temurtas/Capstone_Duayenler/reports/Std_HW/Std_HW.tex

%%%%%%%%%%%%%%%%%%%%%%%%%%%%%%%%%%%%%%%%%
% Weekly Report 
% LaTeX Template
% Version 1.3 (26/10/2018)
% Modified by
% Enes TAŞTAN
% Erdem TUNA
% Halil TEMURTAŞ
%%%%%%%%%%%%%%%%%%%%%%%%%%%%%%%%%%%%%%%%%
%
%----------------------------------------------------------------------------------------
%	PACKAGES AND OTHER DOCUMENT CONFIGURATIONS
%----------------------------------------------------------------------------------------
\documentclass[a4paper,12pt]{article}
%-----packages------
\usepackage[a4paper, total={6.2in, 8.5in}, headheight=110pt]{geometry}
\usepackage[english]{babel}
\usepackage[utf8x]{inputenc}
\usepackage{amsmath}
\usepackage{graphicx}
\usepackage[colorinlistoftodos]{todonotes}
\usepackage{gensymb} % this could be problem
\usepackage{float}
\usepackage{fancyref}
\usepackage{subcaption}
\usepackage[toc,page]{appendix} %appendix package
\usepackage{xcolor}
\usepackage{listings}

\usepackage[export]{adjustbox}

\usepackage{xspace}
\usepackage{amssymb}
\usepackage{nicefrac}
\usepackage{gensymb}
\usepackage{fancyhdr}
\usepackage{lipsum}  % for lipsum
\usepackage[final]{pdfpages}  % pdf include
\usepackage{array} %allows more options in tables
\usepackage{pgfplots,pgf,tikz} %coding plots in latex
\usepackage{capt-of} % allows caption outside the figure environment
\usepackage[export]{adjustbox} %more options for adjusting the images
\usepackage{multicol,multirow,slashbox} % allows tables like table1
%\usepackage[hyperfootnotes=false]{hyperref} % clickable references
\usepackage{epstopdf} % useful when matlab is involved
%\usepackage{placeins} % prevents the text after figure to go above figure with \FloatBarrier 
%\usepackage{listingsutf8,mcode} %import .m or any other code file mcode is for matlab highlighting

%-----end of packages
\input{../../Documents/configuration.tex}

\pagestyle{fancy}
\setlength\headheight{130pt}
\setlength{\footskip}{2.5cm}
\fancyhead[LO,LE]{\textbf{Duayenler Ltd. Şti.} \\ \textbf{Members :\\ } 
			Enes Taştan, \ \ \  2068989, 0543 683 4336 \\ 
			Halil Temurtaş, 2094522, 0531 632 2194  		
}
\fancyhead[RO,RE]{
			\textbf{November 19, 2018} \\
			Sarper Sertel, 2094449, 0542 515 6039 \\
			Erdem Tuna, 2167419, 0535 256 3320 \\ 
			İlker Sağlık, 2094423, 0541 722 9573}
%\fancyhead[RO]{Sarper Sertel (05435156039),\\Enes Taştan (05436834336), Erdem Tuna (05352563320),\\Halil Temurtaş (05316322194), İlker Sağlık (05417229573)}
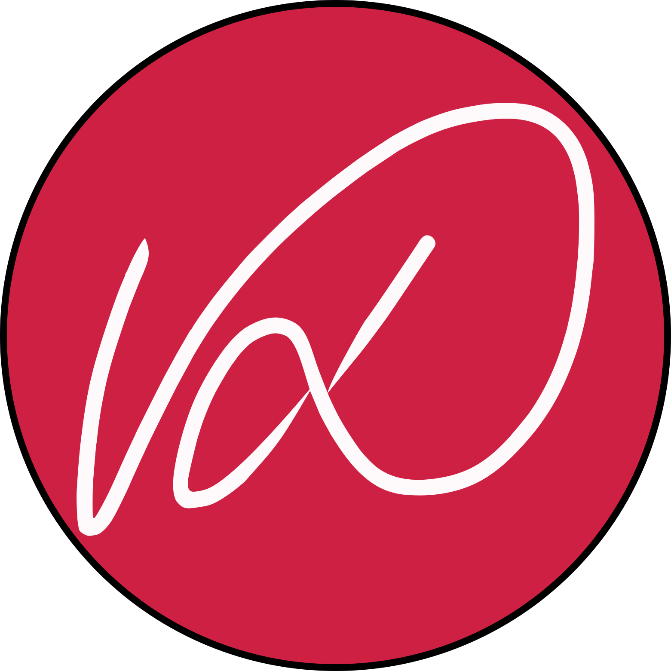
[picture p82: Documents/logos/logo2-page-with-stroke.png]
\rfoot{}

\begin{document}

	\begin{figure}[H]
		\centering
		\setlength{\unitlength}{\textwidth} 
		
	\end{figure}
	
\vspace*{0.5cm}
\begin{center}
	\Large\textbf{Standard Committee Homework}
	\end{center}

\section{Standard Committee Homework}
\subsection{Path Structure}

Our proposed material is styrofoam. Isolation type styrofoams are more durable and strong compared to ordinary ones. A sample can be seen in \textit{Figure \ref{strofor}}
\begin{figure}[h]
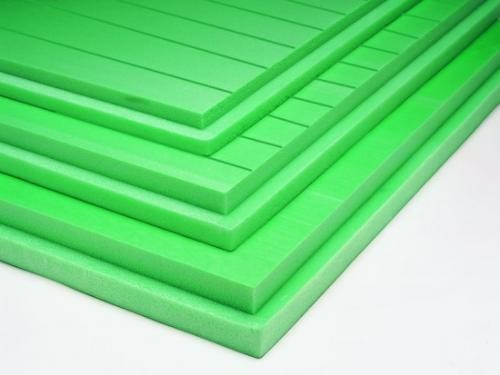
[picture p83: reports/Std_HW/strofor.jpg]
	
	\caption{A sample material}\label{strofor}
\end{figure}

The green color RGB(0,255,0) is proposed as the path color.

\subsection{Vehicle Appearance}

A plate with dimensions 8cm x 10 cm should be installed with 3cm levitation from ground level. The color of the plate should be blue RGB(0,0,255).

\end{document}

%----samples------
%\begin{itemize}
%\item Item
%\item Item
%\end{itemize}

%\begin{figure}[H]
%\center
%\setlength{\unitlength}{\textwidth} 
%\includegraphics[width=0.7\unitlength]{images/logo1}
%\caption{\label{fig:logo}Logo }
%\end{figure}

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
