temurtas/Capstone_Duayenler/reports/weekly_reports/2019_03_19_Weekly_Report/2019_03_05_Weekly_Report.tex

%%%%%%%%%%%%%%%%%%%%%%%%%%%%%%%%%%%%%%%%%
% Weekly Report 
% LaTeX Template
% Version 1.3 (26/10/2018)
% Modified by
% Enes TAŞTAN
% Erdem TUNA
% Halil TEMURTAŞ
%%%%%%%%%%%%%%%%%%%%%%%%%%%%%%%%%%%%%%%%%
%
%----------------------------------------------------------------------------------------
%	PACKAGES AND OTHER DOCUMENT CONFIGURATIONS
%----------------------------------------------------------------------------------------
\documentclass[a4paper,12pt]{article}
%-----packages------
\usepackage[a4paper, total={6.2in, 8.5in}, headheight=110pt]{geometry}
\usepackage[english]{babel}
\usepackage[utf8x]{inputenc}
\usepackage{amsmath}
\usepackage{graphicx}
\usepackage[colorinlistoftodos]{todonotes}
\usepackage{gensymb} % this could be problem
\usepackage{float}
\usepackage{fancyref}
\usepackage{subcaption}
\usepackage[toc,page]{appendix} %appendix package
\usepackage{xcolor}
\usepackage{listings}

\usepackage[export]{adjustbox}

\usepackage{xspace}
\usepackage{amssymb}
\usepackage{nicefrac}
\usepackage{gensymb}
\usepackage{fancyhdr}
\usepackage{lipsum}  % for lipsum
\usepackage[final]{pdfpages}  % pdf include
\usepackage{array} %allows more options in tables
\usepackage{pgfplots,pgf,tikz} %coding plots in latex
\usepackage{capt-of} % allows caption outside the figure environment
\usepackage[export]{adjustbox} %more options for adjusting the images
\usepackage{multicol,multirow,slashbox} % allows tables like table1
%\usepackage[hyperfootnotes=false]{hyperref} % clickable references
\usepackage{epstopdf} % useful when matlab is involved
%\usepackage{placeins} % prevents the text after figure to go above figure with \FloatBarrier 
%\usepackage{listingsutf8,mcode} %import .m or any other code file mcode is for matlab highlighting

%-----end of packages
\input{../../../documents/configuration.tex}

\pagestyle{fancy}
\setlength\headheight{130pt}
\setlength{\footskip}{2.5cm}
\fancyhead[LO,LE]{\textbf{Duayenler Ltd. Şti.} \\ \textbf{Members :\\ } 
			Enes Taştan, \ \ \  2068989, 0543 683 4336 \\ 
			Halil Temurtaş, 2094522, 0531 632 2194  		
}
\fancyhead[RO,RE]{
			\textbf{March 19, 2019} \\
			Sarper Sertel, 2094449, 0542 515 6039 \\
			Erdem Tuna, 2167419, 0535 256 3320 \\ 
			İlker Sağlık, 2094423, 0541 722 9573}
%\fancyhead[RO]{Sarper Sertel (05435156039),\\Enes Taştan (05436834336), Erdem Tuna (05352563320),\\Halil Temurtaş (05316322194), İlker Sağlık (05417229573)}
\rfoot{}

\begin{document}
	
\begin{figure}
	\vspace*{-.7cm}
	\centering
	\begin{figure}[H]
		\centering
		\setlength{\unitlength}{\textwidth} 
		
	\end{figure}
\end{figure}
\vspace*{-1.7cm}
\begin{center}
	\Large\textbf{March 12 - March 18 Weekly Report}
	\end{center}
\section{Progress}
\begin{itemize}
 
	 \item Chassis assembly is refined and finalized.
	 \item Step up and step down converters are imported to the system. However, they burnt out.
	 \item Vehicle drive with controller is tested. Some of problems were: PWM output of pins were not identical, small PWM difference yielded big voltage difference in motor drivers. This problem took a long time to fix.
	 \item Two distance sensors for handshake are implemented on the vehicle and tested with software.

	\end{itemize}
\section{Plans}
\begin{itemize}
\item PID controller design parameter tuning.

	\begin{figure}[H]
	\center
	\setlength{\unitlength}{\textwidth} 
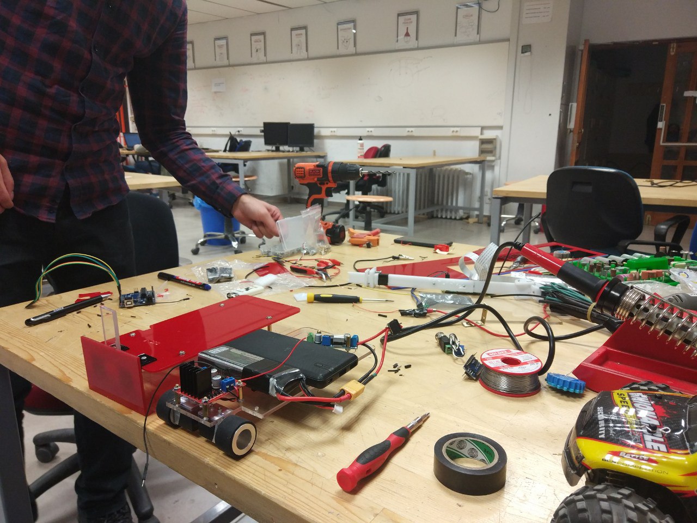
[picture p85: reports/weekly_reports/2019_03_19_Weekly_Report/photo5776198910077939979.jpg]
	
	\caption{\label{fig:photo5776198910077939979} As Chassis is being Assembled. }
\end{figure}

	\begin{figure}[H]
		\center
		\setlength{\unitlength}{\textwidth} 
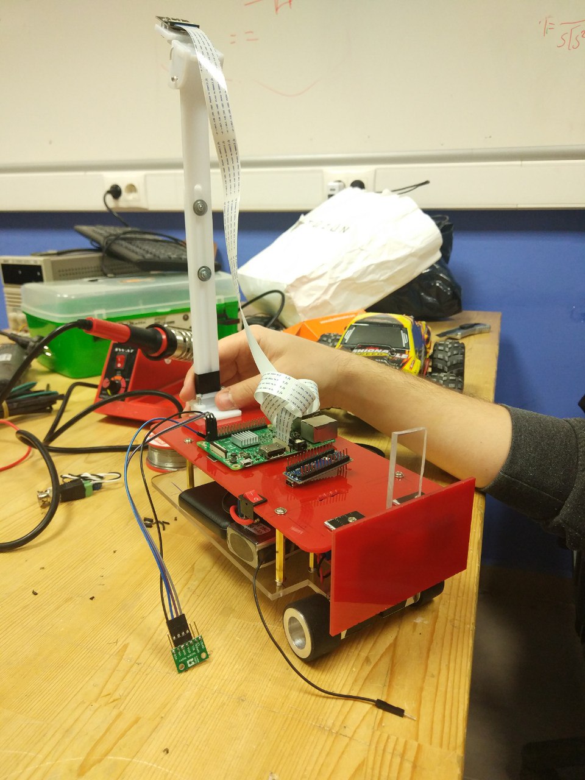
[picture p86: reports/weekly_reports/2019_03_19_Weekly_Report/photo5776198910077939977.jpg]
		
		\caption{\label{fig:photo5776198910077939977} Chassis Assembly }
	\end{figure}
		
\end{itemize}
%\begin{appendices}
%\section{Photos}
%
%	\begin{figure}[H]
%		\center
%		\setlength{\unitlength}{\textwidth} 
%		\includegraphics[width=0.75\unitlength]{efso}
%		\caption{\label{fig:efso} [Left]Output of Our Image Detection Algorithm Under Low Light Conditions, The Red Lines represents the Detected Line Edges  and the [Right] Original unprocessed Photo }
%	\end{figure}

%\end{appendices}

\end{document}

%----samples------
%\begin{itemize}
%\item Item
%\item Item
%\end{itemize}

%\begin{figure}[H]
%\center
%\setlength{\unitlength}{\textwidth} 
%\includegraphics[width=0.7\unitlength]{images/logo1}
%\caption{\label{fig:logo}Logo }
%\end{figure}

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
