temurtas/Capstone_Duayenler/reports/weekly_reports/2019_02_26_Weekly_Report/2019_02_26_Weekly_Report.tex

%%%%%%%%%%%%%%%%%%%%%%%%%%%%%%%%%%%%%%%%%
% Weekly Report 
% LaTeX Template
% Version 1.3 (26/10/2018)
% Modified by
% Enes TAŞTAN
% Erdem TUNA
% Halil TEMURTAŞ
%%%%%%%%%%%%%%%%%%%%%%%%%%%%%%%%%%%%%%%%%
%
%----------------------------------------------------------------------------------------
%	PACKAGES AND OTHER DOCUMENT CONFIGURATIONS
%----------------------------------------------------------------------------------------
\documentclass[a4paper,12pt]{article}
%-----packages------
\usepackage[a4paper, total={6.2in, 8.5in}, headheight=110pt]{geometry}
\usepackage[english]{babel}
\usepackage[utf8x]{inputenc}
\usepackage{amsmath}
\usepackage{graphicx}
\usepackage[colorinlistoftodos]{todonotes}
\usepackage{gensymb} % this could be problem
\usepackage{float}
\usepackage{fancyref}
\usepackage{subcaption}
\usepackage[toc,page]{appendix} %appendix package
\usepackage{xcolor}
\usepackage{listings}

\usepackage[export]{adjustbox}

\usepackage{xspace}
\usepackage{amssymb}
\usepackage{nicefrac}
\usepackage{gensymb}
\usepackage{fancyhdr}
\usepackage{lipsum}  % for lipsum
\usepackage[final]{pdfpages}  % pdf include
\usepackage{array} %allows more options in tables
\usepackage{pgfplots,pgf,tikz} %coding plots in latex
\usepackage{capt-of} % allows caption outside the figure environment
\usepackage[export]{adjustbox} %more options for adjusting the images
\usepackage{multicol,multirow,slashbox} % allows tables like table1
%\usepackage[hyperfootnotes=false]{hyperref} % clickable references
\usepackage{epstopdf} % useful when matlab is involved
%\usepackage{placeins} % prevents the text after figure to go above figure with \FloatBarrier 
%\usepackage{listingsutf8,mcode} %import .m or any other code file mcode is for matlab highlighting

%-----end of packages
\input{../../../documents/configuration.tex}

\pagestyle{fancy}
\setlength\headheight{130pt}
\setlength{\footskip}{2.5cm}
\fancyhead[LO,LE]{\textbf{Duayenler Ltd. Şti.} \\ \textbf{Members :\\ } 
			Enes Taştan, \ \ \  2068989, 0543 683 4336 \\ 
			Halil Temurtaş, 2094522, 0531 632 2194  		
}
\fancyhead[RO,RE]{
			\textbf{February 26, 2019} \\
			Sarper Sertel, 2094449, 0542 515 6039 \\
			Erdem Tuna, 2167419, 0535 256 3320 \\ 
			İlker Sağlık, 2094423, 0541 722 9573}
%\fancyhead[RO]{Sarper Sertel (05435156039),\\Enes Taştan (05436834336), Erdem Tuna (05352563320),\\Halil Temurtaş (05316322194), İlker Sağlık (05417229573)}
\rfoot{}

\begin{document}
	
\begin{figure}
	\vspace*{-.7cm}
	\centering
	\begin{figure}[H]
		\centering
		\setlength{\unitlength}{\textwidth} 
		
	\end{figure}
\end{figure}
\vspace*{-1.7cm}
\begin{center}
	\Large\textbf{February 19 - 25 Weekly Report}
	\end{center}
\section{Progress}
\begin{itemize}
	\item Lane detection tests were conducted with different disturbances on different locations of the path. Possible detection errors were again analysed. An example case can be seen at \textit{Figure~\ref{fig:lane-analysis-1}}.

		\begin{figure}[H]
			\center
			\setlength{\unitlength}{\textwidth} 
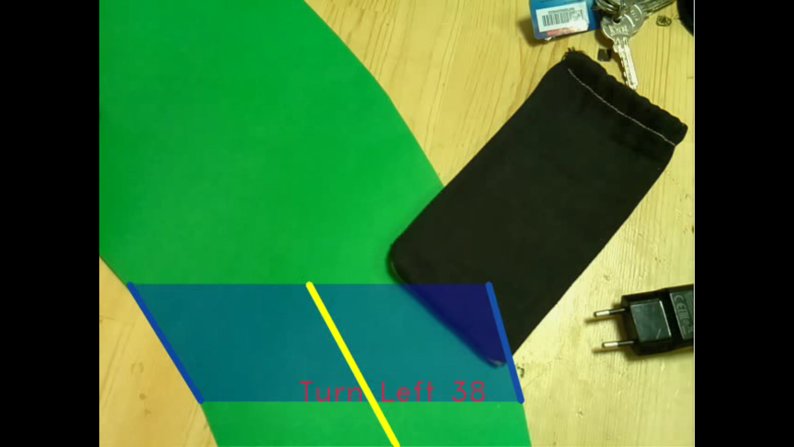
[picture p87: reports/weekly_reports/2019_02_26_Weekly_Report/lane_det.png]
			
			\caption{\label{fig:lane-analysis-1} Possible Problem on the Path and the Algorithm Output}
		\end{figure}
			
	 \item The chassis parts were drawn in Solidworks. And the placements of the components on top of the chassis were discussed. The main components can be seen from the \textit{Figure~\ref{fig:chass}}. The mounting bracket for the motor can be seen at \textit{Figure~\ref{fig:brac}}. 
	 
	 \item Initial consideration on system modelling via Bump Test were discussed. A simulink model was drawn for the expected overdamped system with pure delay. The model can be seen from the \textit{Figure~\ref{fig:cont}}.  
    
	    \begin{figure}[H]
			\center
			\setlength{\unitlength}{\textwidth} 
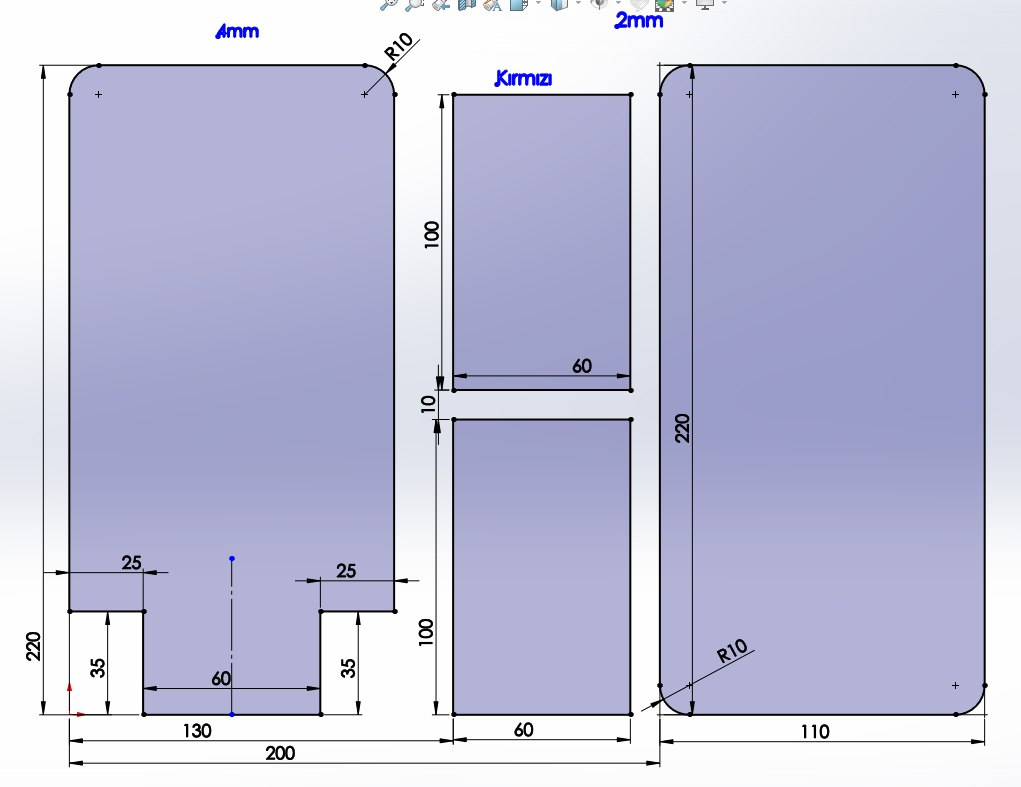
[picture p88: reports/weekly_reports/2019_02_26_Weekly_Report/sasi.jpg]
			
			\caption{\label{fig:chass} Main Components of the Chassis}
		\end{figure}
		
		\begin{figure}[H]
			\center
			\setlength{\unitlength}{\textwidth} 
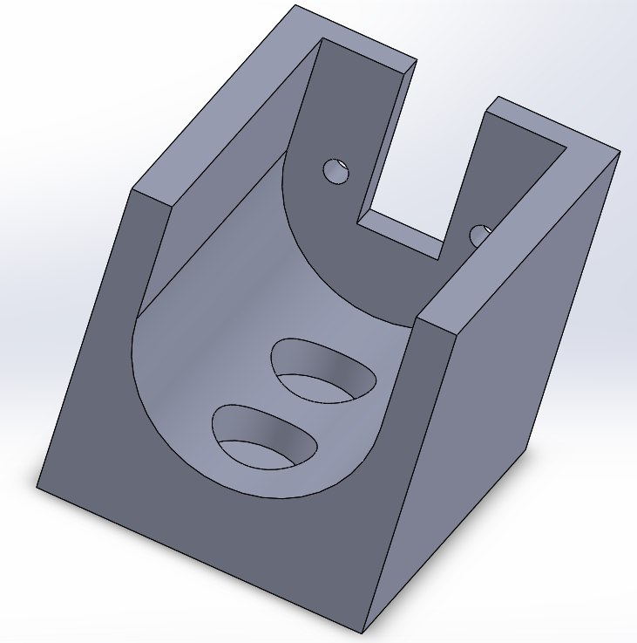
[picture p89: reports/weekly_reports/2019_02_26_Weekly_Report/motor_conn.jpg]
			
			\caption{\label{fig:brac} Mounting Bracket for the Motor}
		\end{figure}

		\begin{figure}[H]
			\center
			\setlength{\unitlength}{\textwidth} 
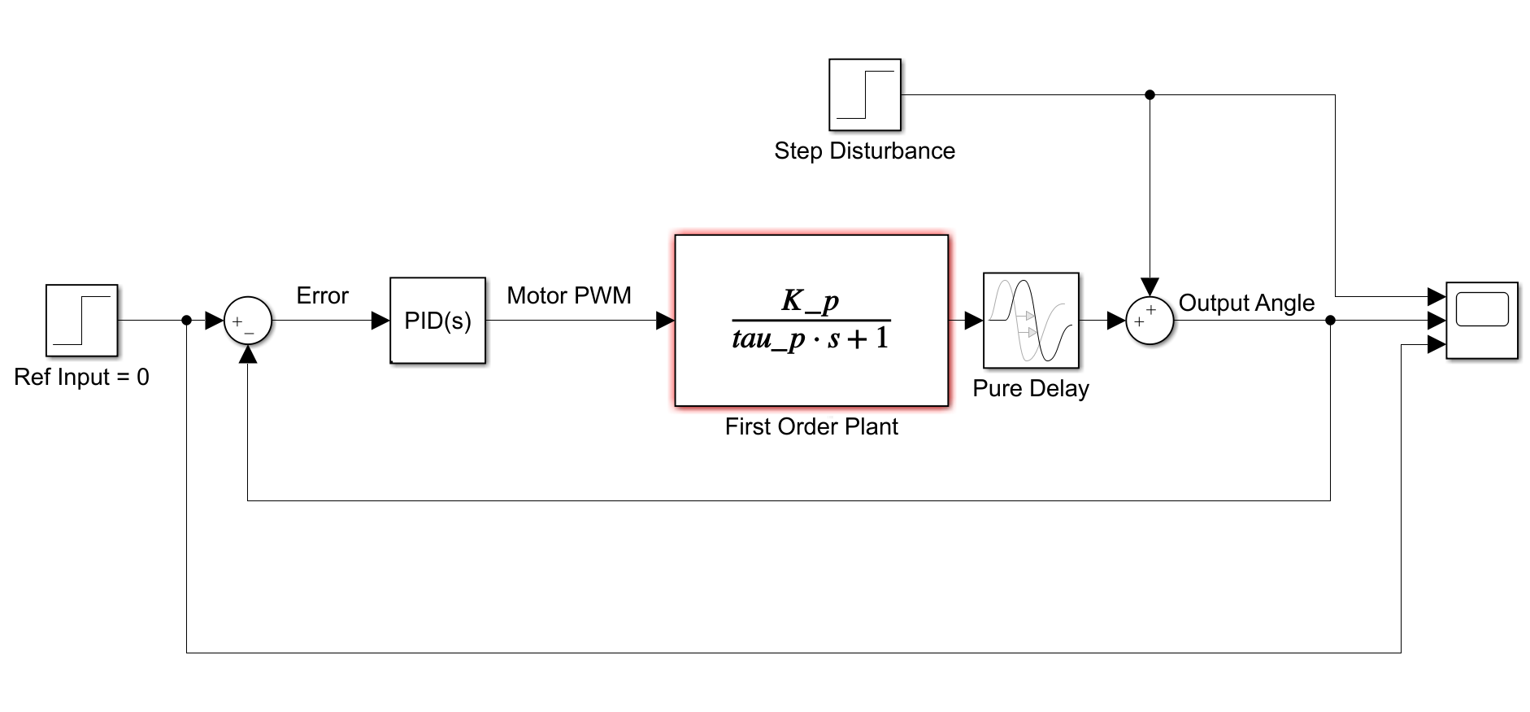
[picture p90: reports/weekly_reports/2019_02_26_Weekly_Report/cont.png]
			
			\caption{\label{fig:cont} A Simulink Model for the Expected Overdamped System}
		\end{figure}
	
	\end{itemize}
\section{Plans}
\begin{itemize}
\item New chassis will be built.
\item Initial attempts to tune PID controller for the lateral movement of the vehicle.  
\end{itemize}

\section{Problems}
\begin{itemize}
	\item The method for getting step response step response. Two alternatives can be seen from \textit{Figures~\ref{fig:bump1}~\&~\ref{fig:bump2}}.
\end{itemize}

		\begin{figure}[H]
			\center
			\setlength{\unitlength}{\textwidth} 
			
			\caption{\label{fig:bump1} A Bump Test Set-Up for Distance Control System }
		\end{figure}

		\begin{figure}[H]
			\center
			\setlength{\unitlength}{\textwidth} 
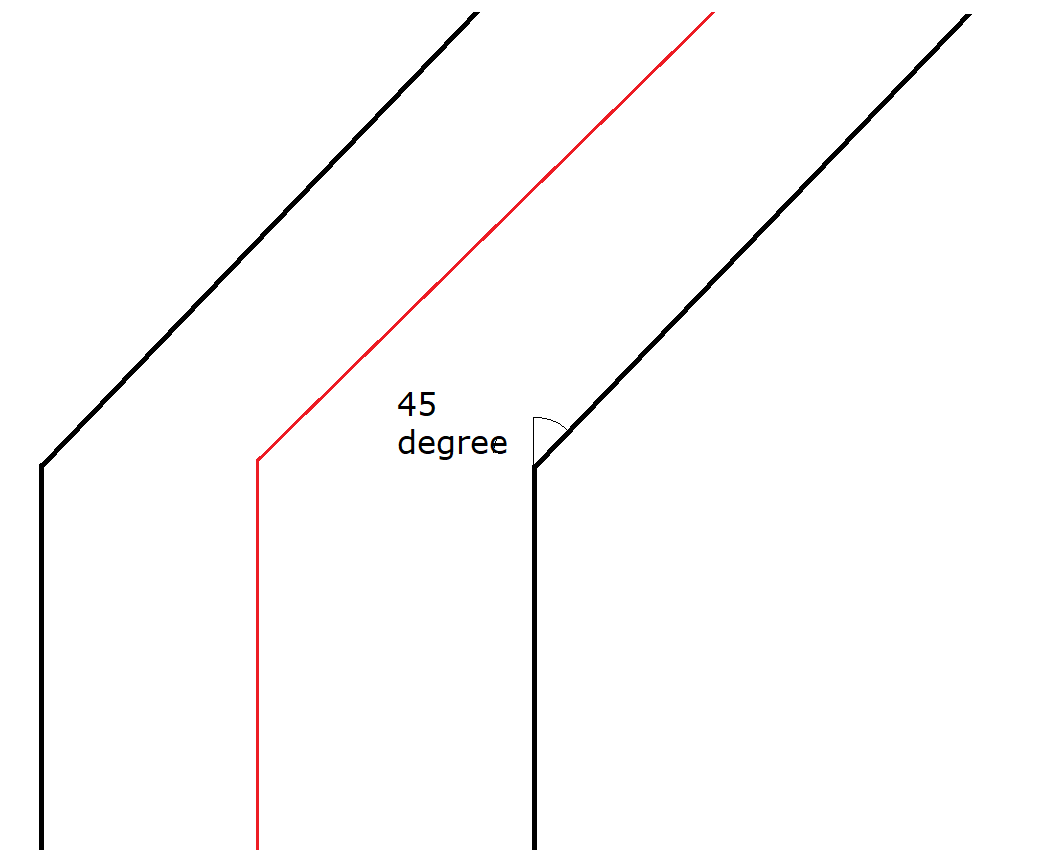
[picture p91: reports/weekly_reports/2019_02_26_Weekly_Report/bump_test_ang.png]
			
			\caption{\label{fig:bump2} A Bump Test Set-Up for Angle Control System}
		\end{figure}

%\begin{appendices}
%\section{Photos}
%
%	\begin{figure}[H]
%		\center
%		\setlength{\unitlength}{\textwidth} 
%		\includegraphics[width=0.75\unitlength]{efso}
%		\caption{\label{fig:efso} [Left]Output of Our Image Detection Algorithm Under Low Light Conditions, The Red Lines represents the Detected Line Edges  and the [Right] Original unprocessed Photo }
%	\end{figure}

%\end{appendices}

\end{document}

%----samples------
%\begin{itemize}
%\item Item
%\item Item
%\end{itemize}

%\begin{figure}[H]
%\center
%\setlength{\unitlength}{\textwidth} 
%\includegraphics[width=0.7\unitlength]{images/logo1}
%\caption{\label{fig:logo}Logo }
%\end{figure}

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
