temurtas/Capstone_Duayenler/resources/expenses.md

### Expenses

Expenses are listed below. 
Please write only the name (not surname) with same capitalization!

| Buyer  | Item  | Cost  | Paid Back?  |
|---|---|---|---|
| Enes | Asma Kilit  | 6 TL |  **YES**  |
| Sarper | Kalemx2 | 12 TL  | **YES**  |
| Halil  | Component | 151.55 TL  | **YES**  |
| Enes | Component | 189.55 TL  | **YES**  |
| Enes | Anahtar Çekimi | 10 TL  | **YES**  |
| İlker  | Colored A4  | 2.5 TL  | **YES** |
| Enes | RC Car | 150 TL  | **YES**  |
| Sarper | motor-teker | 150 TL  | **YES**  |
| Erdem  | Kamera_2 | 123.77 TL | **YES** |
| Enes | camera holder | 50 TL  | **YES**  |
| Enes | Strafor | 24 TL  | **YES**  |
| Erdem | Rapor | 13 TL  | **YES**  |
| Halil | Robotistan | 208.43 TL | **YES** | 
| Enes | Konnektör | 5 TL |**YES**| 
| Enes | ikinci sensör + nano | 155 TL | **NO**| 
| Sarper | İğrenÇ karton | 32 TL  | **NO**  |
| Enes | şase giderleri | 55 TL  | **NO**  |
| Sarper | ilk şase pleksi | 40 TL  | **NO**  |
| Halil | Yapıştırıcı/Karton vs. | 75 TL | |**NO**|
| Enes | Motor | 185.76 TL |**NO**|
| Enes | Robotistan (27 şubat)  | 114.71 TL  | **NO**  |
| İlker | Sensor | 66.58 TL | **NO** |
| Erdem | Köpük | 51.60 TL | **NO** |
----------------------------------------

Aşağısı Totaller

| Person | Total Spent  | Average Spent  | Debt  |
|---|---|---|---|
| Erdem  | 51.6 TL | 155.13 TL | -103.53 TL | 
| Enes | 510.47 TL | 155.13 TL | +355.34 TL  |
| Halil  | 75 TL | 155.13 TL | -80.13 TL |
| Sarper | 72 TL | 155.13 TL | -83.13 TL |
| İlker  | 66.58 TL | 155.13 TL | -88.55 TL |
