temurtas/Capstone_Duayenler/reports/final_report/deliverables.docx

LIST OF DELIVARABLES

Deliverables of the product is listed as follows;

- Kobra 6.5 robot
- Li-Po batteries
- Li-Ion batteries
- Lane
- Flash stick with sofware
- User Manual
- USB Cable
