temurtas/Capstone_Duayenler/reports/conceptual_presentation/Duayenler_Conceptual_Presentation_Ilker.pptx

Vehicle Detection & External Communication
Subsystems

## Vehicle Detection Subsystem

- Problem
  - Detecting the opponent to be caught within 5cm range
  - Detecting the opponent if it reaches from back within 5cm
  - Giving meaningful data to Pi to trigger handshake protocol

DUAYENLER

## Vehicle Detection Subsystem

- Main Solution
  - Two time-of-flight distance sensors at the front and back

DUAYENLER

## Vehicle Detection Subsystem (Tests)


DUAYENLER

## External Communication System

- Problem
  - Communicating with the opponent via Wi-Fi protocol
  - Executing handshake protocol

DUAYENLER

## External Communication System

- Main Solution
  - An algorithm utilizing network programming

DUAYENLER

## External Communication System

- Main Solution
  - An algorithm utilizing network programming


DUAYENLER

## External Communication System(Results)

Duayenler as server:


Opponent as client:


DUAYENLER

## External Communication System(Results)

Duayenler as client:


Opponent as server:


DUAYENLER

## External Communication System

- Improvements to be done:
  - Distance sensor data should be added to the system
  - Client should not be connected to the hotspot manually
  - Client mode function should be able to run before server

DUAYENLER
