temurtas/Capstone_Duayenler/docs/reports/Duayenler_Proposal.pdf

Middle East Technical University

Department of

Electrical and Electronics Engineering

EE493 ENGINEERING DESIGN I

# Car Chasing Robot

# Proposal Report

### Supervisor: Assoc. Prof. Emre Ozkan ¨

### METU EE / C-112

Project Start: 4/10/2018
Project End: 26/5/2019
Project Budget: $450

Company Name : Duayenler Ltd. S¸ti.

Members | Title | ID | Phone
Sarper Sertel | Electronics Engineer | 2094449 0542 515 6039
Enes Ta¸stan | Hardware Design Engineer | 2068989 0543 683 4336
Erdem Tuna | Embedded Systems Engineer 2617419 0535 256 3320
Halil Temurta¸s Control Engineer | 2094522 0531 632 2194
˙Ilker Sa˘glık | Software Engineer | 2094423 0541 722 9573

### November 9, 2018

This page intentionally left blank.

1

## Contents

1 Executive Summary | 4
2 Introduction | 5
3 The Team | 5
4 Requirement Analysis | 7
5 Standards Section | 14
6 Solution Procedure | 15

2

7 Expected Deliverables | 20
8 Conclusion | 21
Appendix A Gannt Chart | 22

3

## 1 Executive Summary

Increasing demand on automobiles, encourages industry to produce more. The increase of car count in the traffic, makes the traffic flow more complex. In this scope, autonomous cars bring an innovative solution for reducing the complexity. Potential benefits of automated cars include smart use of fuel, safer traffic and increased mobility. To realize and come up with such solutions, DUAYENLER Ltd. S¸ti. (DUAYENLER) is founded by

five innovative and enthusiast electronics engineering students to intelligently automate the future of traffic.

DUAYENLER is composed of talented and diligent people from different disciplines to complete the envisioned problem. DUAYENLER consists of two engineers from computer area, two from electronics area and one from control area. Since realization of the problem requires combinations of different disciplines, DUAYENLER is qualified to accomplish the encountered problems.

DUAYENLER will address the need of autonomous cars. Thus, the aim of the proposed project is to design and construct a vehicle that can follow a closed path without a driver on board. Furthermore, the vehicle will be able to sense other vehicles on the road as well as handling the obstacles.

The vehicle will use camera vision and sensors to detect and understand environment. With the obtained data, the vehicle will operate in a way that it adjusts its direction and speed correctly. Additionally, if the vehicle detects another vehicle within 5 cm either at the front or at the back, it will activate the handshake protocol to communicate with the opponent and stop with positive signal.

The duration of the project is intended to last 33 weeks, starting from October, 1 2019 and ending in May, 26 2019. The estimated cost for research and development phase is $ 450 whereas mass production cost per vehicle will be at most $ 200. Along with the vehicle itself, DUAYENLER will provide its customers with deliverables such as user and technical manuals, elliptical race path, chargeable battery and battery charger. Also, the vehicle will have two (2) years of warranty.

4

## 2 Introduction

Driving is a common event that many people experience in their daily life. As time passes, human reflexes started to become insufficient for driving compared to fast pace of daily life in modern world. Together with the developments in the technology, new solutions are proposed to assist the driver such as lane tracking and emergency breaking systems. The ultimate version of such solutions are considered to be fully autonomous self-driving cars.

Self-driving vehicles are presented to the society as a solution that can facilitate people’s life in many ways. Fast operation of the electronics system allows faster response than humans can. A fast and a reliable operation of self-driving action can prevent many accidents and increase the safety of the roads in heavy traffics since the system is immune to human defects such as distraction and panic. As a result, autonomous vehicles can open doors to a safer and more conventional future.

DUAYENLER Ltd. S¸ti.(DUAYENLER) is launched with the aim of innovating au-

tomation technologies. In that context, a device that can detect the road and other vehicles on them will be built. It autonomously track the lane and stay on the road while trying to be as fast as possible.

This report includes;

- Organization of the company by explaining of the qualifications of the members.
- Requirements for physically realizing the intended vehicle
- Possible solutions in system and subsystem levels by explaining their operations
- Timeline and estimated budget of the project
- Expected deliverables of the project

## 3 The Team

DUAYENLER was founded in September 2018 by five electrical and electronics engineering students from Middle East Technical University. The company structure is shown in Figure 1. The team is composed of variously skilled visionary members. The leader of the team is Halil Temurta¸s, a control engineer.

5

Being the team leader, Halil manages the organization of the members as well as drawing an outline for the future calendar. He is experienced in using microcontrollers, device testing and project scheduling. He has experience in TAI as an intern engineer in product testing and in product design in ”Very Light Aircraft” project that gives him the understanding of the project management. And his EE300 summer practice, he gained experience in using Raspberry Pi and Arduino while building a sun follower robot. He will be working on the development of the subsystems computation, motion and driving in parallel with his experiences.

Sarper Sertel, electronics engineer, has a wide understanding of microelectronics circuits and their design as well as analog lumped circuits. He has experience in electronic maintenance of jet fighters which includes sensors and electromechanical systems integration. He has also experience in analog circuit design, specifically power electronics, which can be useful in designing driving unit elements. He is also interested in mechanical systems such as structure organization.

Enes Ta¸stan, hardware design engineer, has experience in many types of mechanical works such as assembly and repair works from family business. In addition, he worked on PCB design of power electronics circuits in his internship. He is interested in control of electromechanical systems. Considering his specializations, driving, motion and structure unit can be listed as most relevant subsystem he can work on.

Erdem Tuna, embedded systems engineer, is experienced in use of microcontrollers with sensors and wireless communication between them. He also simulated 4G and 5G mobile networks using C++ based open source software. Thus, he is experienced in programming and will be contributing to subsystems requiring coding and developing algorithms. He will take part in computation and sensing subsystems.

˙Ilker Sa˘glık, software engineer, is also interested in programming and microcon-

trollers. He has some programming experiences with different languages such as C,C++,Verilog, Assembly etc. He also has experiences with coding with Arduino using sensors. In his internship, he worked for the communication protocols between radars. He will be working
on sensing and driving subsystems.

6

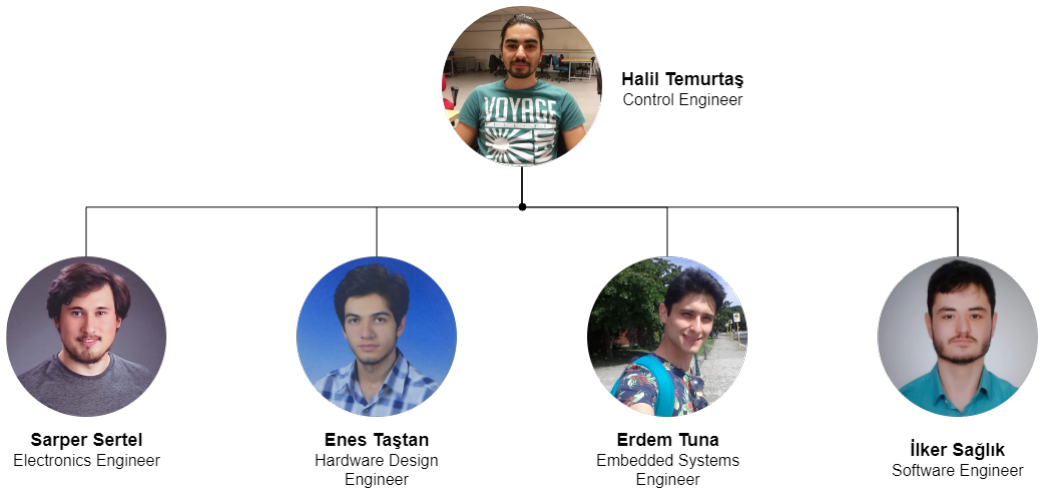
[picture p156: figure]

Figure 1: Company Tree of DUAYENLER.

## 4 Requirement Analysis

### 4.1 Pairwise Comparisons for Project Selection

First, objectives of the project should be determined to select the project in a reasonable way. Pairwise comparisons technique can be used to assess the objectives of the project. Then, these objectives would be very useful in the assessment of the projects. As a result of the assessments, the desired project can be selected out of the rest. For this purpose, Table 1 and Table 2 are created with the consensus of all company members. The weighted objectives are then used to construct the weighted objective tree in Figure 2.

Table 1: Pairwise Comparison Charts

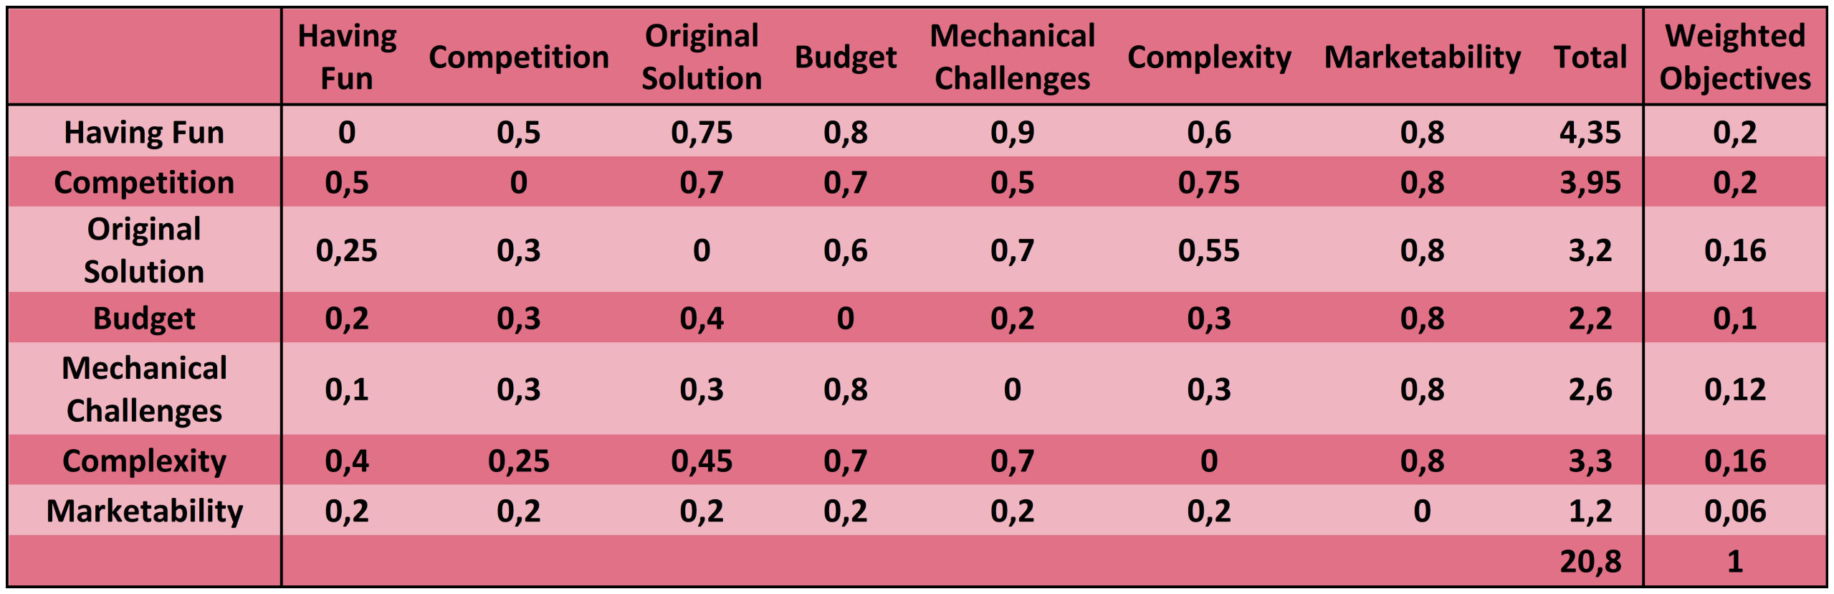
[picture p157: figure]

0-0.2: No Importance, 0.2-0.4: Less Importance, 0.4-0.6: Equal Importance, 0.6-0.8: More Importance, 0.8-1: Absolute Importance

7

To determine the relative importances of objectives, the used method is as follows: If everyone is agreed on the importance value, that value is assigned as the comparison result. If there is a conflict between the members, the average of the proposed values are assigned as the importance of corresponding objective.


Figure 2: Weighted Objective Tree

### 4.2 Project Selection

After selecting the objectives for the project, the possible projects were rated by the project members in a defined scale. The Table 2 is constructed by using the same methodology as in the objective tree. The result of this chart is then used to choose which project will be developed. According to the Table 2, Chasing Car project is suited best for the objectives of the DUAYENLER. Thus, the Chasing Car project is chosen.

Table 2: Project Evaluation Chart

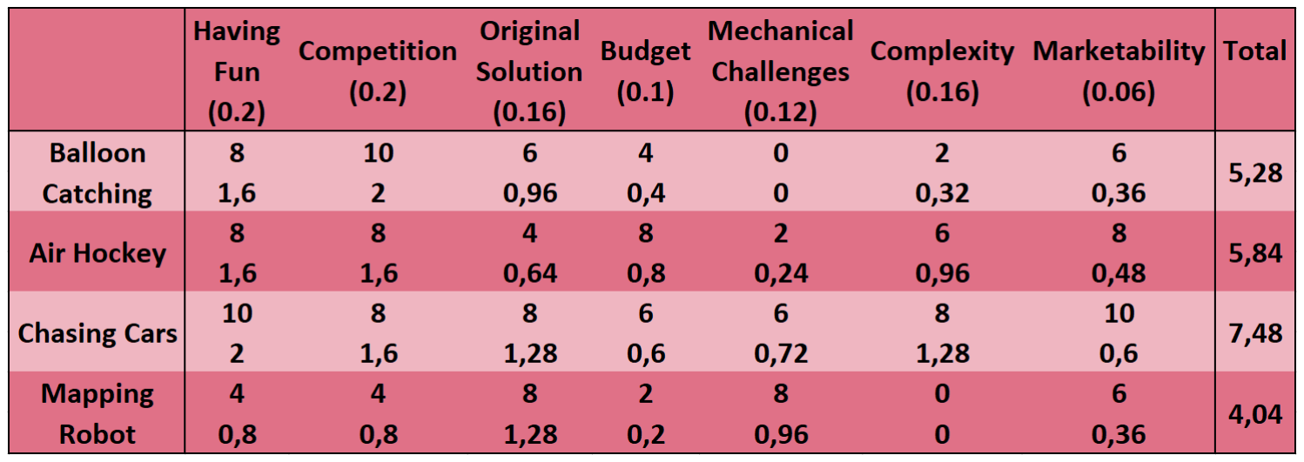
[picture p158: figure]

0: Failure, 2: Unacceptable, 4: Average, 6: Satisfactory, 8: Good, 10: Excellent

8

The aim of DUAYENLER is first to realize the project within the scope of the requirements. The foreseen mass manufactured cost of the project is limited to $200. However, the research and development phase will cost up to $450. The project is

expected to finish within 33 Weeks period, The proposed Gannt Chart for the project can be seen at Appendix A.

### 4.3 Statement of the Problem

The aim of the project is to design and construct a robot that can compete in a elliptic path with a similar robot in autonomous way.
From this definition, it can be deduced that the robot should,
- detect start signal
- detect path it is following
- compute the curvature of the road
- adjust wheels & speed
- catch the opponent
- activate handshake protocol
- stop

### 4.4 Pairwise Comparisons for Solution Selection

In order to be able to compare the proposed solutions for the project, weighted objectives for the solutions should be formed to complete this task in a logical manner. The pairwise comparison chart for the solution objectives in Table 3 is formed using same methodology that was used to construct the pairwise comparison chart for project objectives. Afterwards, the weighted objective tree at Figure 3 is formed using the objectives selected.

9

Table 3: Pairwise Comparison Charts for Sub-Objectives

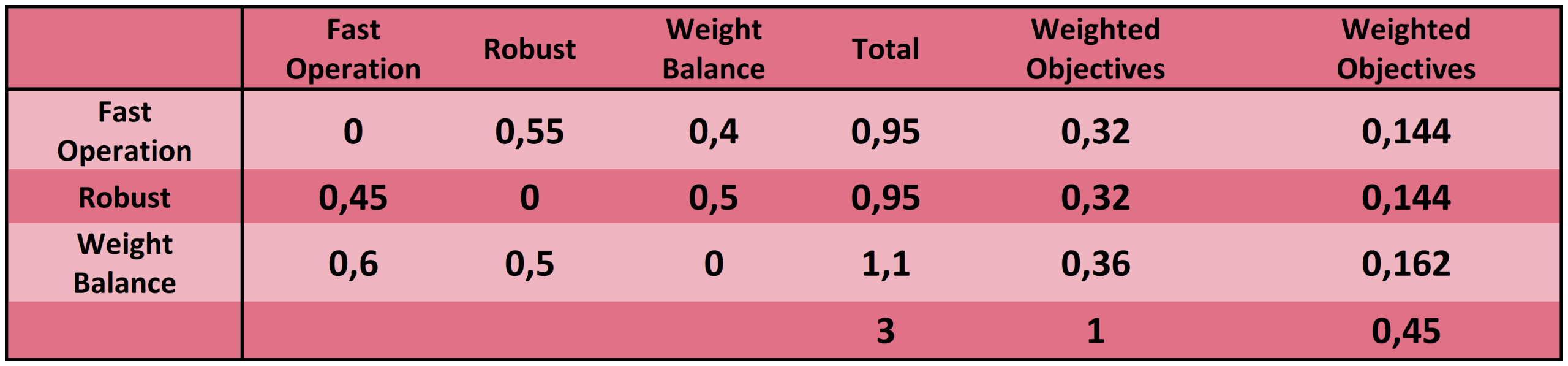
[picture p159: figure]

0-0.2: No Importance, 0.2-0.4: Less Importance, 0.4-0.6: Equal Importance, 0.6-0.8: More Importance, 0.8-1: Absolute Importance


Figure 3: Weighted Objective Tree

### 4.5 Systems & Subsystems of Chosen Project

After choosing the project, the systems and subsystems of the project is determined by the group members. While disassembling the project to its systems, it is decided that the project will be investigated under two main parts, electrical and mechanical systems. Then, the electrical unit is then divided into three parts, that is, sensing, computation

10 and driving subsystems. The mechanical system is also divided into two parts, that is, motion and structure subsystems. The system diagram of the chosen project can be seen at Figure 4. System tree of the project can be seen at Figure 5.

Figure 4: System Diagram for the Chosen Project


Figure 5: Systems & Subsystems of Chosen Project

### 4.6 Solution Alternatives for Systems & Subsystems

Following the division of the project into its sub-blocks, solution alternatives are created for these subsystems and units.

- It is decided that the line detection unit will use sensor array to detect the borders of the path. The array might be consist of color sensors of infrared sensors. A camera might also be used to back up the sensor array for more reliable operation.
- Vehicle detection unit might utilize ultrasonic, infrared distance sensors or camera

in order to identify the opponent.

- Arduino, Raspberry Pi or Asus Thinkerboard can be utilized as a microcontroller

by the data processing unit.

- The controller unit can adopt P,PI or PID controller.

11

- Motor unit might consist of brushed or brushless motors.
- The project might consists of three wheels (two of them are driven by DC motors and one of them is a ball caster), palette system(4+ Wheels) or four wheels (two of them driven by DC motors and two front wheels directed by servo motors)
- Speed unit might use only the output of the lane detection unit or the output data

can be combined with gyroscope that can detect disturbances for speed reduction.

- Direction unit might benefit from the advantages of differential drive or can com-

bine these benefits with the servo motors that can determine the position of the front wheels.

The solution alternatives for units in compact form can be seen at Table 4.

Table 4: Possible Solution Alternatives for the Units of the Project

Unit | Possible Solution 1 Possible Solution 2 Possible Solution 3
Lane Detection | Color Sensor Array Infrared Sensor Array Infrared Sensor Array with Camera Support
Vehicle Detection | Laser sensor Ultrasonic sensor Camera to back of the vehicle
Data Processing | Raspberry Pi Arduino Asus Thinkerboard
Controller | P PI PID
Motors | Brushed Motors Brushless Motors
Wheels | 3 Wheels 4 Wheels 4 Wheels with Palette with Servo Motors
Speed | Lane Detection Gyroscope Output (Balance Detection)
Direction | Differential Drive Servo Motors for front wheels

12

### 4.7 Design Options

After determining the possible solution alternatives, it is decided that these alternatives might be combined into design packages that can be compared with each other by using the selection objectives determined earlier. In order the combine the solution ideas, three different design options according to their complexities are considered to ease the decision process. Named as design 1, most basic design is formed considering the simpler alternatives, design 2 is formed considering the more reasonable alternatives that would satisfy the expectations and the design 3 is formed considering the best possible outcome. The design alternatives in a comparable form can be seen at Table 5.

Table 5: Design Options for the Chosen Project

Unit | Design Option 1 | Design Option 2 | Design Option 3
Lane Detection | Color Sensor Array | Infrared Sensor Array | Infrared Sensor Array
| | | with Camera Support
Vehicle Detection | Camera to back
| of the vehicle | Ultrasonic sensor | Laser sensor
Data Processing | Arduino | Arduino | Raspberry Pi+
| | | Arduino
Controller | P | PI | PID
Motors | Brushed Motors | Brushed Motors | Brushed Motors
Wheels | 3 Wheels | 4 Wheels
| | with Palette | 4 Wheels
| | | with Servo Motors
Speed | Lane Detection
| Output | Lane Detection
| | Output | Lane Detection
| | | Output + Gyroscope
Direction | Differential Drive | Differential Drive | Servo Motors
| | | for front wheels

### 4.8 Pairwise Comparisons for Design Selection

The possible solution alternative at Table 6 are rated by using the weighted objective at Table 3. The methods used for project objectives is again used for pairwise comparison for the design selection.

13

As expected, the total ratings for possible solutions is very similar since the aim of the DUAYENLER was not to select the exact solution procedure in this state but to choose where should be started. It is intended by the group to start from the Design 1 that is the most basic one and improving the design in performance wise to reach the Design 2 or 3 by conducting more tests on vehicle.

Table 6: Pairwise Comparison Charts for Solution Selection

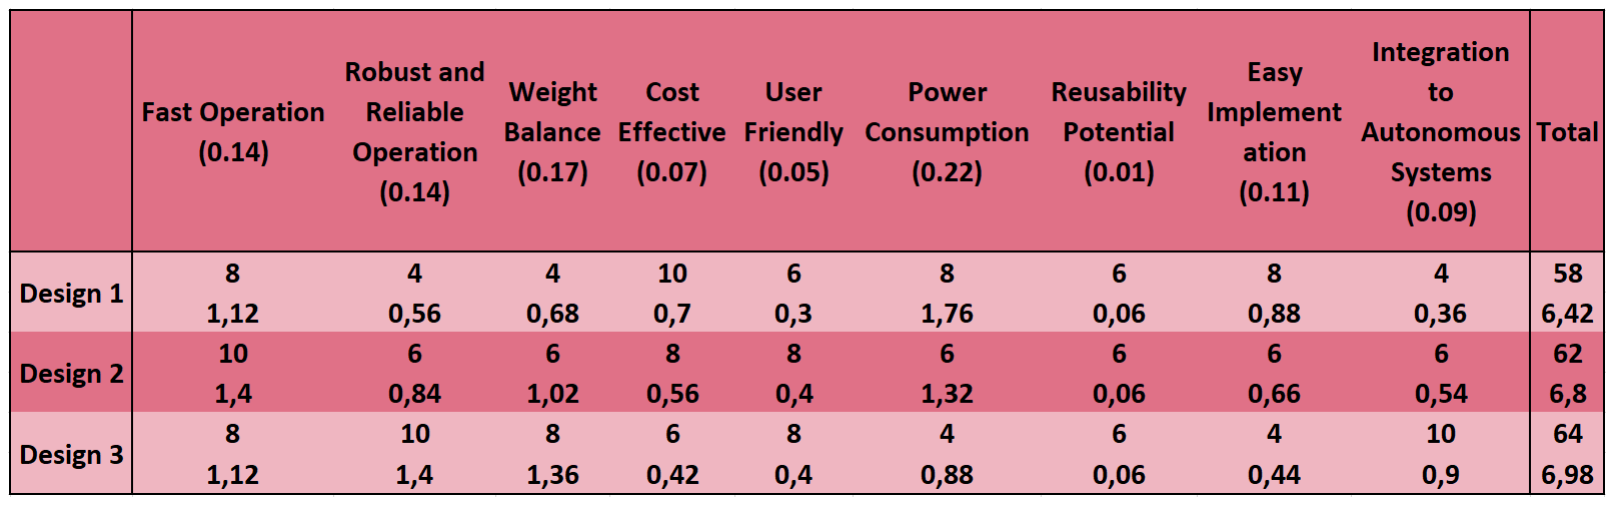
[picture p160: figure]

0: Failure, 2: Unacceptable, 4: Average, 6: Satisfactory, 8: Good, 10: Excellent

### 4.9 System Level Requirements

Under the light of the solutions, these system level requirements are constructed to achieve the customers needs.

- The robot should follow the path in any circumstances
- The robot should complete the elliptical path in less than 15 seconds
- The robot should not crash the opponent
- The robot should function in any direction
- The robot should follow the handshake protocol decided by the committee

## 5 Standards Section

Standards will be the base block that the project will be built on since standards draw a common base for the application. There are several issues should be standardized before development phase.
One of these issues is the handshake protocol. An option is using Bluetooth modules for the handshake. The vehicles can identify each other with a specific ID. Once the

14 distance between the two vehicles is less than 5 cm, both vehicles may send handshake signal to kill the motion. Benefit of this standard would be that each vehicle needs to have only one distance sensor on the back or on the front.

Elevation of the path is another problem that should be discussed. Infrared sensors can be utilized to sense the color of paths and surfaces. Some of the infrared sensors operate between 0 to 15 mm. To be able to use infrared sensors, path height should be in between the operation range of the sensors. After Standard Committee discussions, it can be decided to use infrared sensors or not.

Besides, start command of the vehicle should have a standard. One option is to use On/Off button to initiate operations on vehicle. Another option is to use of a global

command to be given from host device. Once the start command is received, vehicles can start to operate.

One last thing to consider is the braking duration of the vehicles. The braking duration of both vehicles should be within a pre-determined duration to avoid collision of the cars. Therefore, it should be standardized.

## 6 Solution Procedure

### 6.1 Milestones

Milestones are crucial steps to proceed in the development of the project. The steps of the project can be considered as successful, once the milestones are accomplished. The foreseen and planned milestones of the project are determined. The milestones are being able to,

- Move on a straight path
- Move on circular path
- Move without crashing any object
- Integrate camera vision to the vehicle
- Detect an elliptic path and moving on it

### 6.2 Sensing Subsystem

This unit has two main tasks which are observing lane and another vehicle on the path.

15

### 6.2.1 Lane Detection Unit

To solve this problem, path and environmental differences, such as color difference, contrast difference could be used. In addition to these, image processing could be an alternative to detection of lane and vehicle. Infrared sensors can be used to solve lane detection problem. Line follower vehicle logic can be implemented to this problem, by placing two sensor arrays to both sides of the path to align vehicle at the center. Sensors gives current proportional to reflection of the surfaces. By using such outputs, an algorithm is to be developed to track the path on the center.
Another approach to detect the lane is using camera and image processing. Camera can be placed at an angle to see the path, and by using the raspberry pi, the path can be followed. To clarify, captured frames can be analyzed by the raspberry pi, and utilizing open source image processing libraries. An example analysis can be summaries as follows: Firstly, distortions in the image can be beautified, and then color thresholding can be applied to sharply detect the elevated path. Optionally, to increase accuracy of the detection, Canny edge detection can be used. Lastly, center line can be calculated by using processed image.
Color sensor can be utilized as an alternative for image processing. Color sensors basically senses the color with the help of 8x8 array of photodiodes and generates a PWM signal whose duty cycle is proportional to the light intensity. For example, if the elliptic path is red, we can give the s2 and s3 pins of the sensor low voltage, we activate the red photodiodes and we can use the Arduino command to measure the on or off time of the generated PWM signal. When the robots are out of the path, the output duty cycle of the sensor will significantly decrease, so this information can be used to keep the robots in the path. However, using color sensors can be problematic, because of their size and slow operation.

### 6.2.2 Vehicle Detection Unit

The detection of the opponent can be implemented using distance sensors. In order to stop the robot when it catches the opponent, or it is caught, a sensor must be placed at the front and the back. The most common distance sensors are ultrasonic, infrared and laser sensors.
Ultrasonic sensors have acceptable range. They send a sound wave and take back the echo, then give a PWM voltage related to the distance. However, using ultrasonic sensors can cause problems if the opponent also uses ultrasonic sensors; because of the interference. Besides, when measurement is angled, measuring is failing.

16

Infrared sensors can be another approach to this problem, they may provide better accuracy. Moreover, Laser distance measurement can be applied to solve this problem. They have the best accuracy, but their price is the highest among the rest.

### 6.3 Computation Subsystem

Functionality of computation subsystem will be presented in this section.

### 6.3.1 Data Processing Unit

This unit is the main algorithm application level. Data from sensor will be aggregated in this unit and will be pre-processed. Then, processed data will be output to the controller unit. Processing will mainly be done using Arduino and Raspberry Pi (if used). Suitable

algorithms will be developed to realize desired operations with the controller unit

### 6.3.2 Controller Unit

Mathematical models will be implemented in this unit to realize controllers such as P, PI, PID. The output of the controller unit will be sent to driving subsystem. This output will be the ultimate decision to realize a desired operation according to the data sent from sensor.
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
