temurtas/Capstone_Duayenler/codes/homography/side.jpg

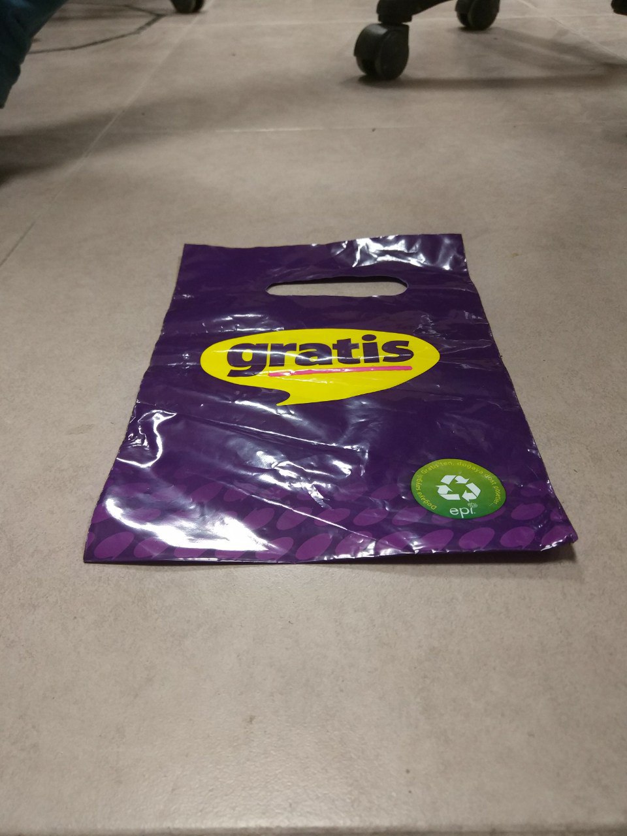
codes/homography/side.jpg
