temurtas/Capstone_Duayenler/codes/homography/top.jpg

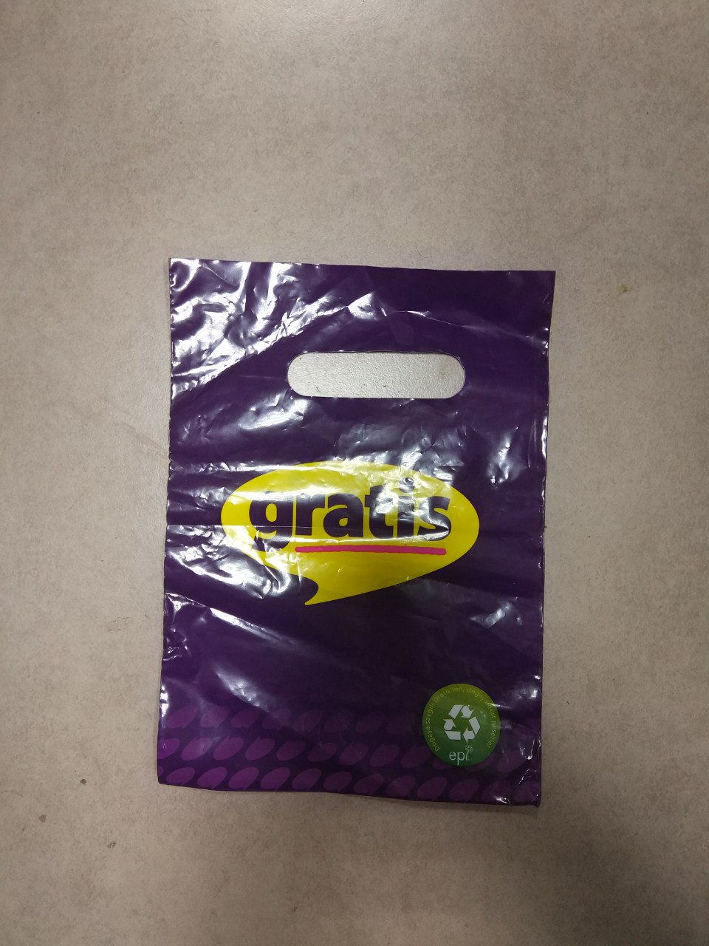
codes/homography/top.jpg
