temurtas/Capstone_Duayenler/docs/img/fair.jpg

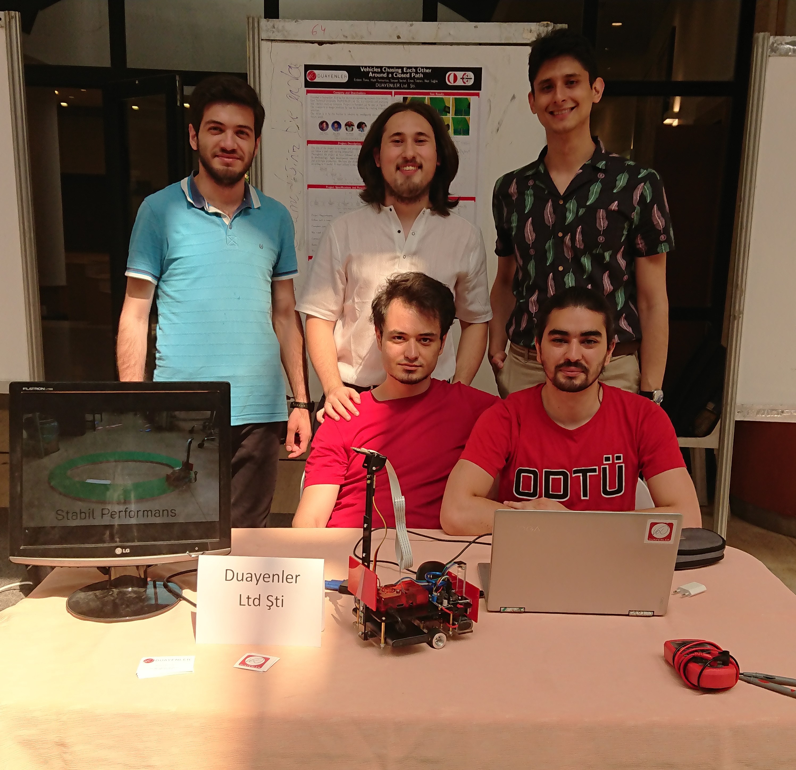
docs/img/fair.jpg
