temurtas/Capstone_Duayenler/docs/img/kobra.jpg

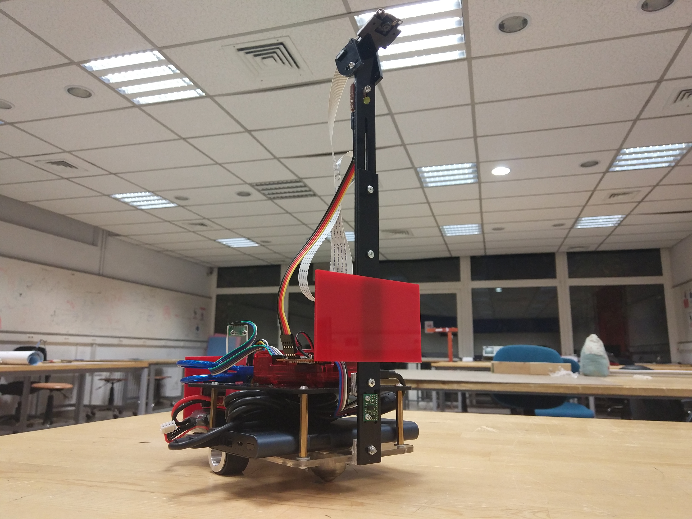
docs/img/kobra.jpg
