temurtas/Capstone_Duayenler/documents/company/bay_enes_round.png

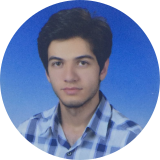
documents/company/bay_enes_round.png
