temurtas/Capstone_Duayenler/documents/company/bay_halil_round.png

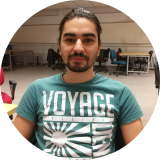
documents/company/bay_halil_round.png
