temurtas/Capstone_Duayenler/documents/company/bay_ilker_round.png

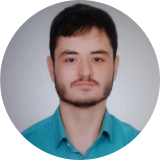
documents/company/bay_ilker_round.png
