temurtas/Capstone_Duayenler/documents/company/bay_sarper_round.png

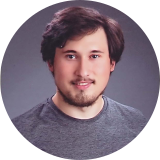
documents/company/bay_sarper_round.png
