temurtas/Capstone_Duayenler/documents/personal_data/profile_pictures/bay_halil.jpg

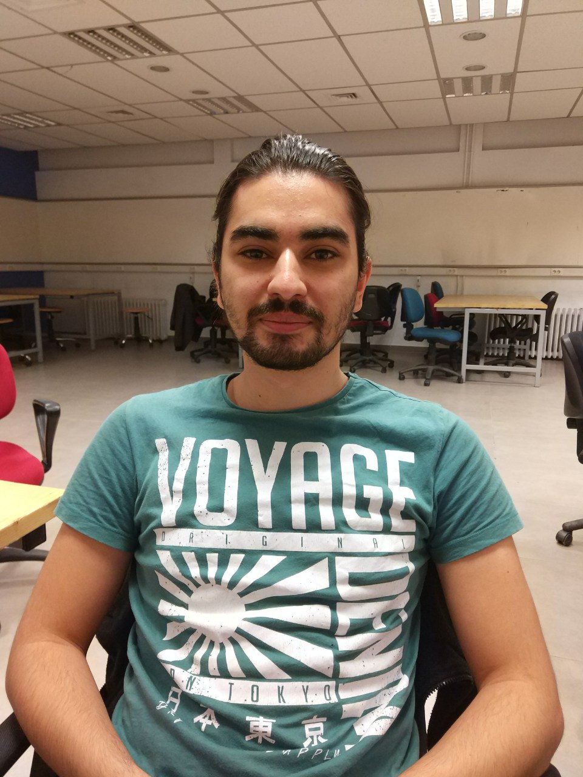
documents/personal_data/profile_pictures/bay_halil.jpg
