temurtas/Capstone_Duayenler/documents/personal_data/profile_pictures/bay_sarper.jpg

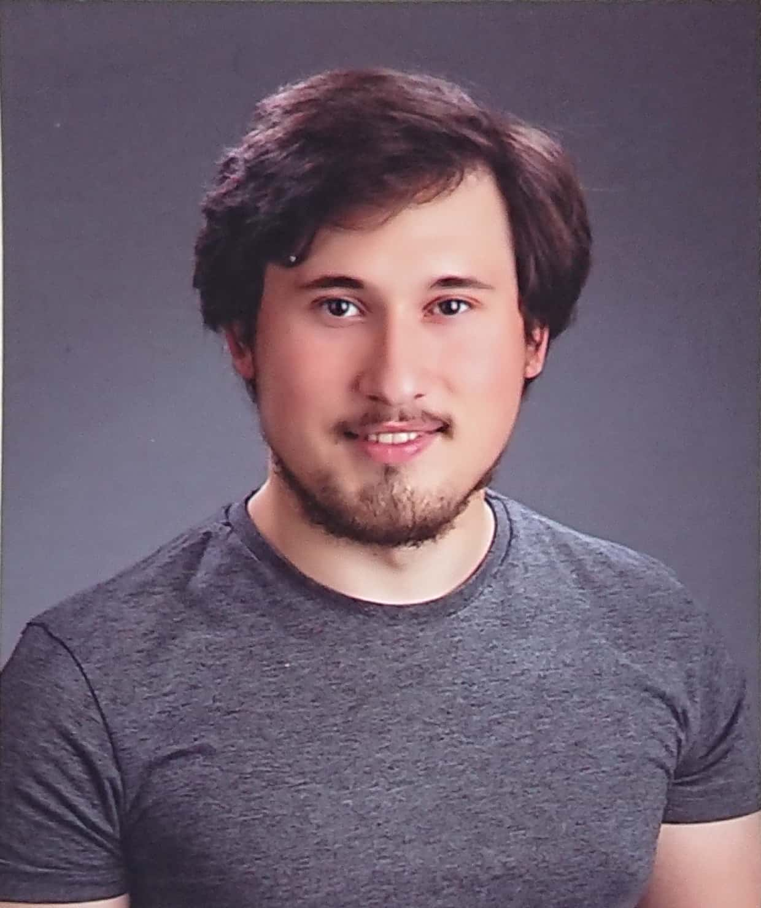
documents/personal_data/profile_pictures/bay_sarper.jpg
