temurtas/Capstone_Duayenler/documents/personal_data/profile_pictures/enes_foto.PNG

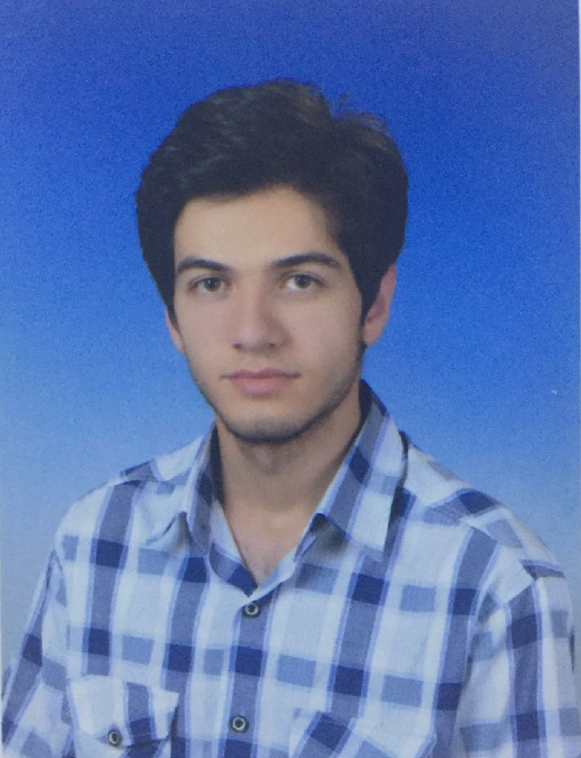
documents/personal_data/profile_pictures/enes_foto.PNG
