temurtas/Capstone_Duayenler/documents/personal_data/profile_pictures/erdem.jpg

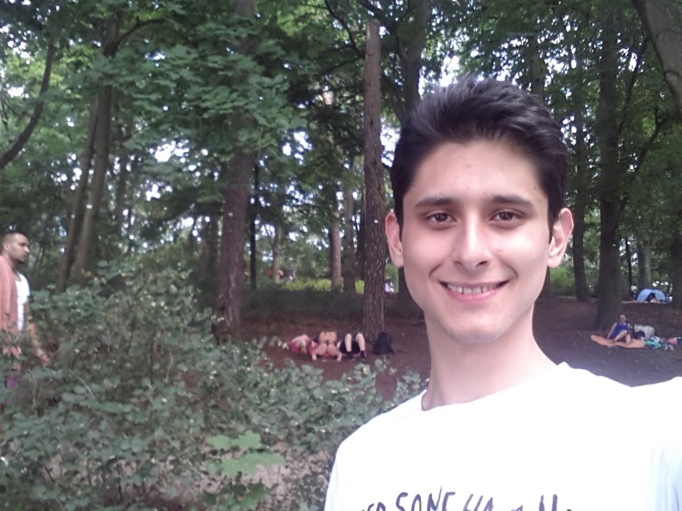
documents/personal_data/profile_pictures/erdem.jpg
