temurtas/Capstone_Duayenler/documents/personal_data/profile_pictures/erdem_foto.jpg

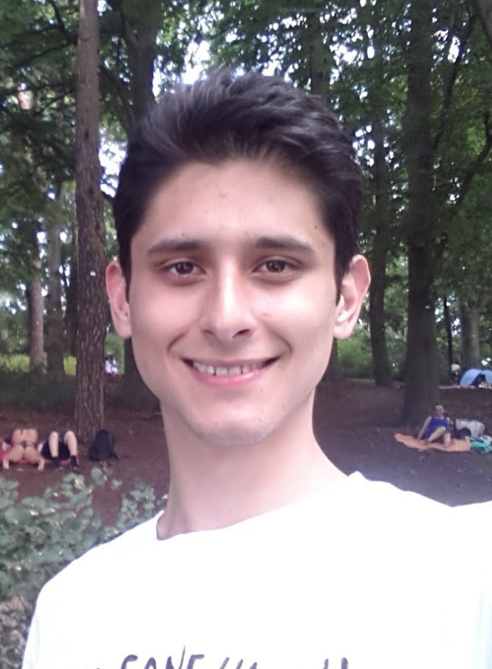
documents/personal_data/profile_pictures/erdem_foto.jpg
