temurtas/Capstone_Duayenler/documents/personal_data/profile_pictures/halil_foto.jpg

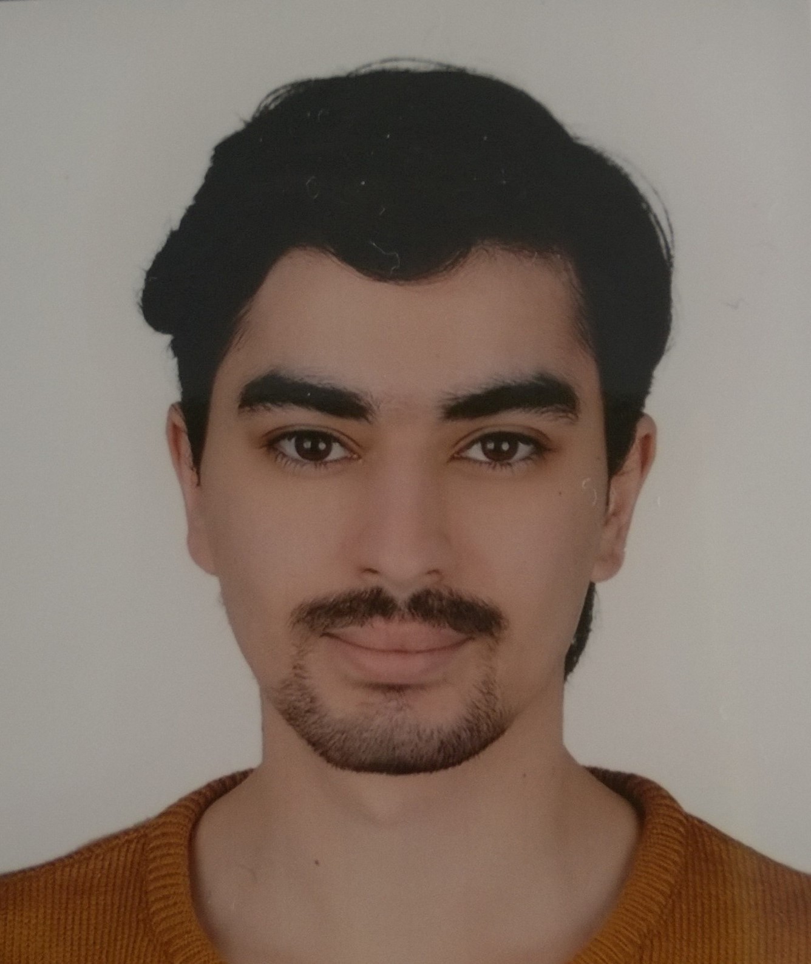
documents/personal_data/profile_pictures/halil_foto.jpg
