temurtas/Capstone_Duayenler/documents/personal_data/profile_pictures/ilker_foto.PNG

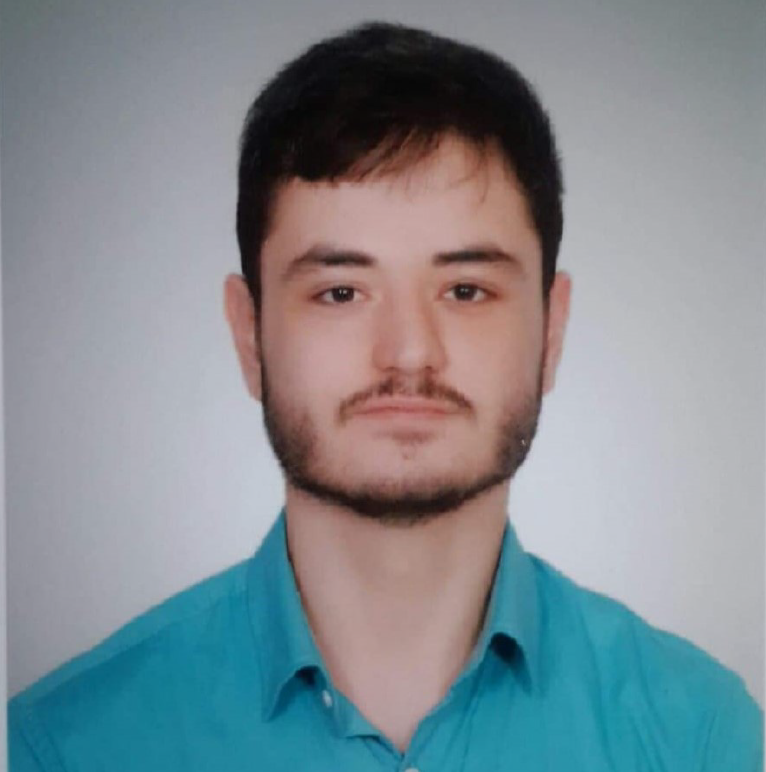
documents/personal_data/profile_pictures/ilker_foto.PNG
