temurtas/Capstone_Duayenler/documents/personal_data/profile_pictures/meeting1.jpg

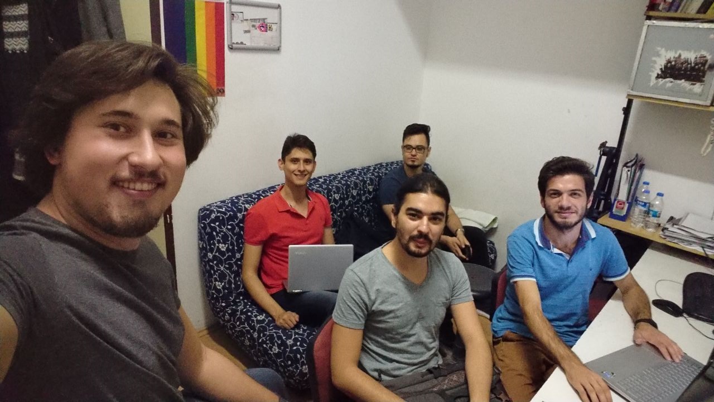
documents/personal_data/profile_pictures/meeting1.jpg
