temurtas/Capstone_Duayenler/documents/personal_data/profile_pictures/meeting3.jpg

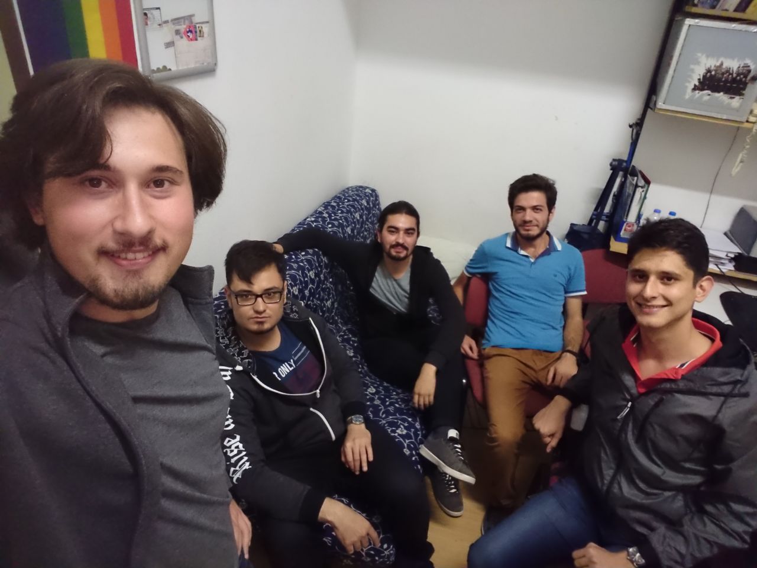
documents/personal_data/profile_pictures/meeting3.jpg
