temurtas/Capstone_Duayenler/documents/personal_data/profile_pictures/united-photo.png

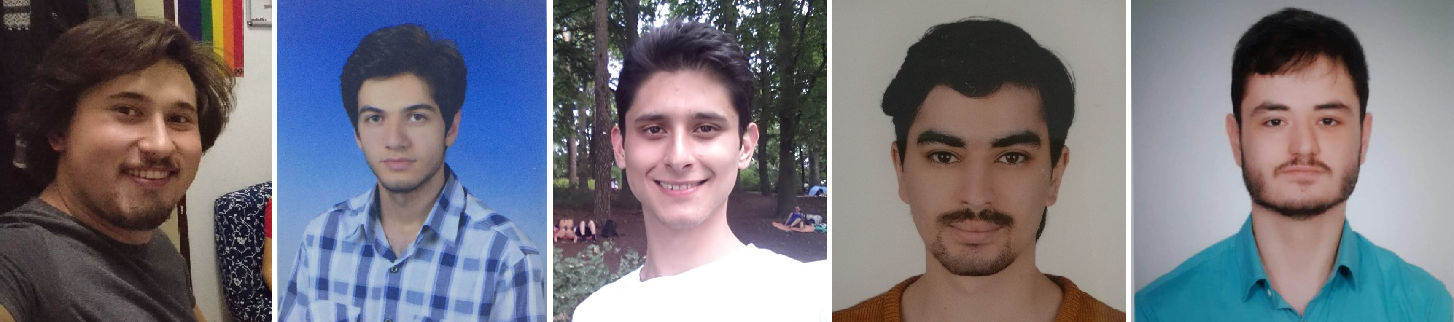
documents/personal_data/profile_pictures/united-photo.png
