temurtas/Capstone_Duayenler/documents/Standart_committee/2018_11_15_2.jpg

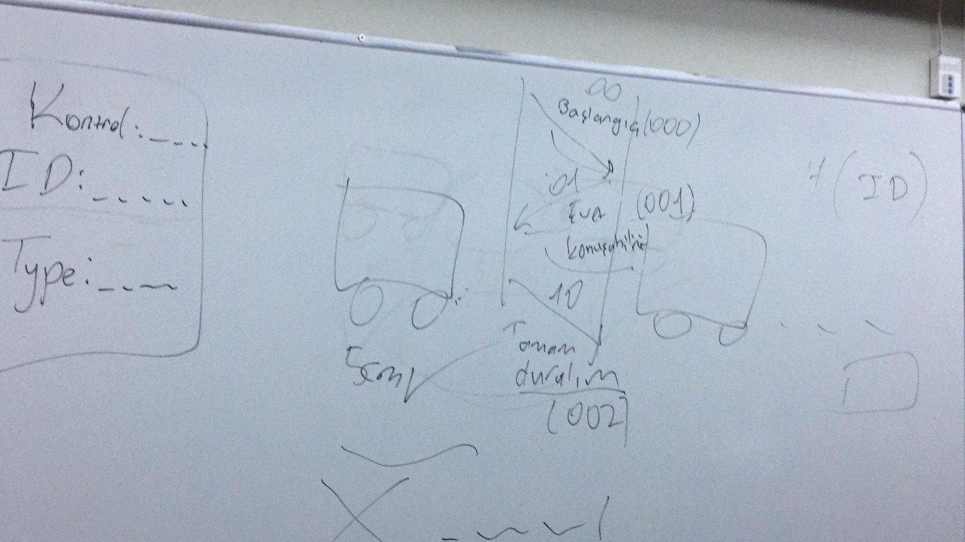
documents/Standart_committee/2018_11_15_2.jpg
