temurtas/Capstone_Duayenler/reports/conceptual_design_report/images/chassis1.jpg

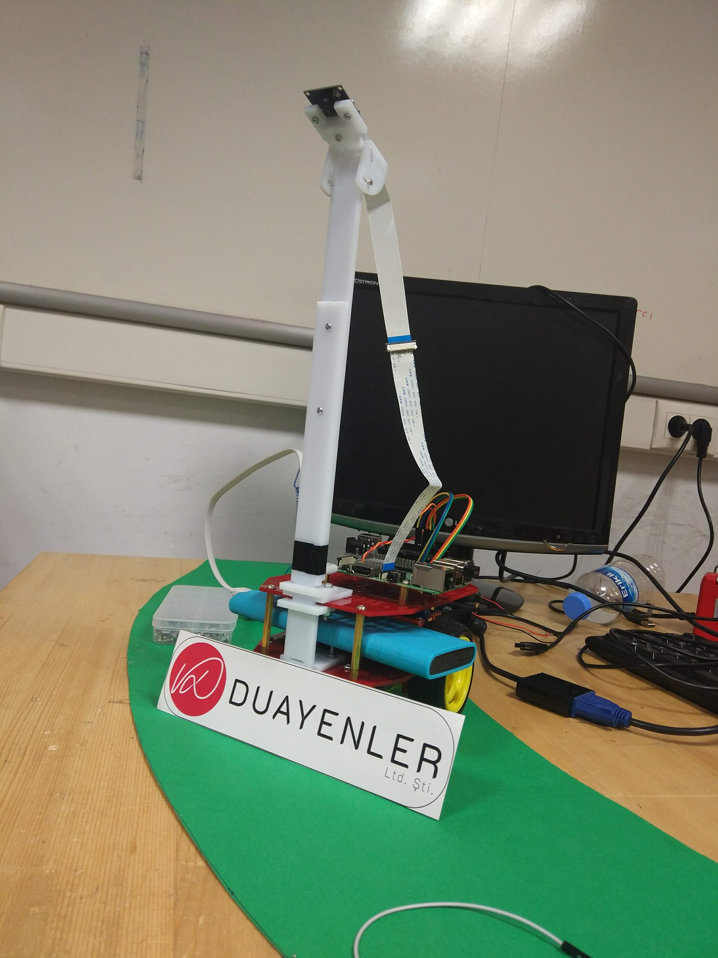
reports/conceptual_design_report/images/chassis1.jpg
