temurtas/Capstone_Duayenler/reports/conceptual_design_report/images/chassis2.jpg

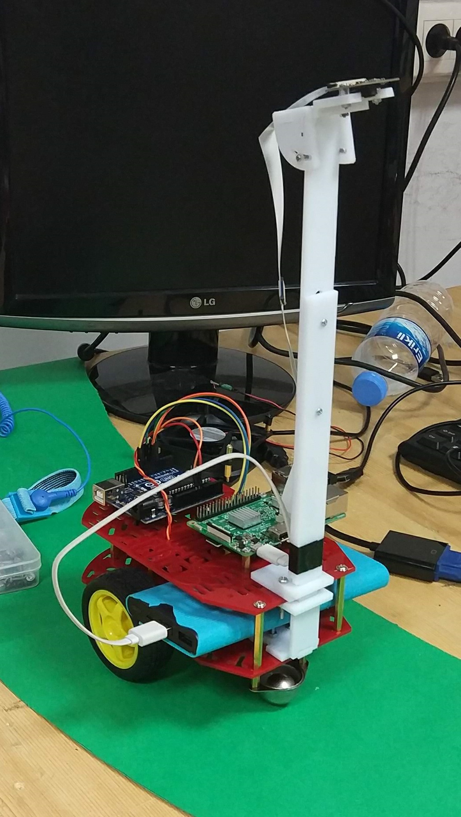
reports/conceptual_design_report/images/chassis2.jpg
