temurtas/Capstone_Duayenler/reports/conceptual_design_report/images/sensing_comp.png

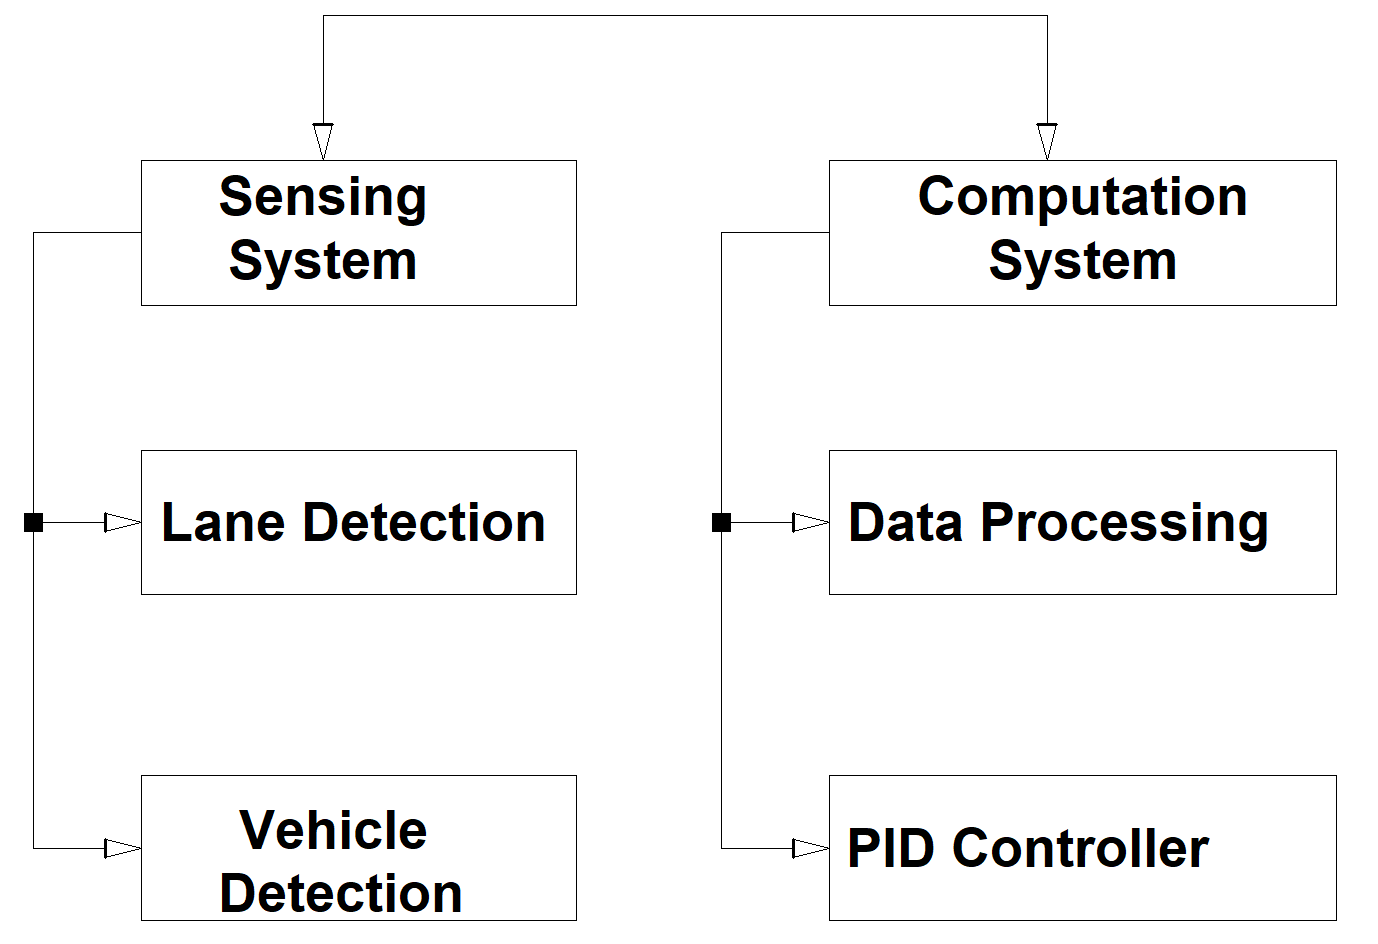
reports/conceptual_design_report/images/sensing_comp.png
