temurtas/Capstone_Duayenler/reports/conceptual_design_report/part_halil/cameraio.jpg

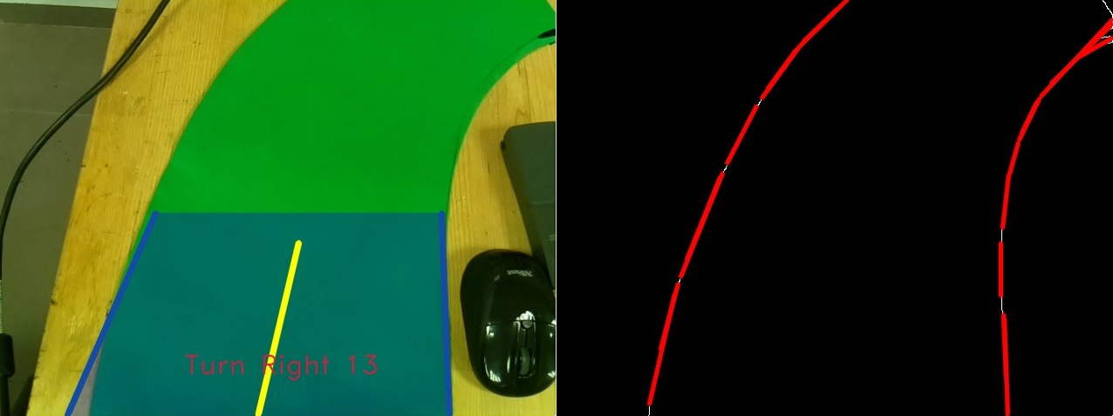
reports/conceptual_design_report/part_halil/cameraio.jpg
