temurtas/Capstone_Duayenler/reports/conceptual_design_report/system-diagram/system-diagram.png

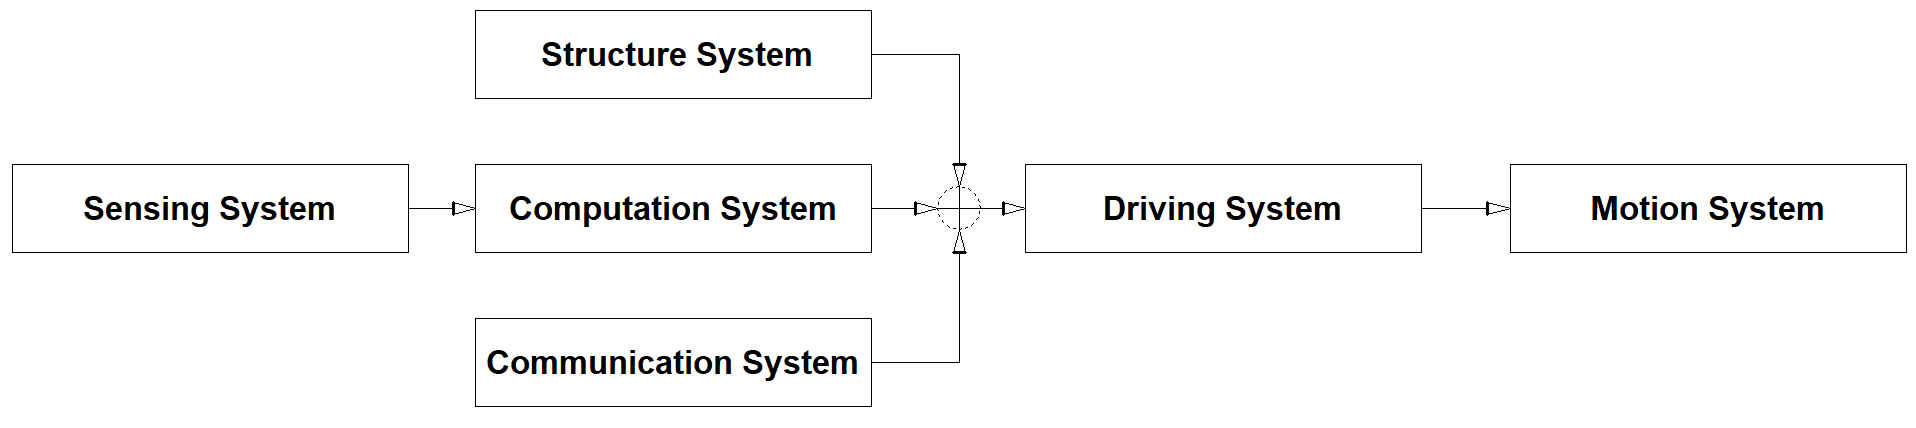
reports/conceptual_design_report/system-diagram/system-diagram.png
