temurtas/Capstone_Duayenler/reports/conceptual_presentation/differential-drive.jpg

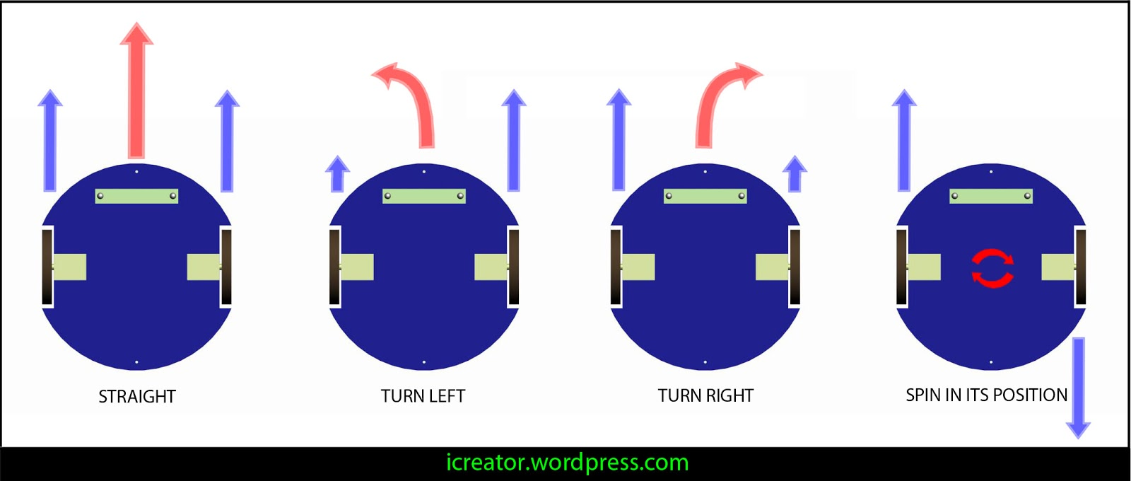
reports/conceptual_presentation/differential-drive.jpg
