temurtas/Capstone_Duayenler/reports/conceptual_presentation/gantt_miles.png

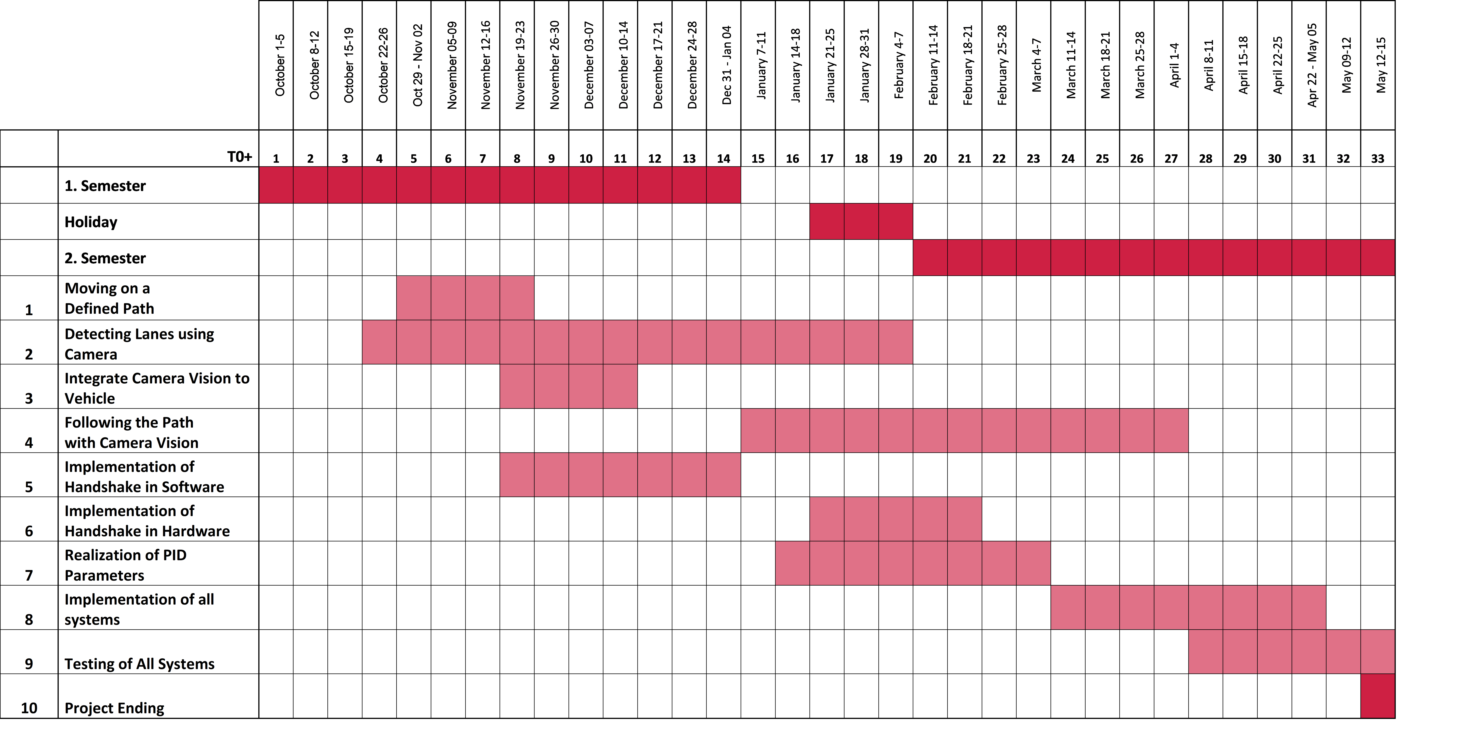
reports/conceptual_presentation/gantt_miles.png
