temurtas/Capstone_Duayenler/reports/conceptual_presentation/photo5850648702115491654.jpg

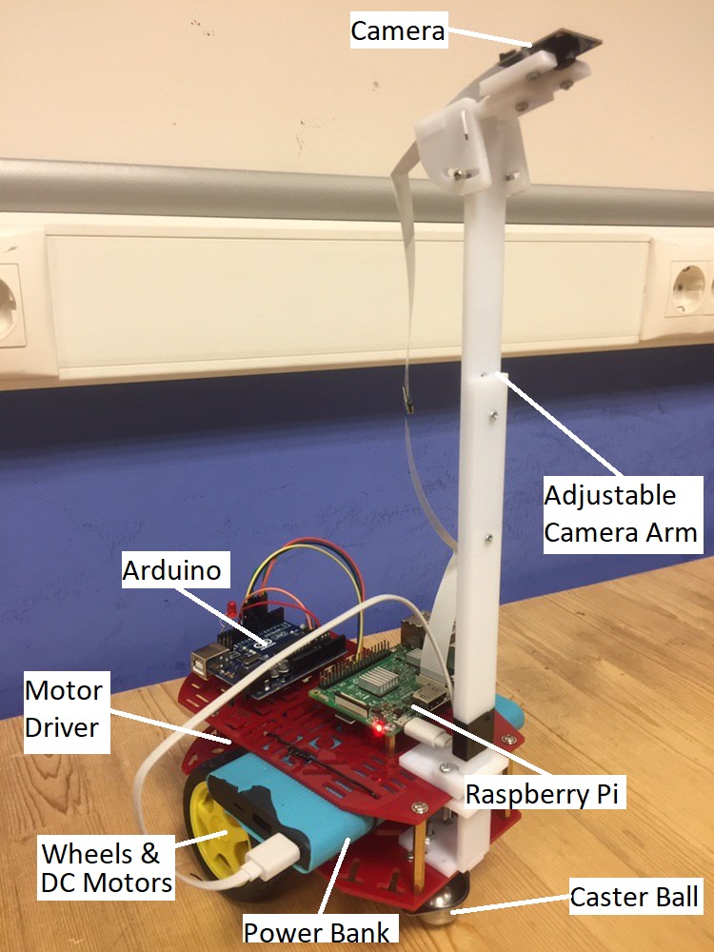
reports/conceptual_presentation/photo5850648702115491654.jpg
