temurtas/Capstone_Duayenler/reports/final_poster/latex-beamerposter-master/examples/03/img/circuit.png

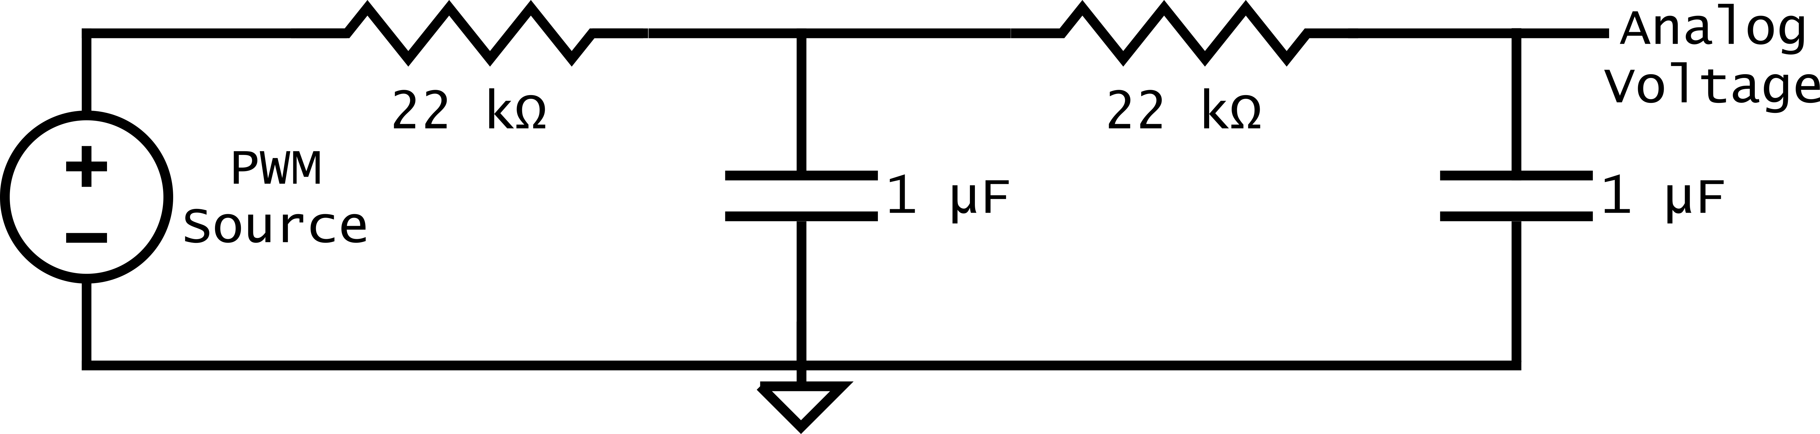
reports/final_poster/latex-beamerposter-master/examples/03/img/circuit.png
