temurtas/Capstone_Duayenler/reports/final_poster/latex-beamerposter-master/examples/03/img/controller-system.png

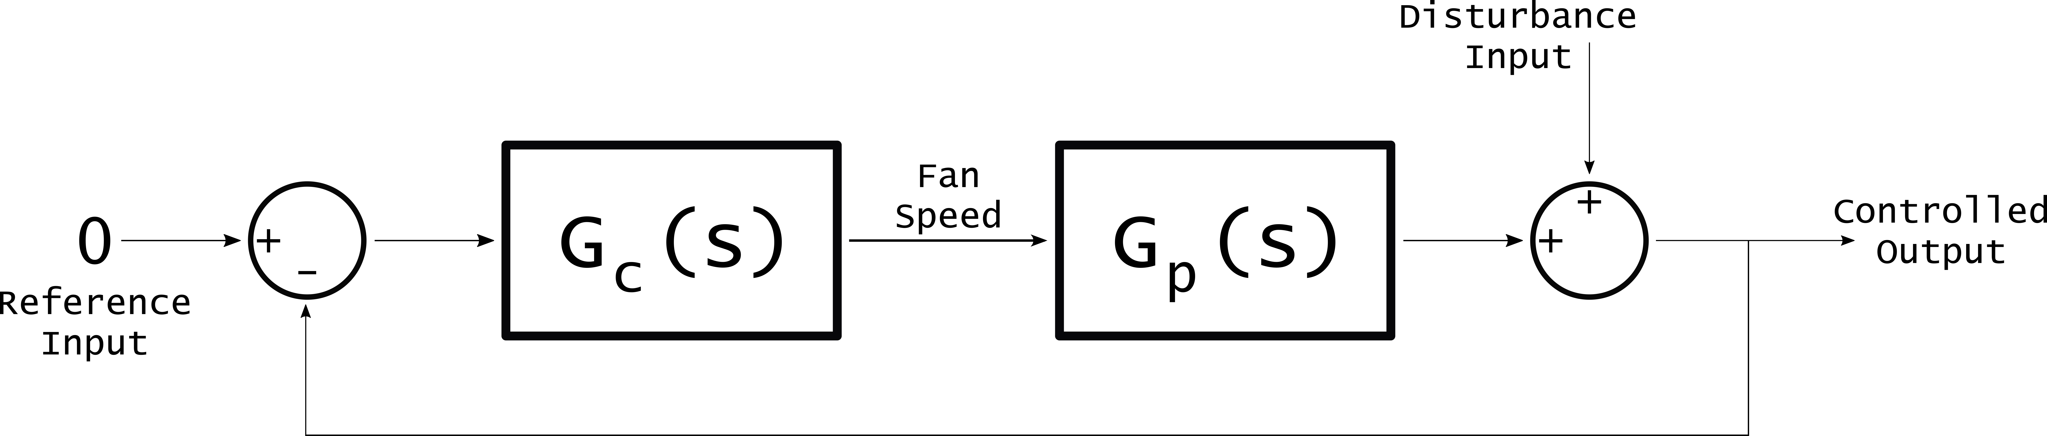
reports/final_poster/latex-beamerposter-master/examples/03/img/controller-system.png
