temurtas/Capstone_Duayenler/reports/final_poster/latex-beamerposter-master/examples/03/img/overall-system.png

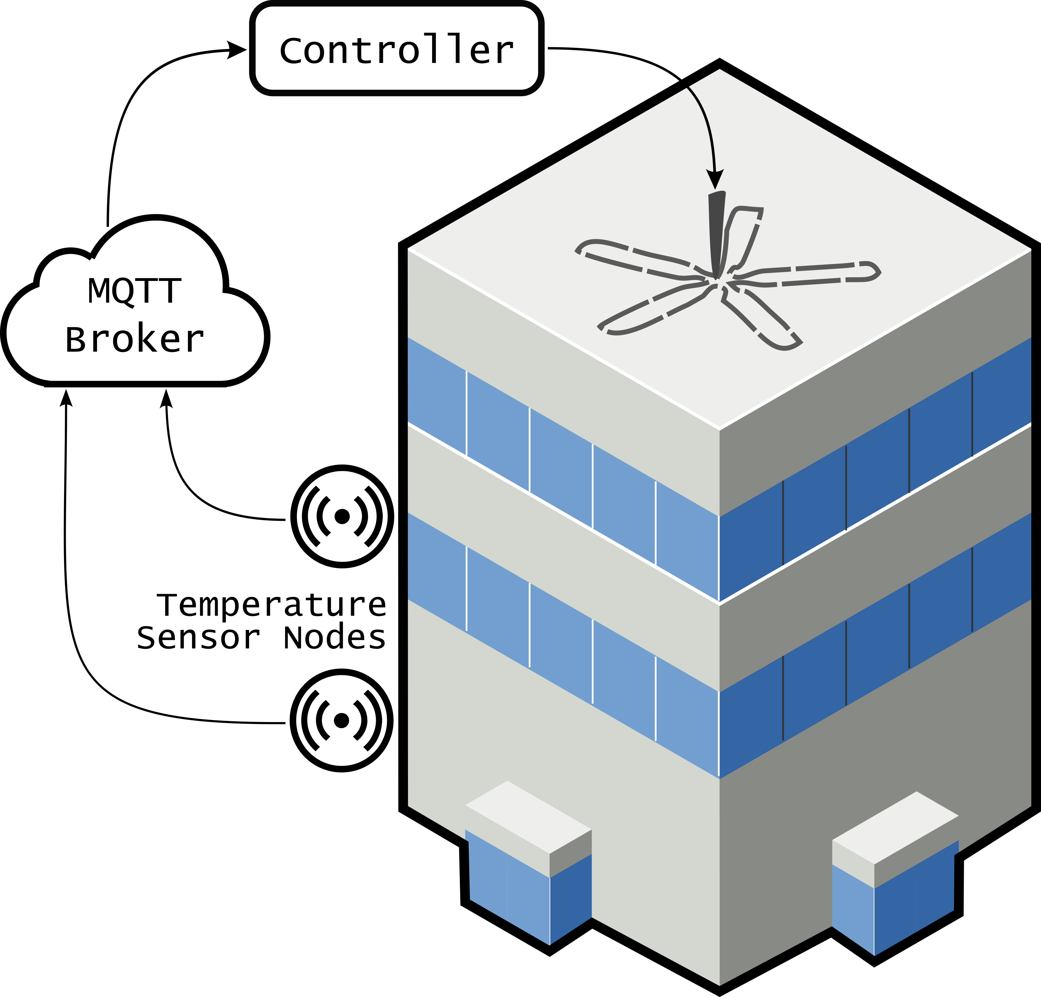
reports/final_poster/latex-beamerposter-master/examples/03/img/overall-system.png
