temurtas/Capstone_Duayenler/reports/final_poster/latex-beamerposter-master/examples/03/img/path_images/2019-02-15-194743_1280x1024_scrot.png

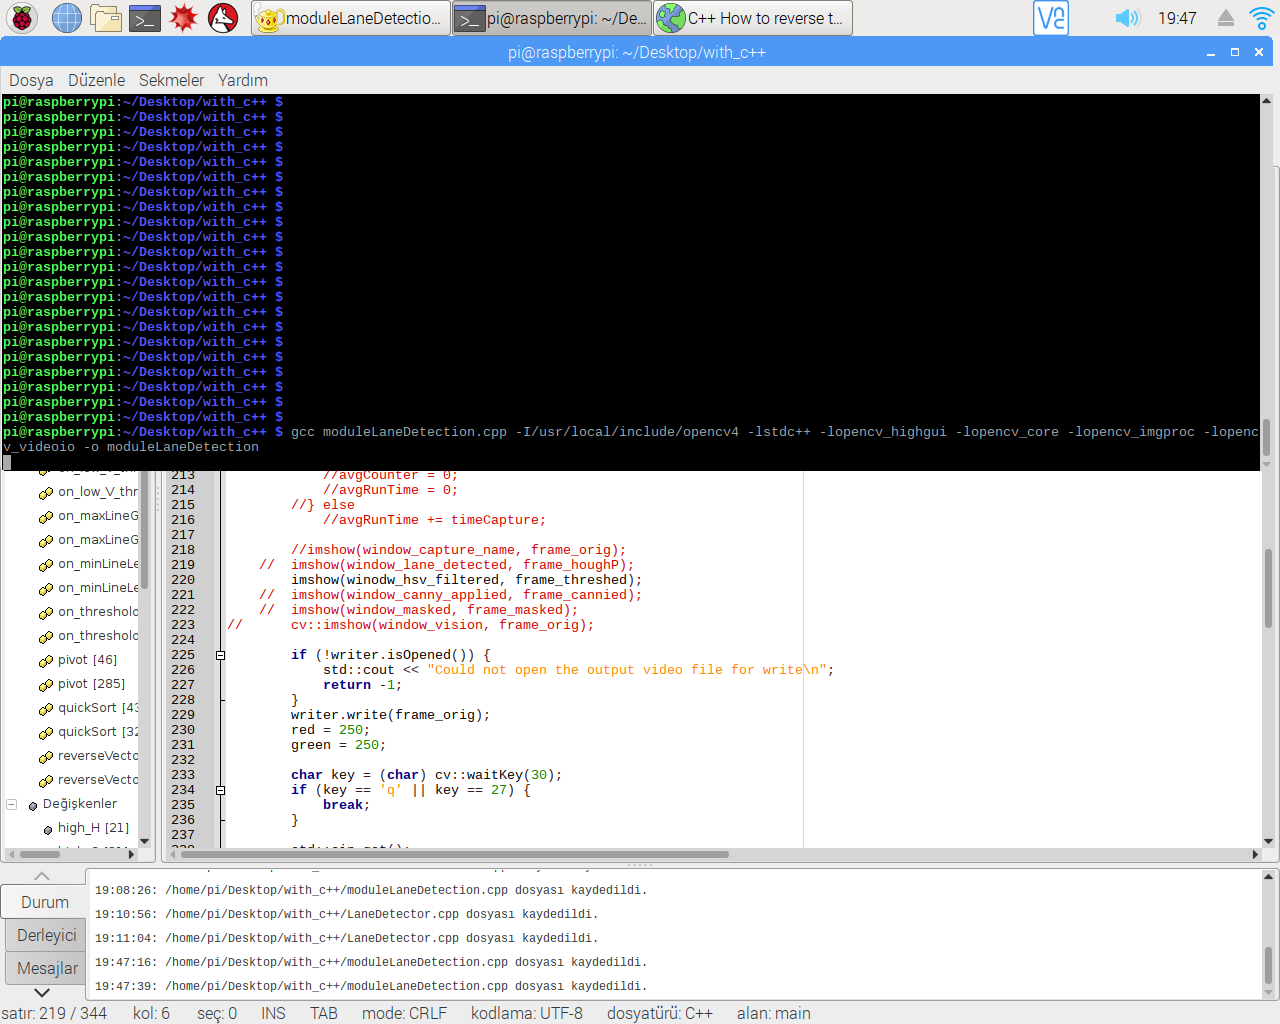
reports/final_poster/latex-beamerposter-master/examples/03/img/path_images/2019-02-15-194743_1280x1024_scrot.png
