temurtas/Capstone_Duayenler/reports/final_poster/latex-beamerposter-master/examples/03/img/path_images/2019-03-03-195228_1024x768_scrot.png

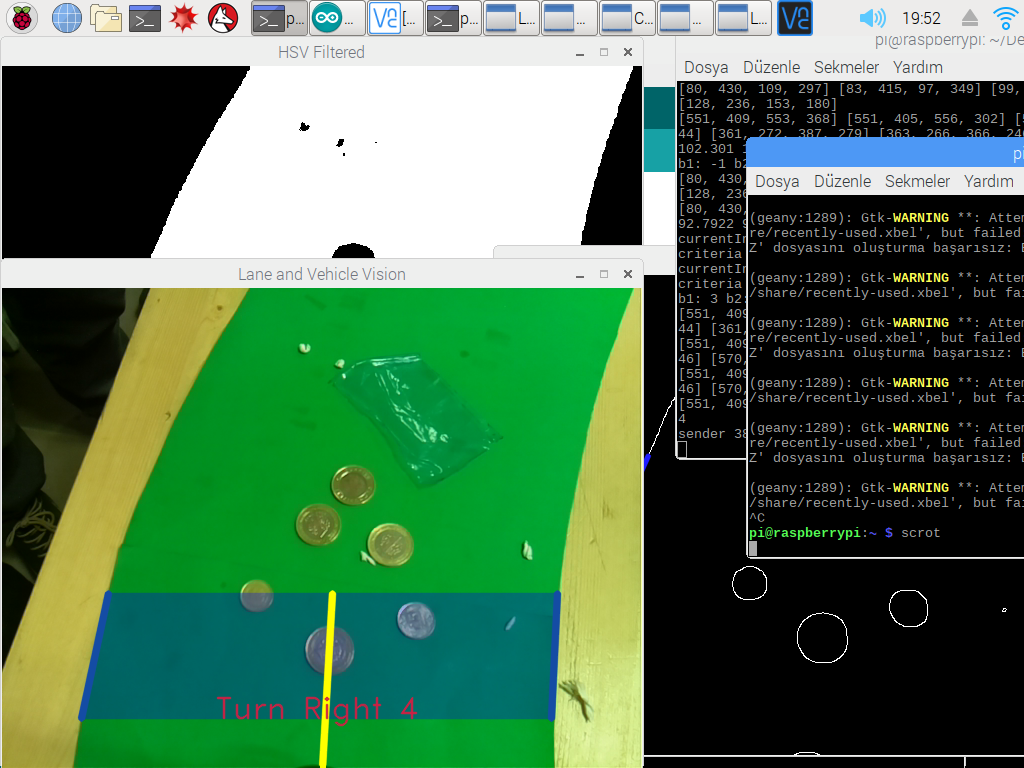
reports/final_poster/latex-beamerposter-master/examples/03/img/path_images/2019-03-03-195228_1024x768_scrot.png
