temurtas/Capstone_Duayenler/reports/final_poster/latex-beamerposter-master/examples/03/img/path_images/insideSun.png

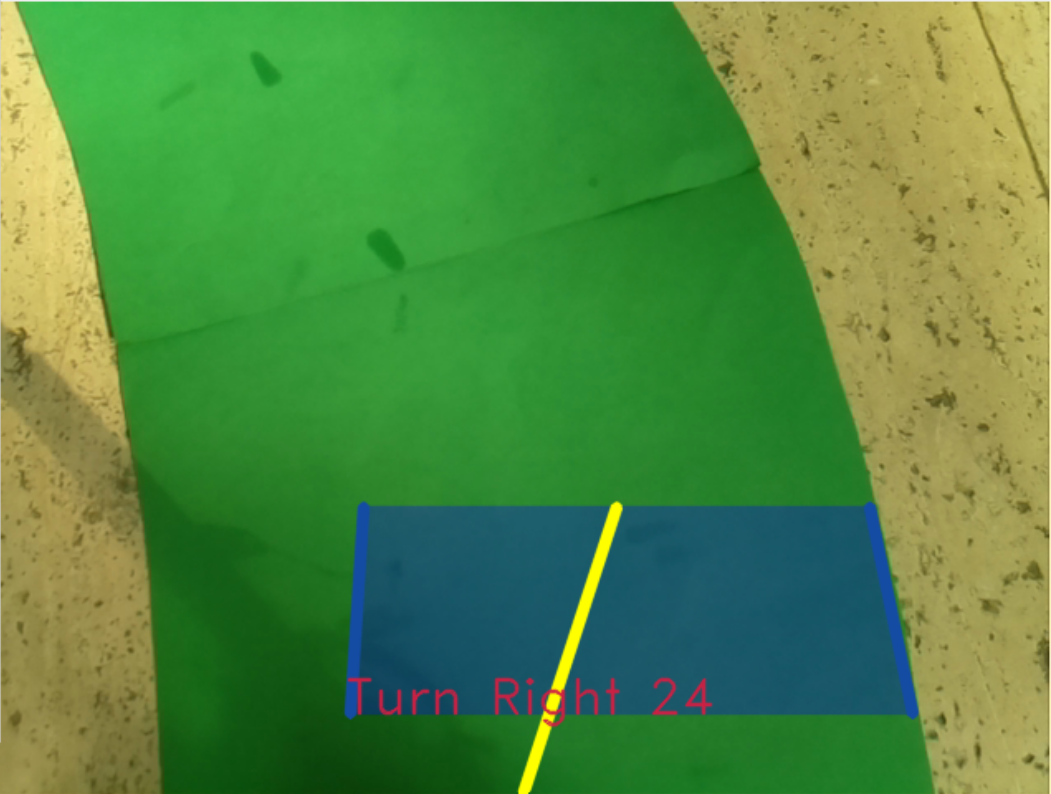
reports/final_poster/latex-beamerposter-master/examples/03/img/path_images/insideSun.png
