temurtas/Capstone_Duayenler/reports/final_poster/latex-beamerposter-master/examples/03/img/path_images/micir.png

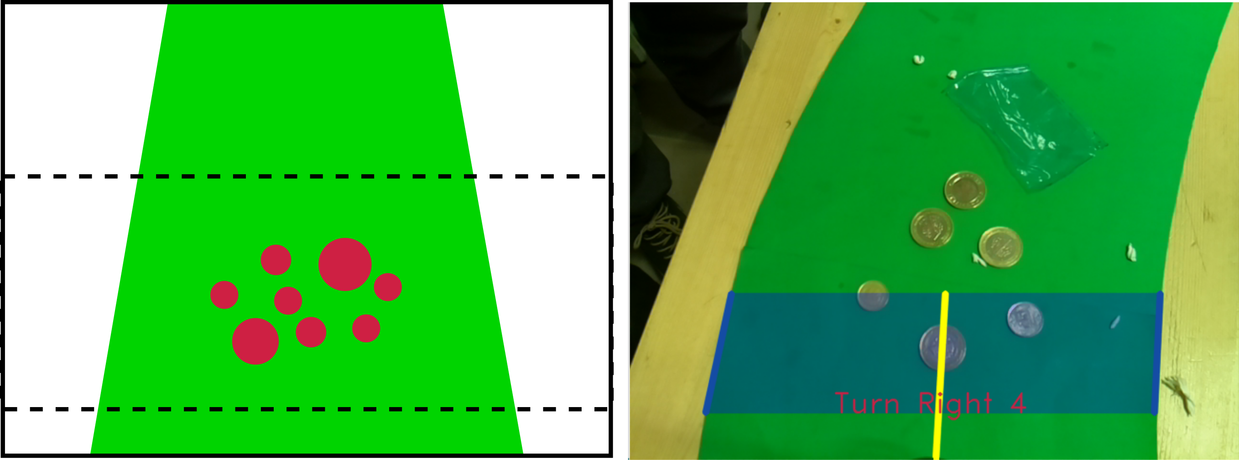
reports/final_poster/latex-beamerposter-master/examples/03/img/path_images/micir.png
