temurtas/Capstone_Duayenler/reports/final_poster/latex-beamerposter-master/examples/03/img/sensor-data2.png

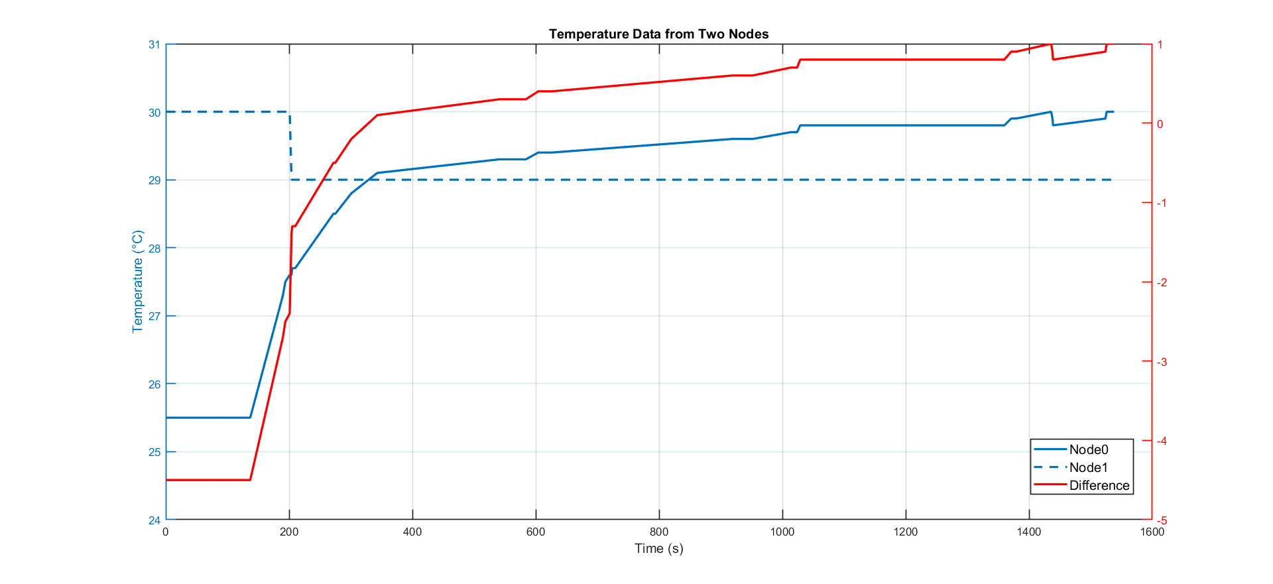
reports/final_poster/latex-beamerposter-master/examples/03/img/sensor-data2.png
