temurtas/Capstone_Duayenler/reports/final_report/images/2019-03-07-203916_1280x1024_scrot.png

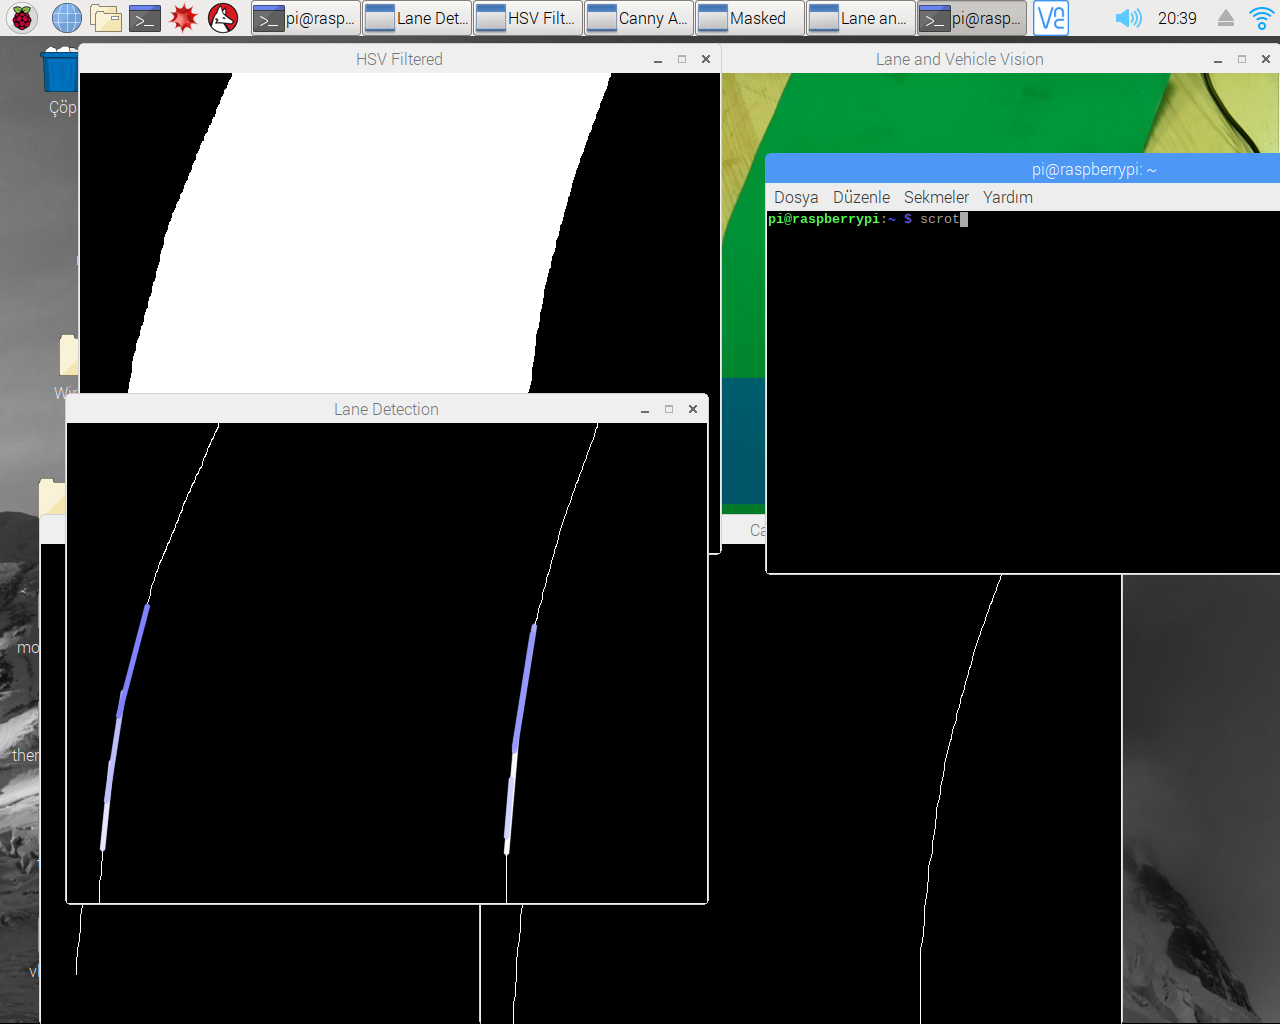
reports/final_report/images/2019-03-07-203916_1280x1024_scrot.png
