temurtas/Capstone_Duayenler/reports/final_report/images/gantt/gantt1.png

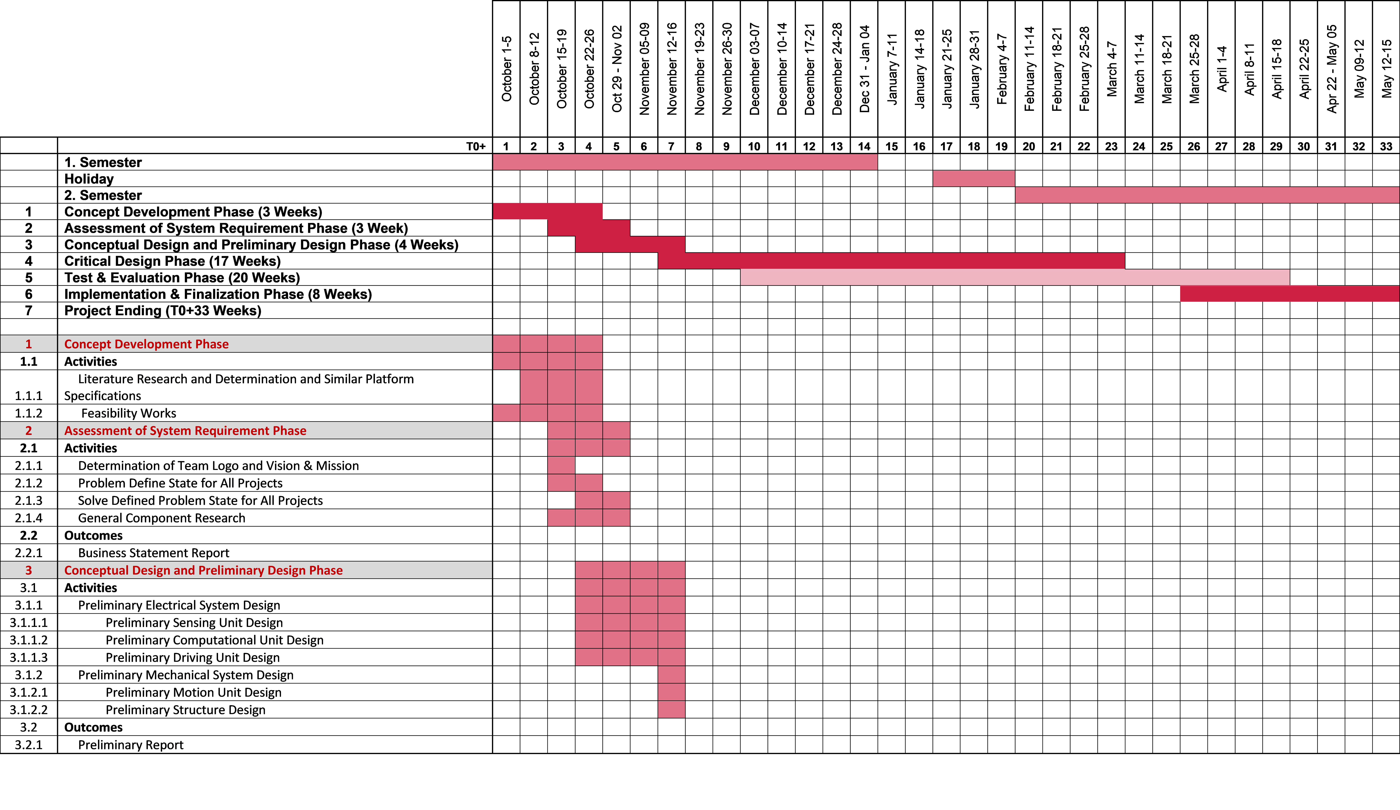
reports/final_report/images/gantt/gantt1.png
