temurtas/Capstone_Duayenler/reports/final_report/images/gantt/gantt3.png

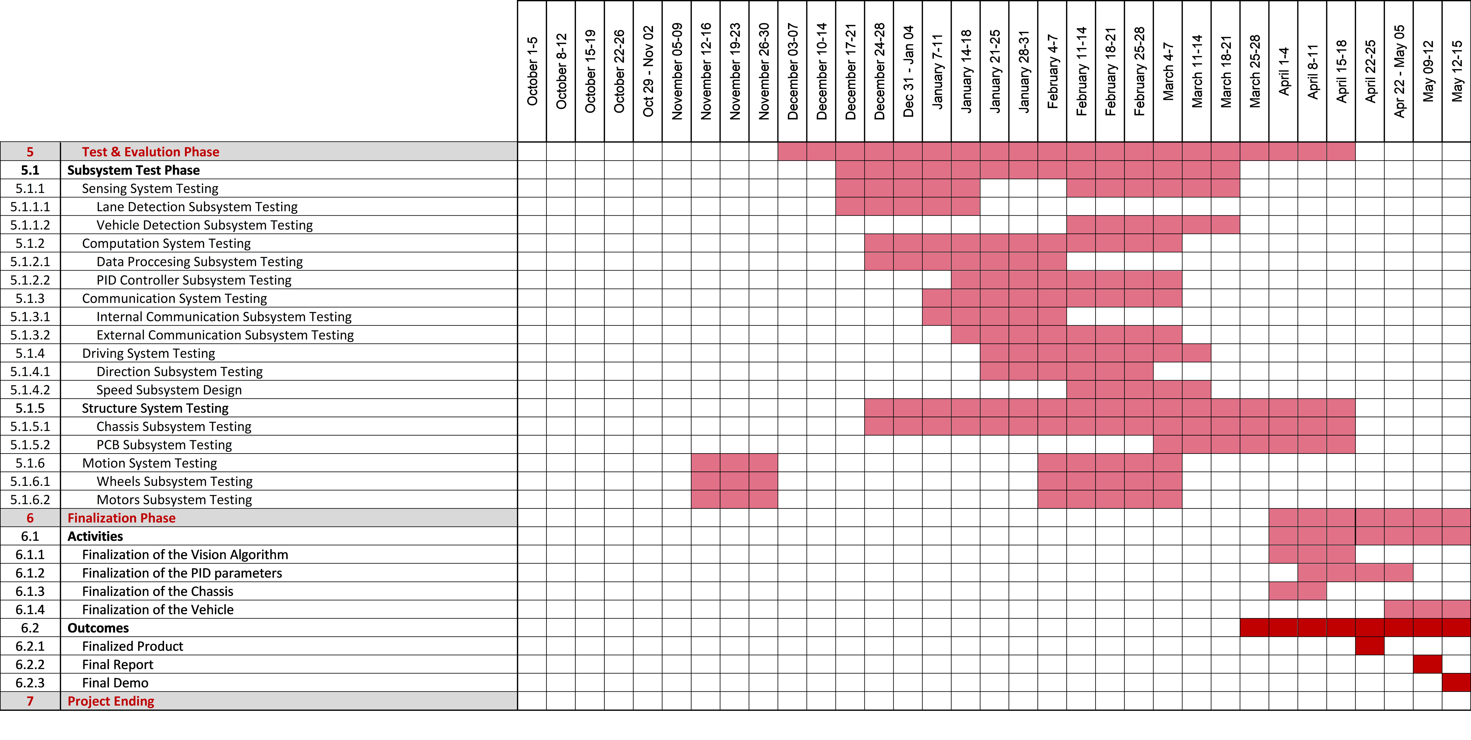
reports/final_report/images/gantt/gantt3.png
