temurtas/Capstone_Duayenler/reports/final_report/images/ROT_ROI/baseSpeed.png

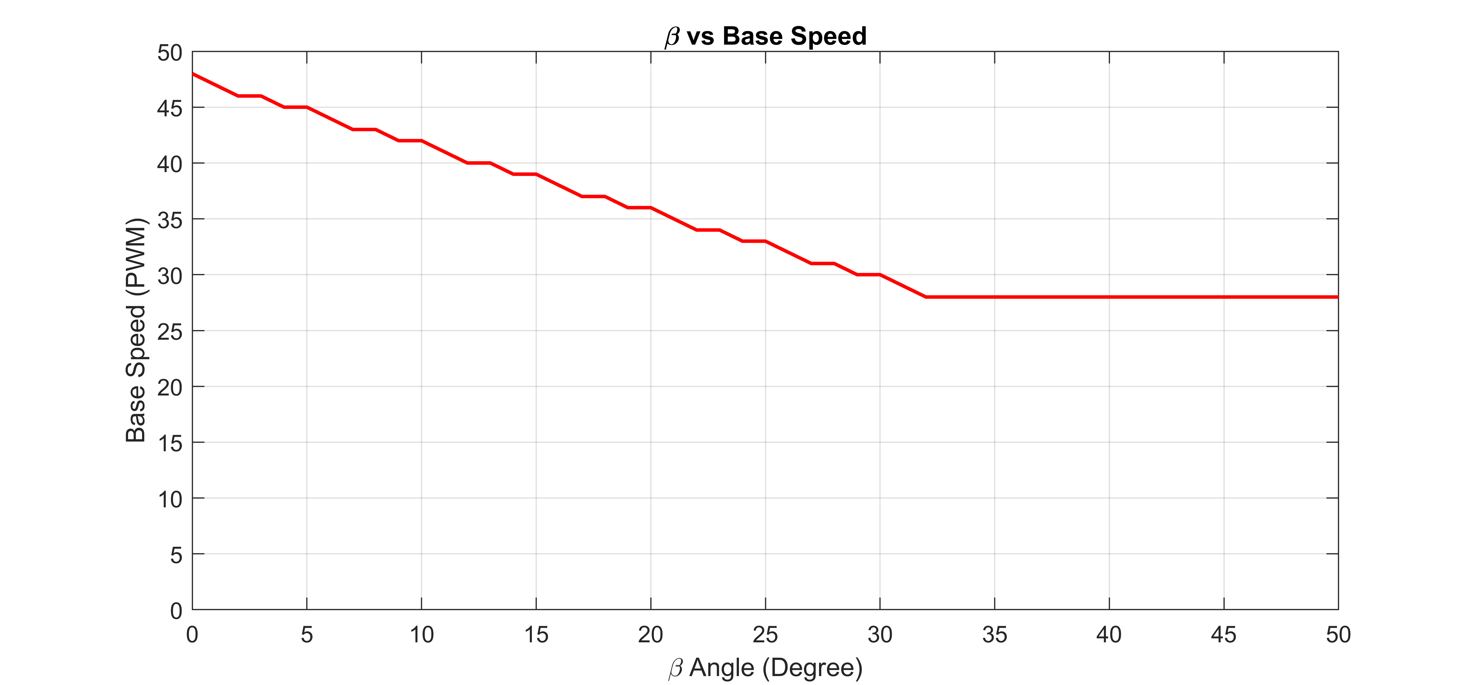
reports/final_report/images/ROT_ROI/baseSpeed.png
