temurtas/Capstone_Duayenler/reports/final_report/images/ROT_ROI/baseSpeedExp.png

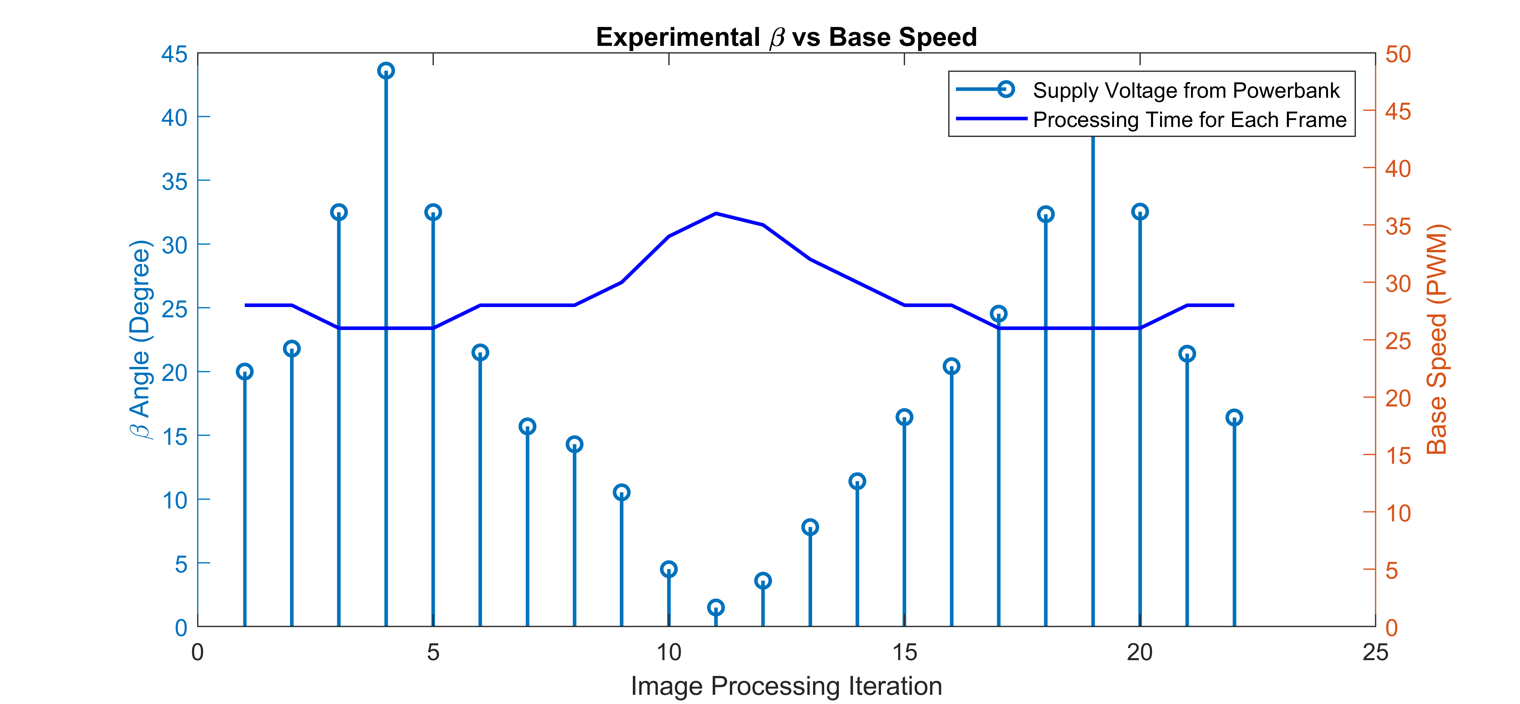
reports/final_report/images/ROT_ROI/baseSpeedExp.png
