temurtas/Capstone_Duayenler/reports/final_report/images/ROT_ROI/cwLapTime_crop.png

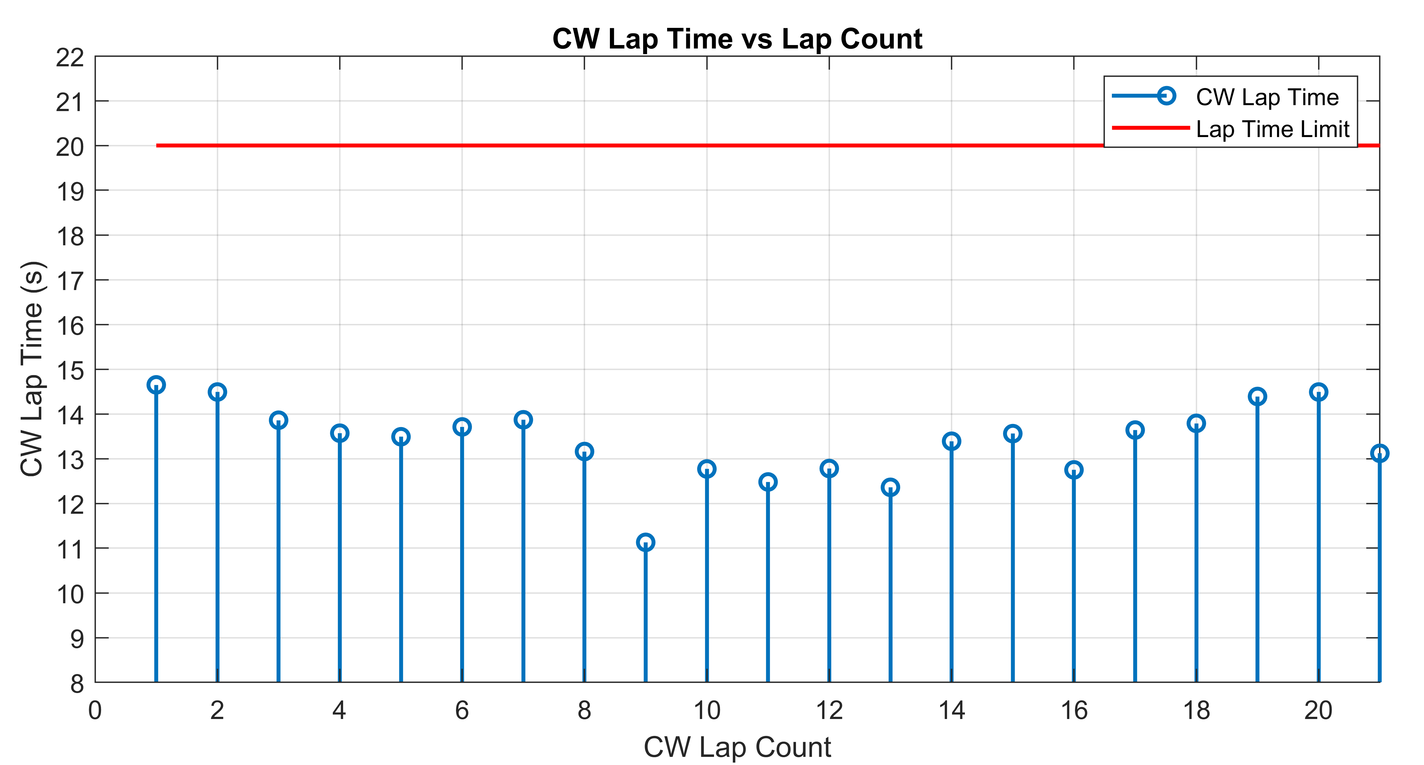
reports/final_report/images/ROT_ROI/cwLapTime_crop.png
