temurtas/Capstone_Duayenler/reports/final_report/images/ROT_ROI/ProcessTime.png

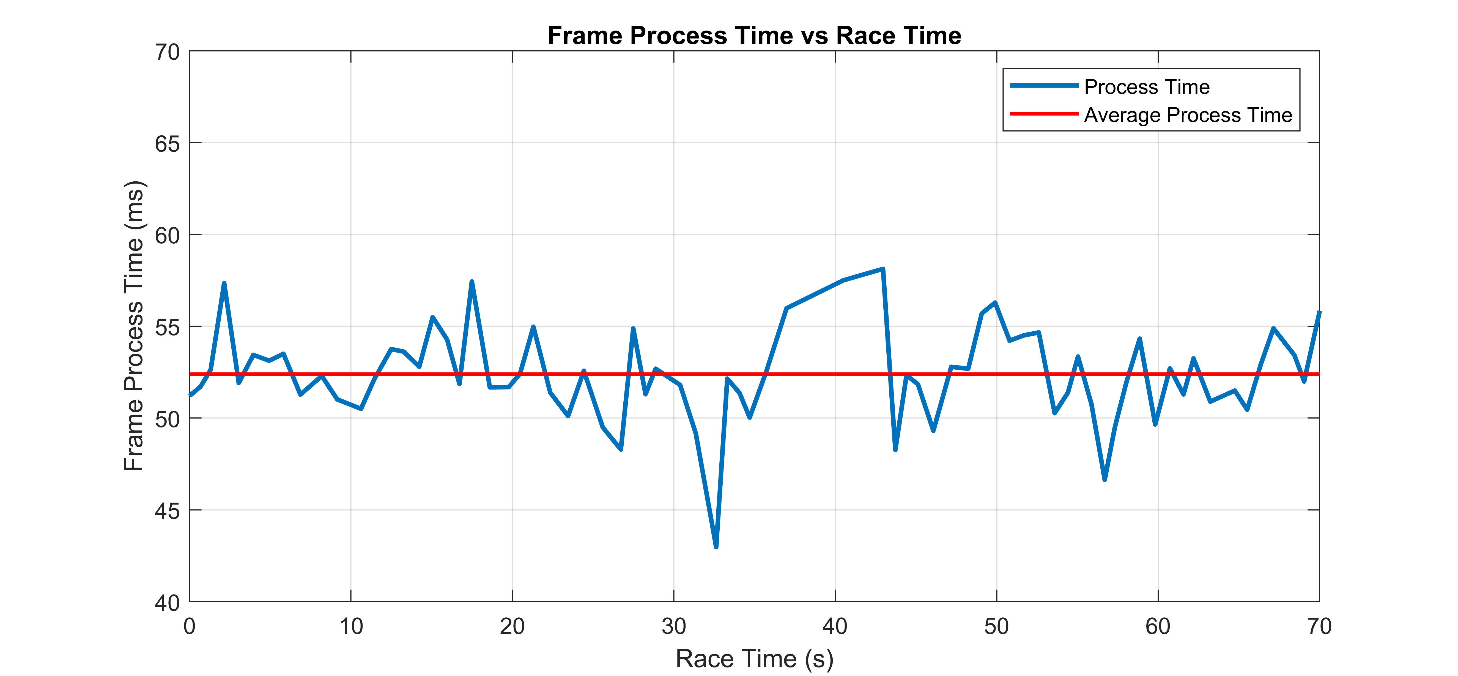
reports/final_report/images/ROT_ROI/ProcessTime.png
