temurtas/Capstone_Duayenler/reports/final_report/images/ROT_ROI/ROI_ROT.png

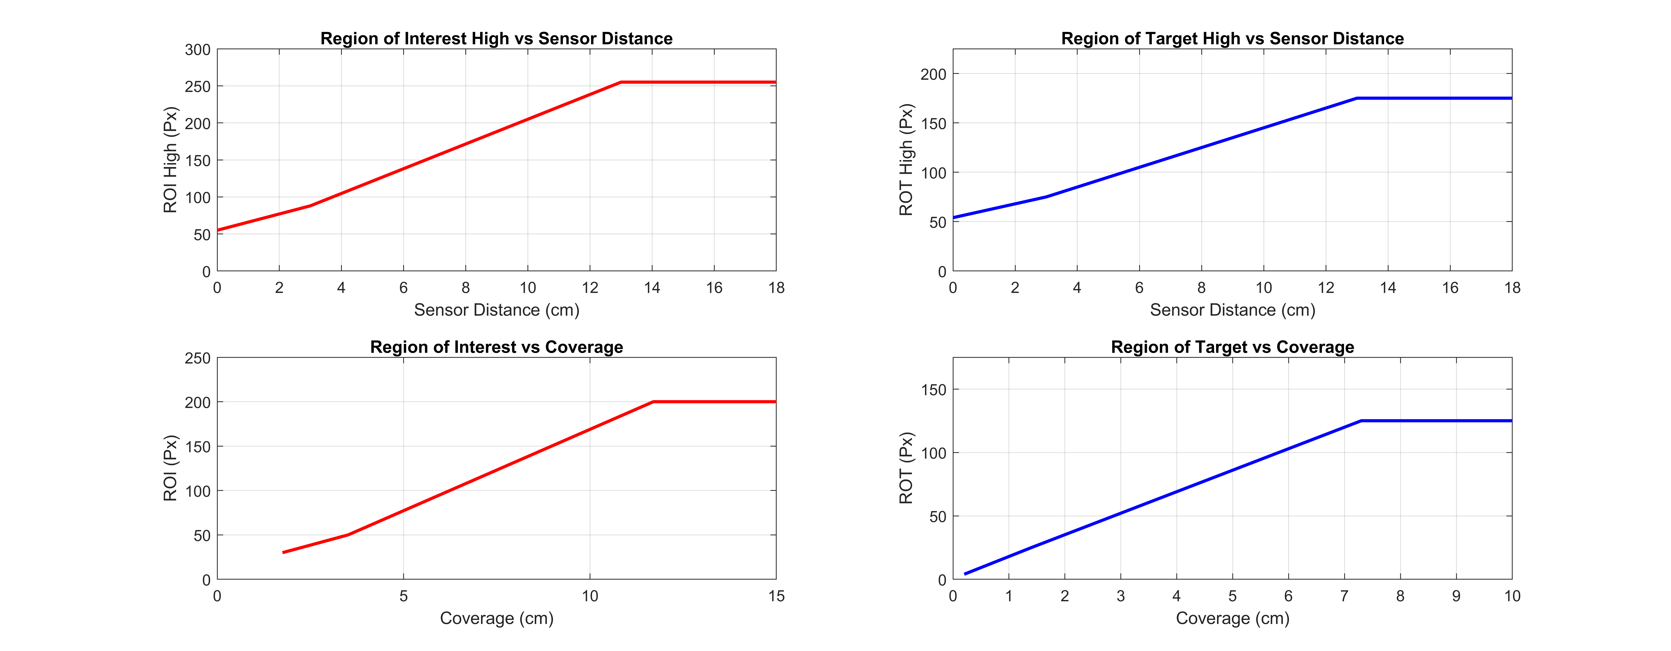
reports/final_report/images/ROT_ROI/ROI_ROT.png
