temurtas/Capstone_Duayenler/reports/final_report/images/ROT_ROI/stabilityI.png

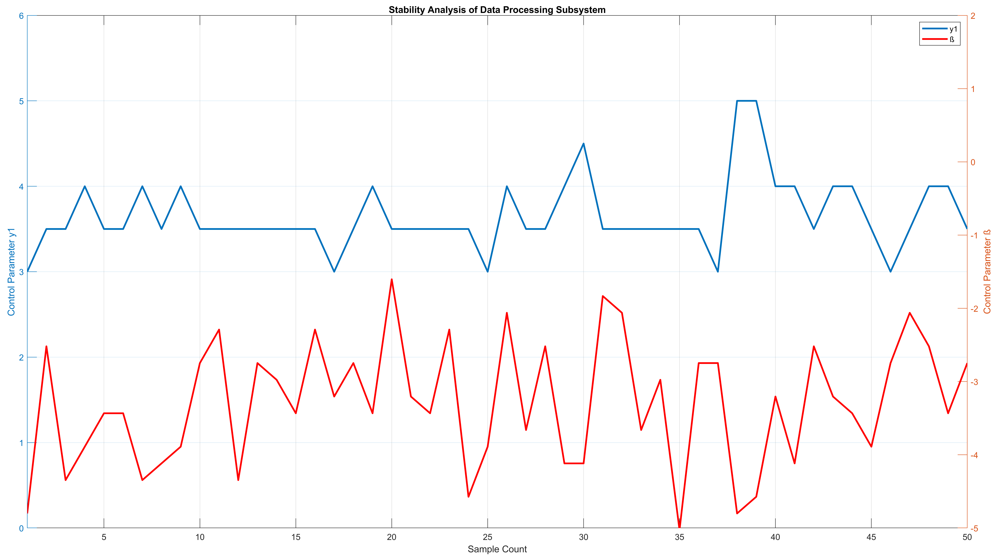
reports/final_report/images/ROT_ROI/stabilityI.png
