temurtas/Capstone_Duayenler/reports/final_report/images/ROT_ROI/stabilityS.png

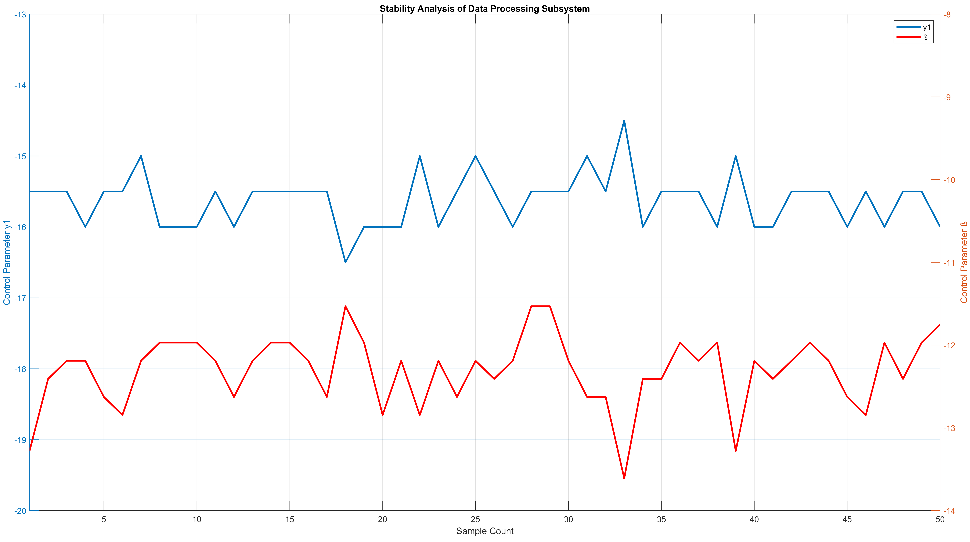
reports/final_report/images/ROT_ROI/stabilityS.png
