temurtas/Capstone_Duayenler/reports/final_report/images/ROT_ROI/stabilityU.png

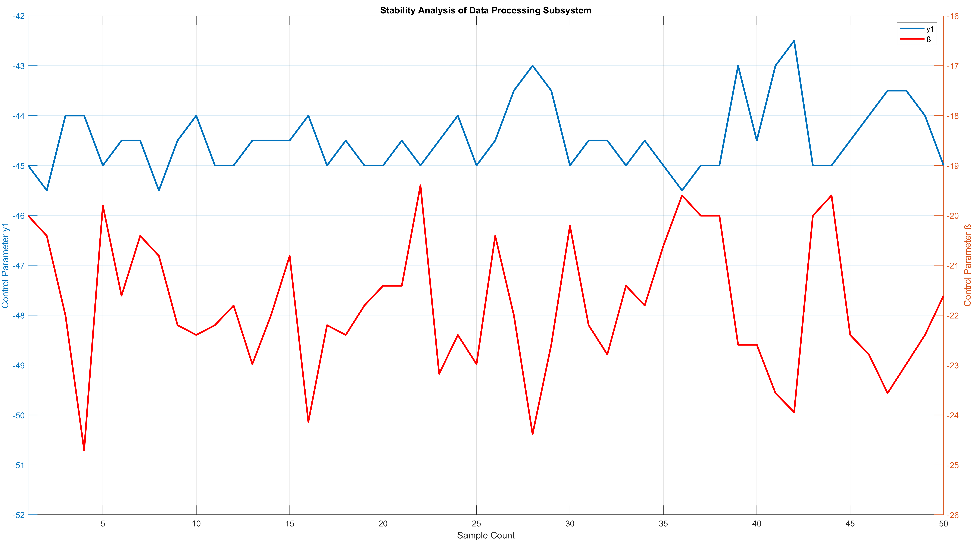
reports/final_report/images/ROT_ROI/stabilityU.png
