temurtas/Capstone_Duayenler/reports/final_report/images/ROT_ROI/voltageSupply.png

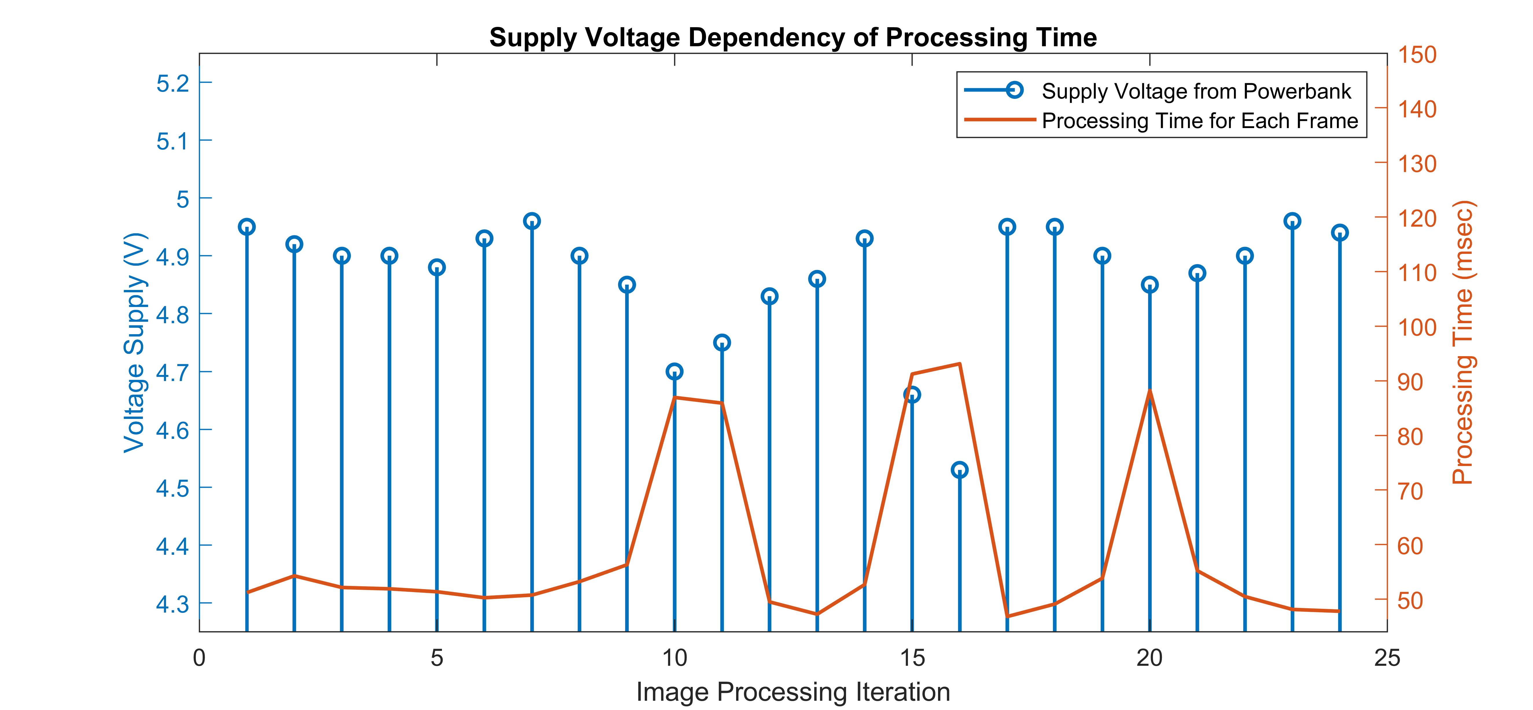
reports/final_report/images/ROT_ROI/voltageSupply.png
