temurtas/Capstone_Duayenler/reports/final_report/images/side-view.png

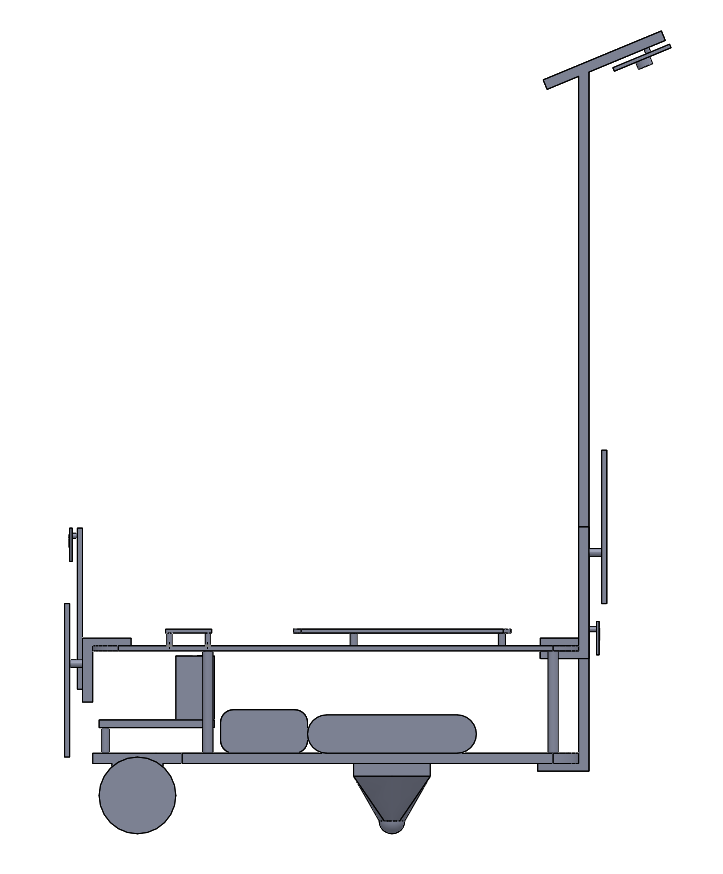
reports/final_report/images/side-view.png
