temurtas/Capstone_Duayenler/reports/final_report/images/top-view.png

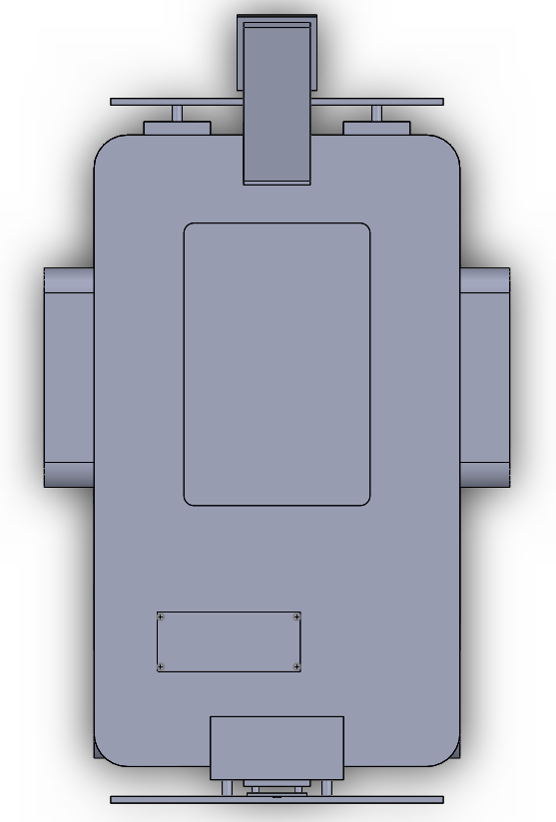
reports/final_report/images/top-view.png
