temurtas/Capstone_Duayenler/reports/proposal_report/images/objective_tree2.png

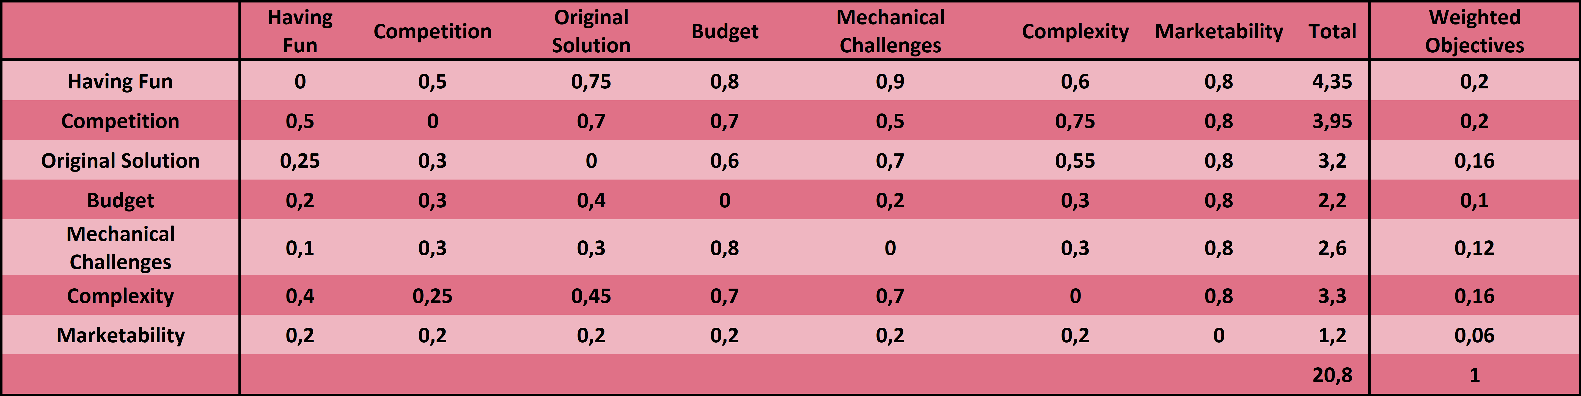
reports/proposal_report/images/objective_tree2.png
