temurtas/Capstone_Duayenler/reports/proposal_report/images/objective_tree.png

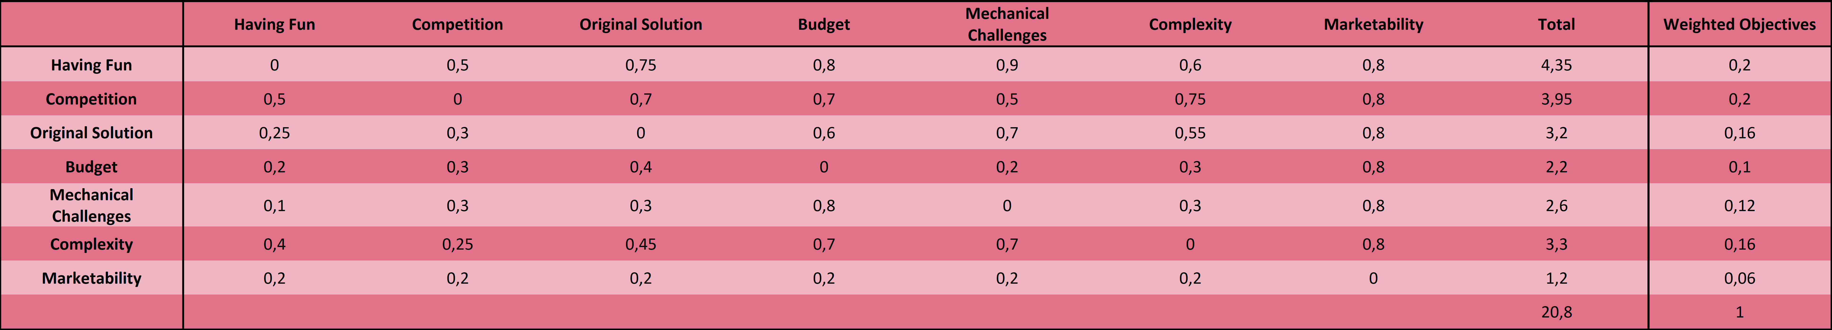
reports/proposal_report/images/objective_tree.png
