temurtas/Capstone_Duayenler/reports/proposal_report/images/proje_objective_tree.png

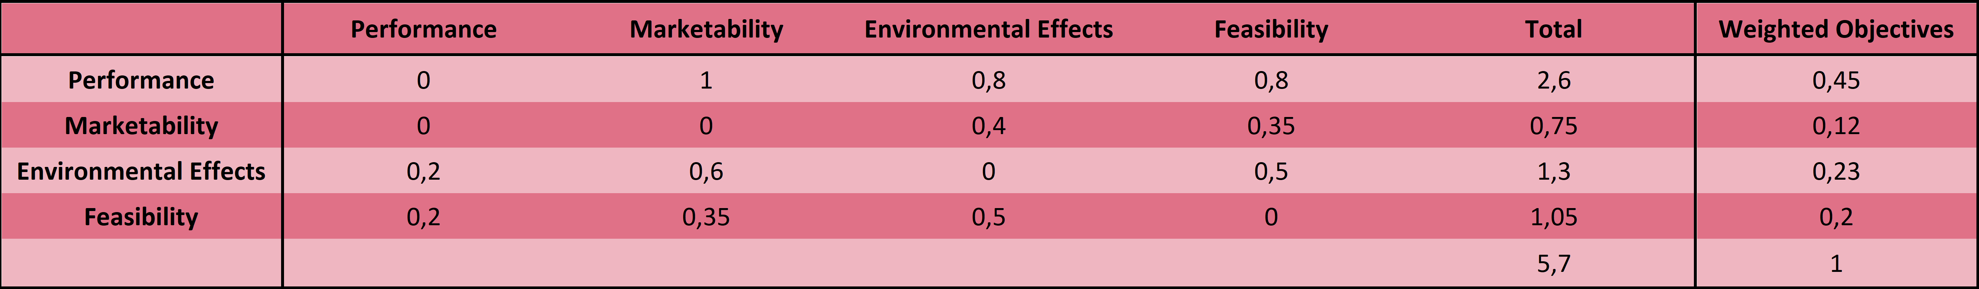
reports/proposal_report/images/proje_objective_tree.png
