temurtas/Capstone_Duayenler/reports/proposal_report/images/proje_objective_tree_2.png

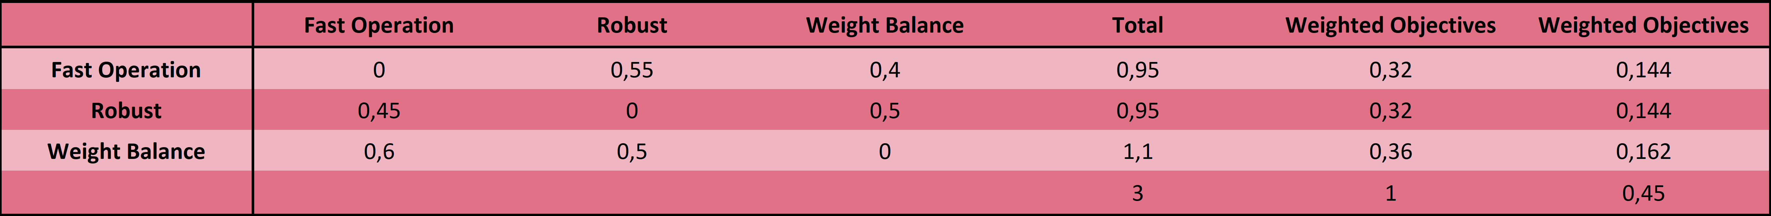
reports/proposal_report/images/proje_objective_tree_2.png
