temurtas/Capstone_Duayenler/reports/proposal_report/images/proje_objective_tree_3a.png

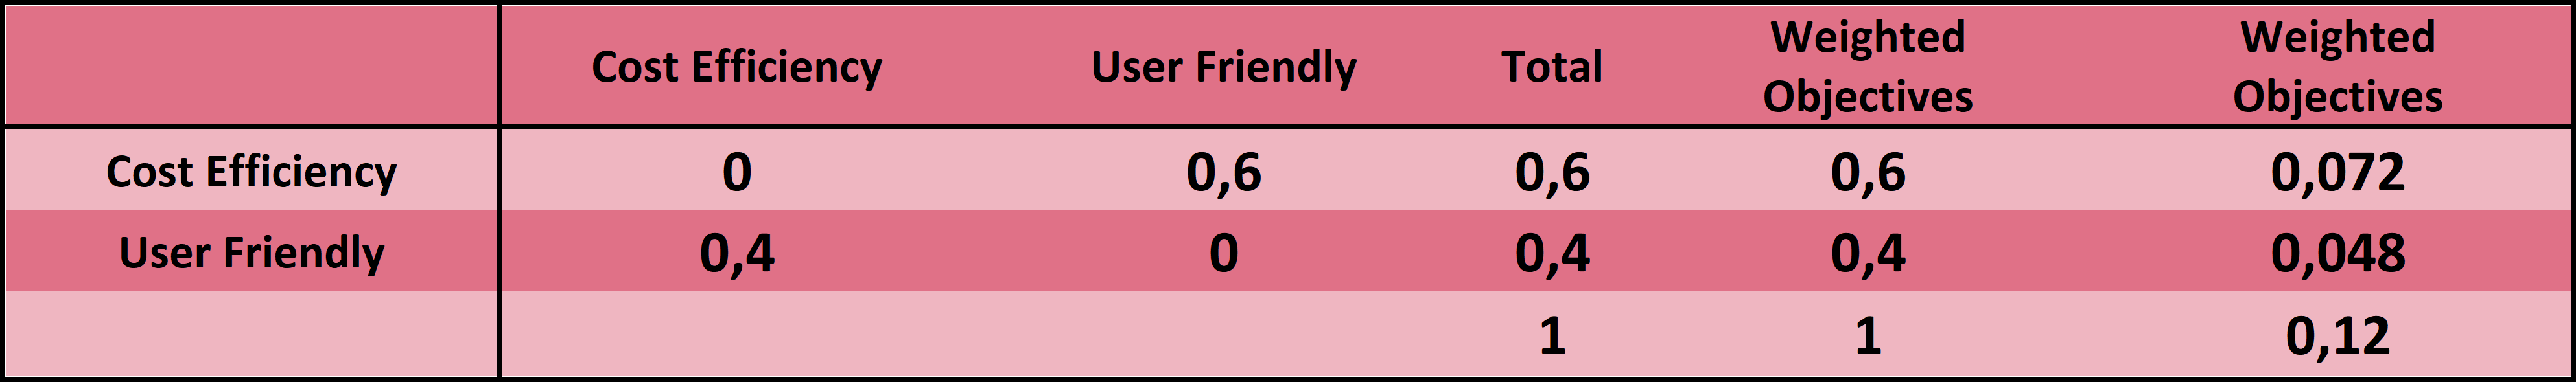
reports/proposal_report/images/proje_objective_tree_3a.png
