temurtas/Capstone_Duayenler/reports/proposal_report/images/proje_objective_tree_4a.png

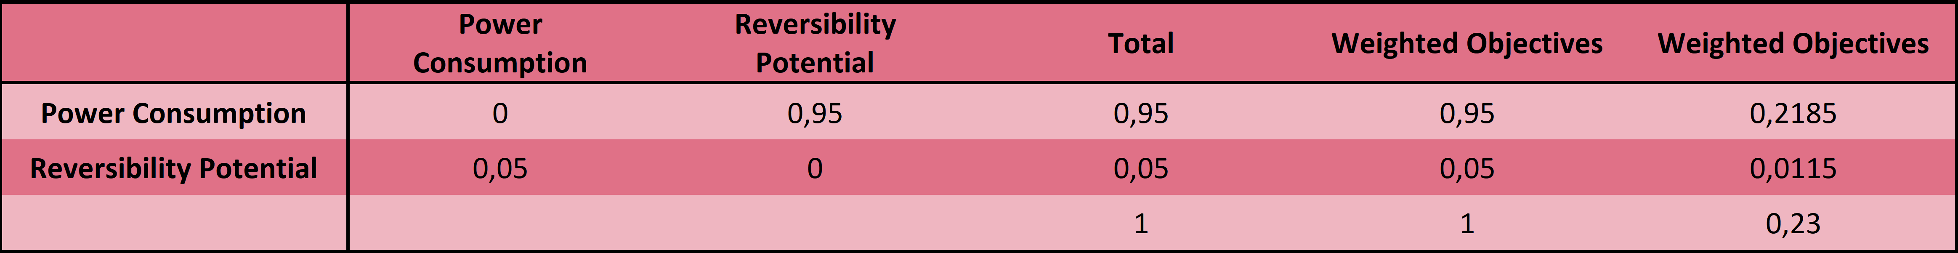
reports/proposal_report/images/proje_objective_tree_4a.png
