temurtas/Capstone_Duayenler/reports/proposal_report/images/soln_selection2.png

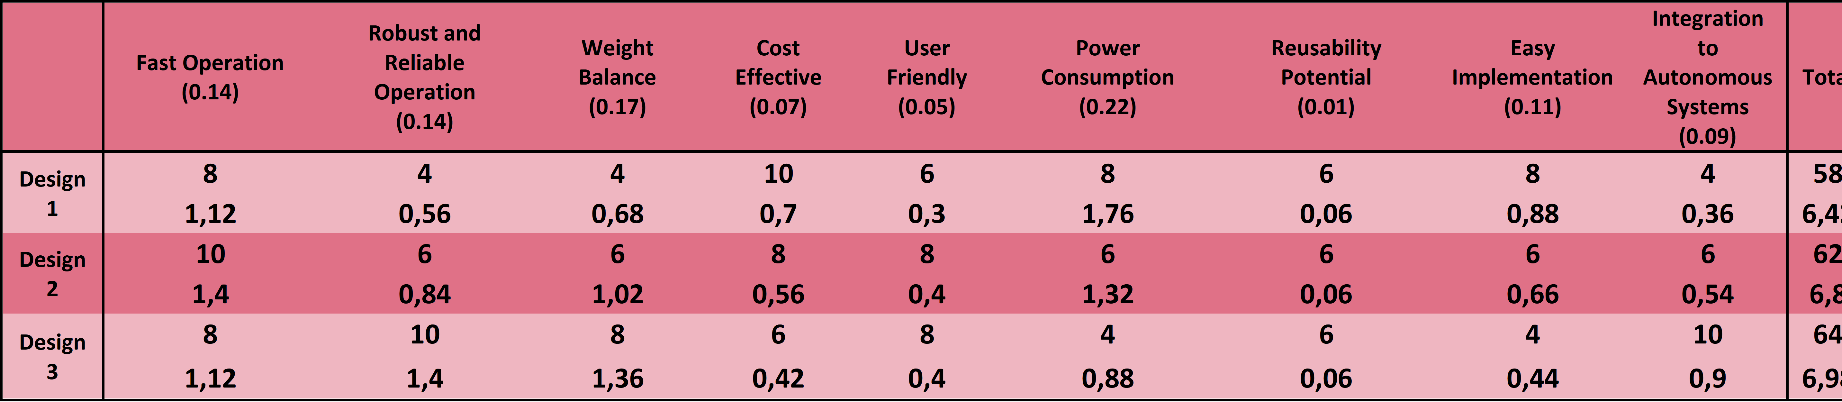
reports/proposal_report/images/soln_selection2.png
