temurtas/Capstone_Duayenler/reports/proposal_report/images/soln_selection.png

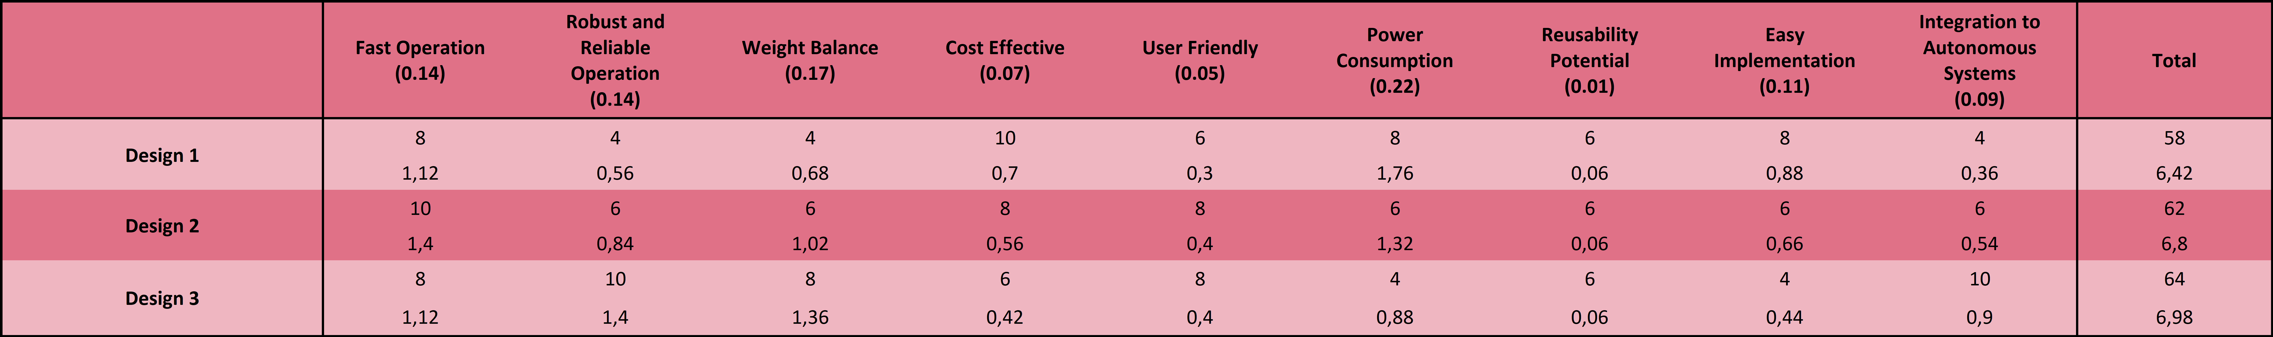
reports/proposal_report/images/soln_selection.png
