temurtas/Capstone_Duayenler/reports/weekly_reports/2018_11_19_Weekly_Report/handshake-protocol.png

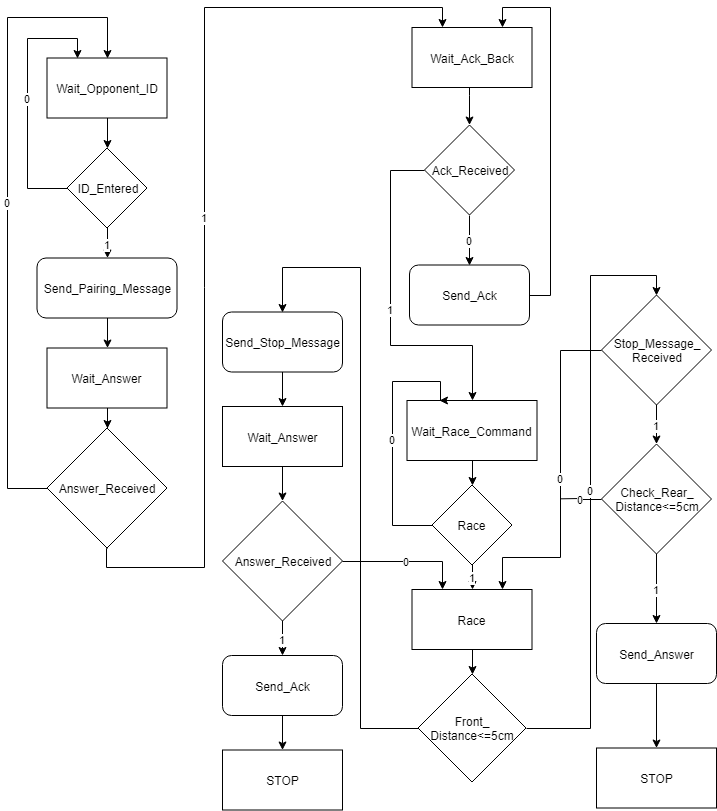
reports/weekly_reports/2018_11_19_Weekly_Report/handshake-protocol.png
