temurtas/Capstone_Duayenler/reports/weekly_reports/2018_12_03_Weekly_Report/9.png

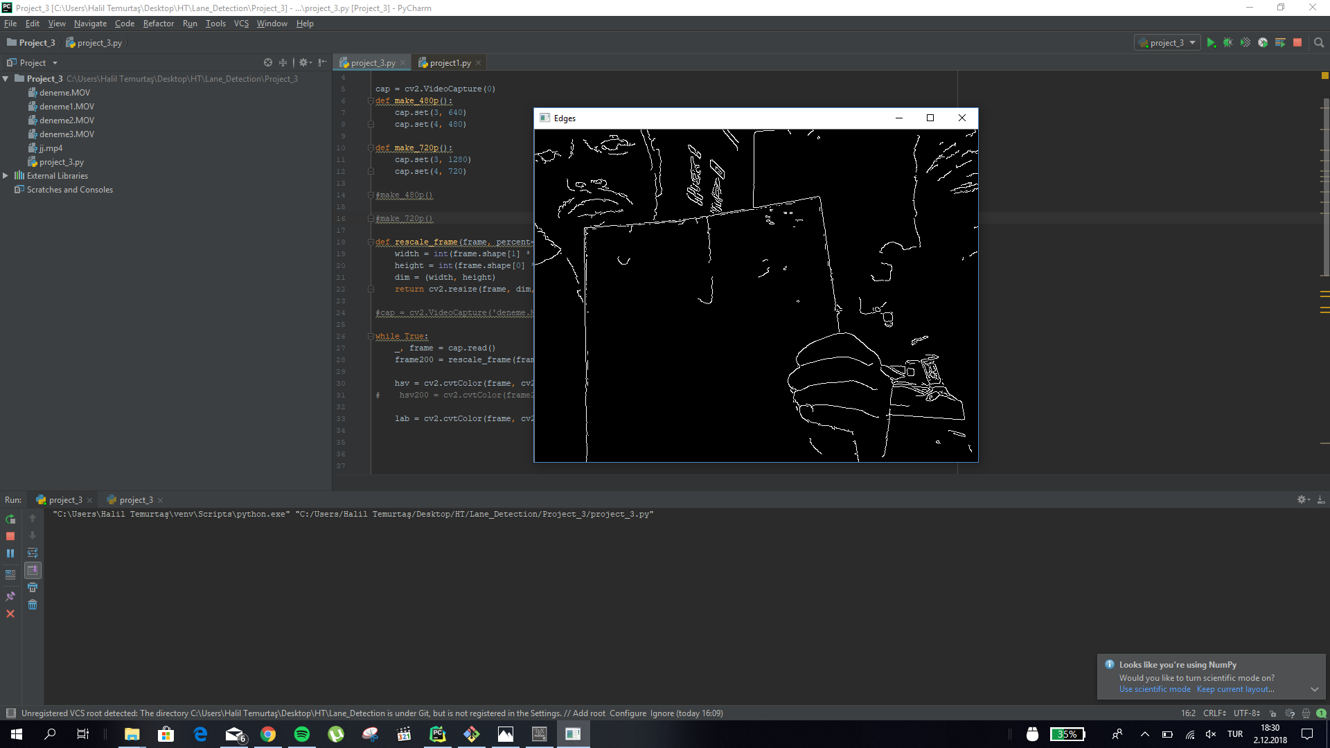
reports/weekly_reports/2018_12_03_Weekly_Report/9.png
