temurtas/Capstone_Duayenler/reports/weekly_reports/2019_02_18_Weekly_Report/0.jpg

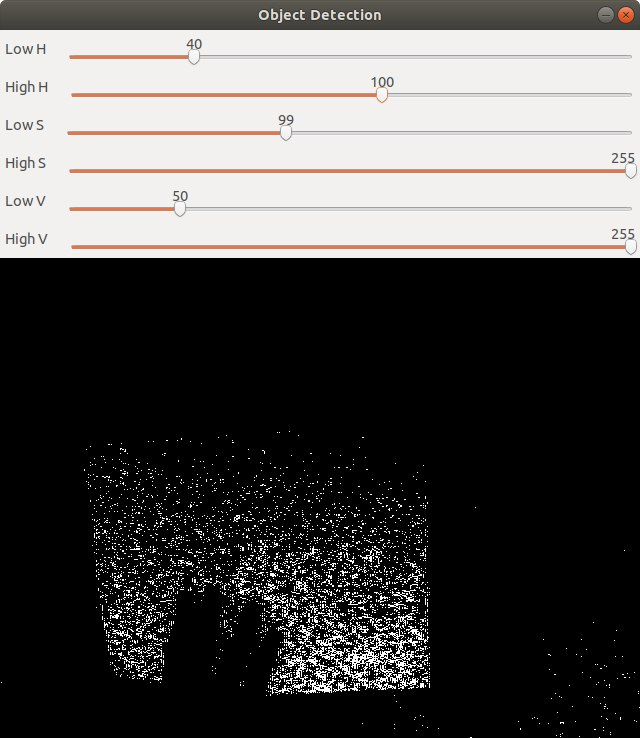
reports/weekly_reports/2019_02_18_Weekly_Report/0.jpg
