temurtas/Capstone_Duayenler/reports/weekly_reports/2019_02_18_Weekly_Report/efso.jpg

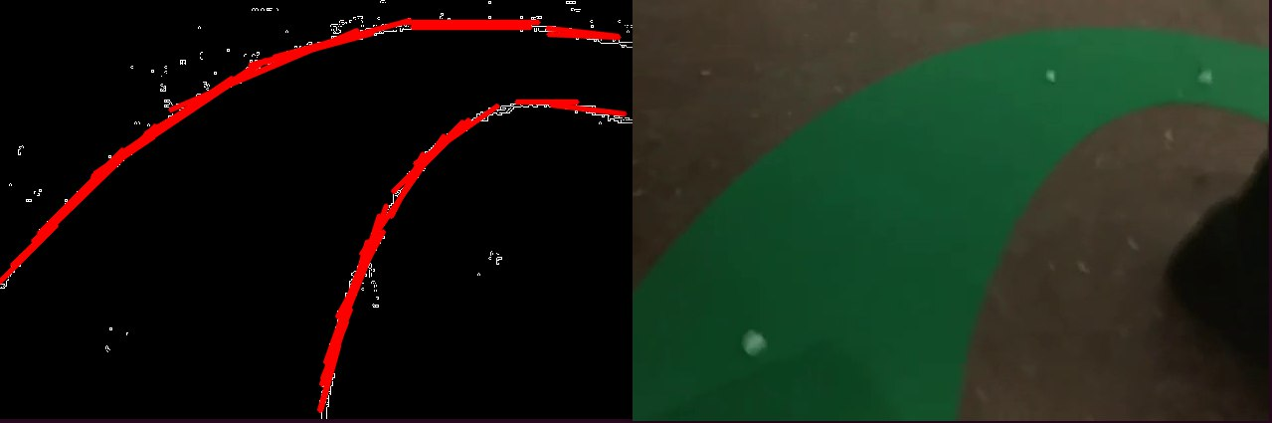
reports/weekly_reports/2019_02_18_Weekly_Report/efso.jpg
