temurtas/Capstone_Duayenler/reports/weekly_reports/2019_03_19_Weekly_Report/3D-isometric-2.png

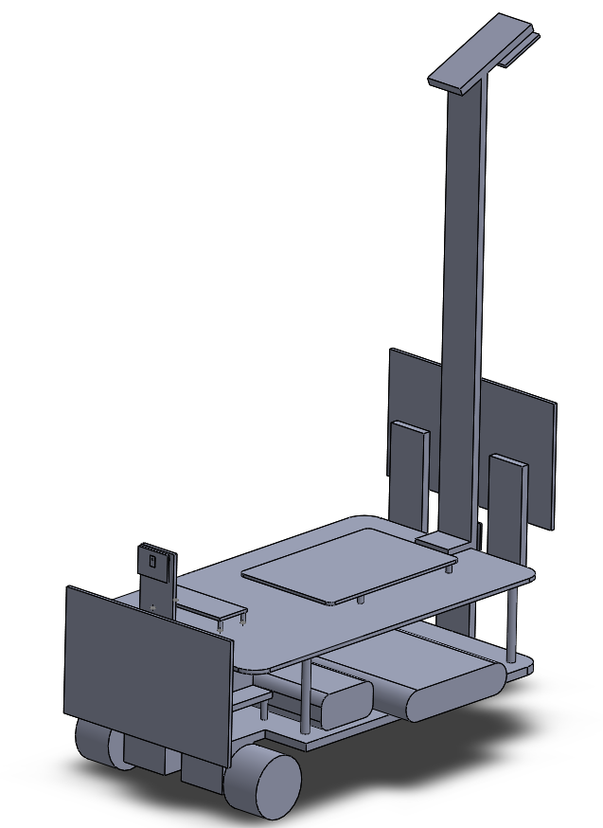
reports/weekly_reports/2019_03_19_Weekly_Report/3D-isometric-2.png
