temurtas/Capstone_Duayenler/reports/weekly_reports/2019_03_19_Weekly_Report/down_3.png

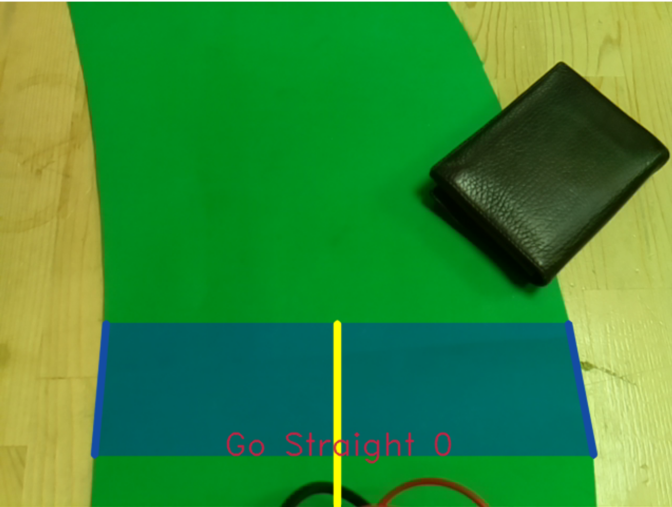
reports/weekly_reports/2019_03_19_Weekly_Report/down_3.png
