temurtas/Capstone_Duayenler/reports/weekly_reports/2019_04_09_Weekly_Report/kalman2.jpg

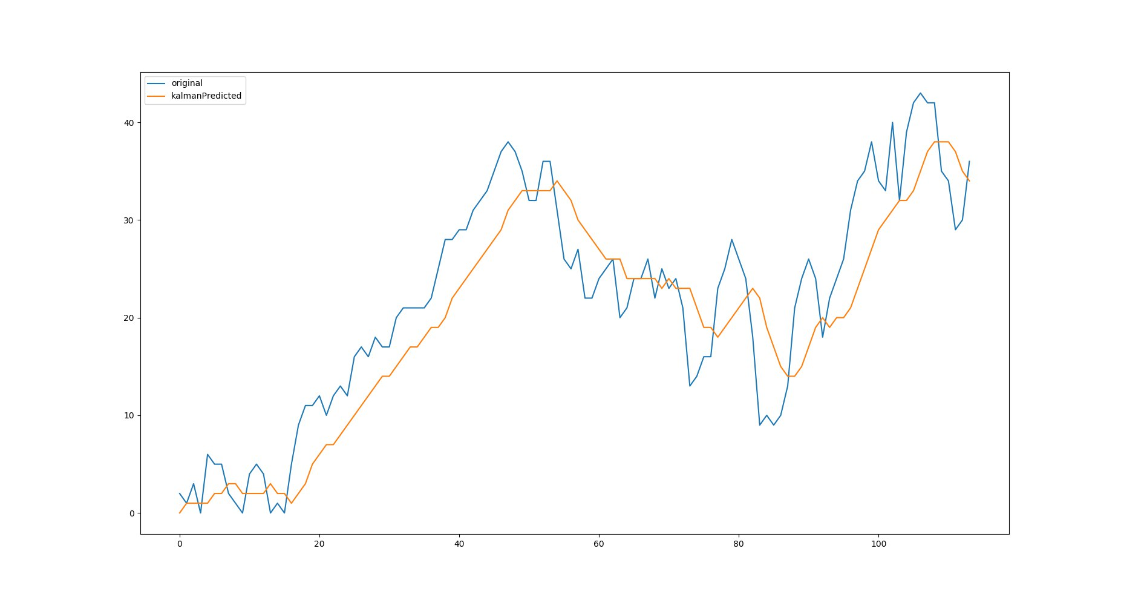
reports/weekly_reports/2019_04_09_Weekly_Report/kalman2.jpg
