temurtas/Capstone_Duayenler/reports/weekly_reports/2019_04_09_Weekly_Report/one-line-detection.jpg

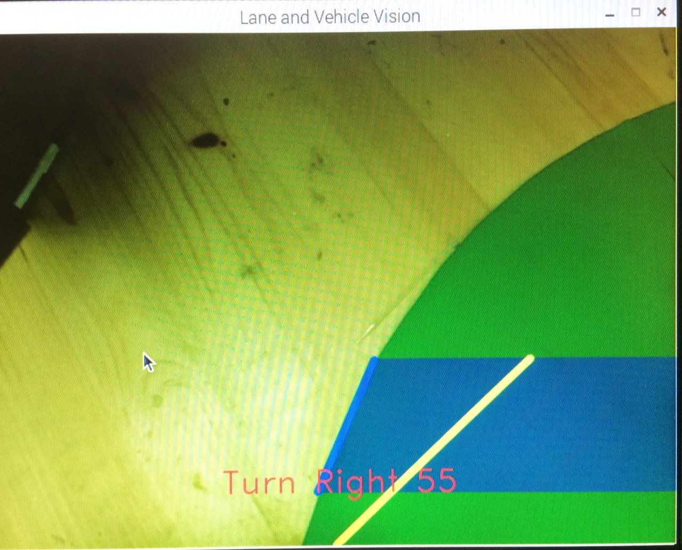
reports/weekly_reports/2019_04_09_Weekly_Report/one-line-detection.jpg
