temurtas/Capstone_Duayenler/resources/chassis/3d-isometric-view.png

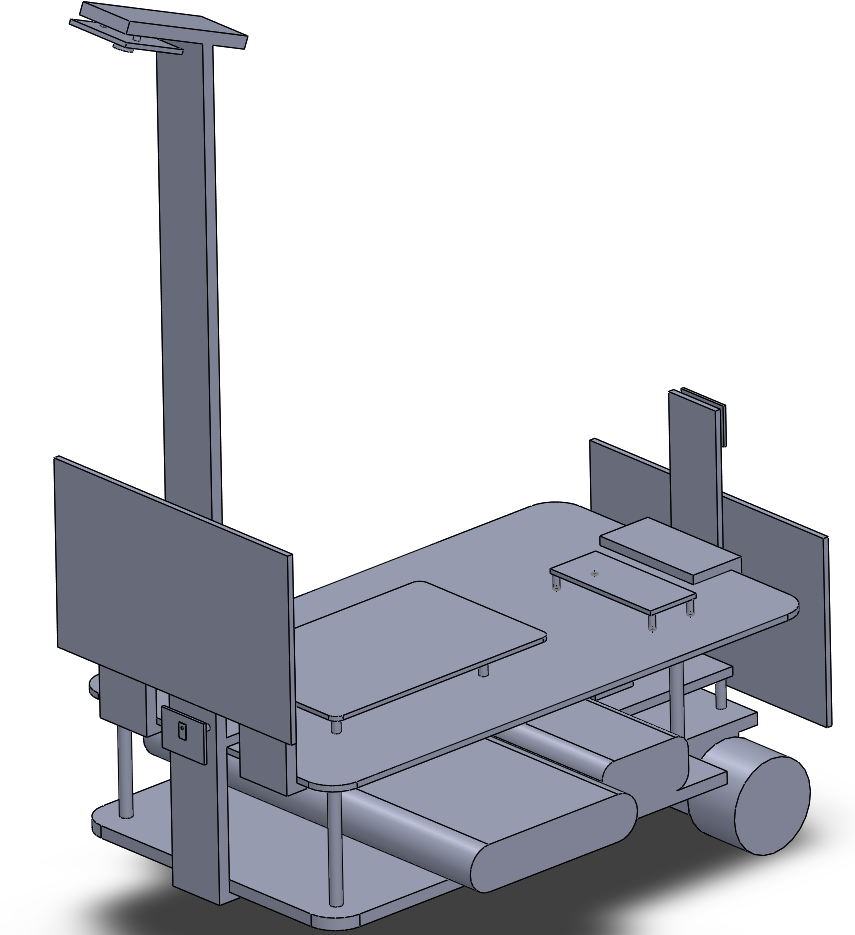
resources/chassis/3d-isometric-view.png
