temurtas/Capstone_Duayenler/resources/chassis/front-colored.png

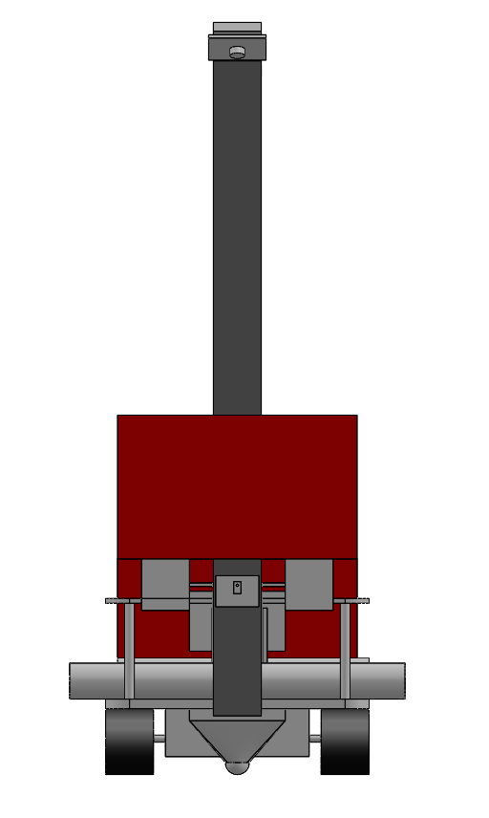
resources/chassis/front-colored.png
