temurtas/Capstone_Duayenler/resources/chassis/iso-colored.png

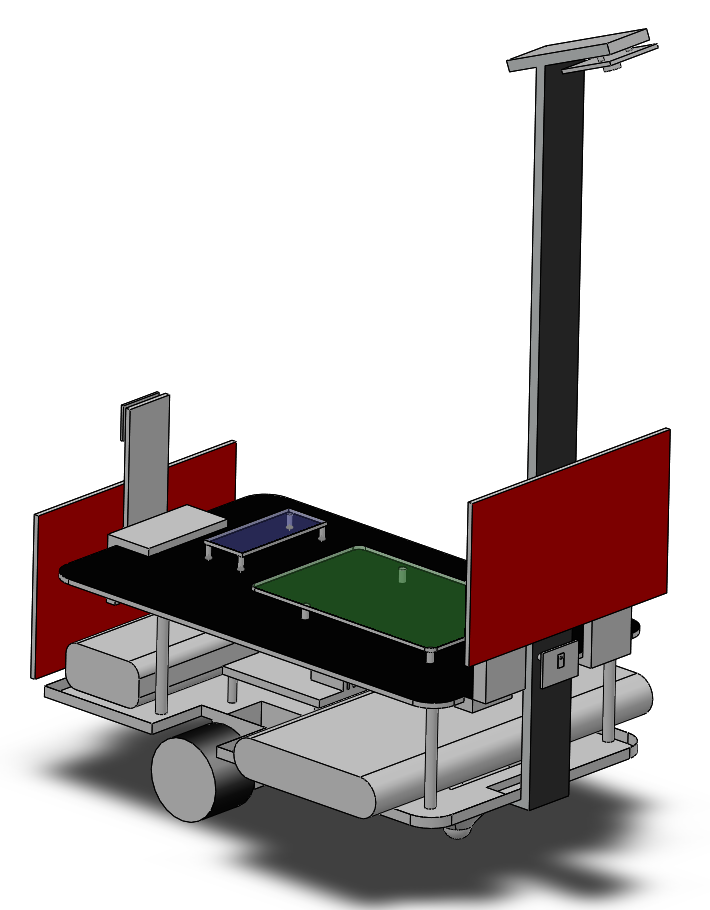
resources/chassis/iso-colored.png
