temurtas/Capstone_Duayenler/resources/chassis/photo6012391320737394640.jpg

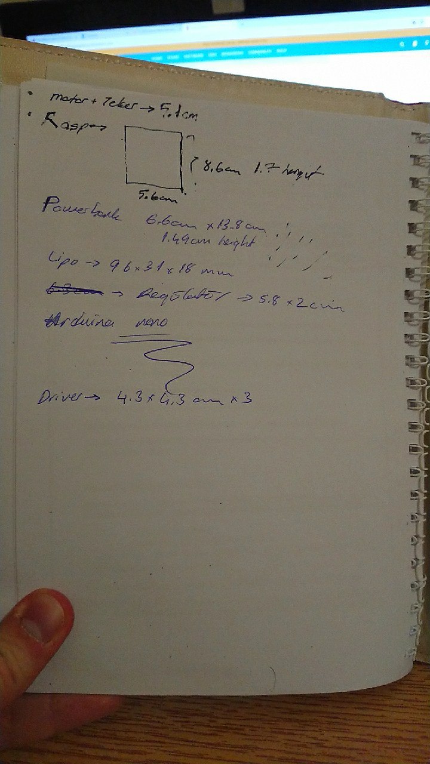
resources/chassis/photo6012391320737394640.jpg
