temurtas/Capstone_Duayenler/resources/chassis/plaetli.PNG

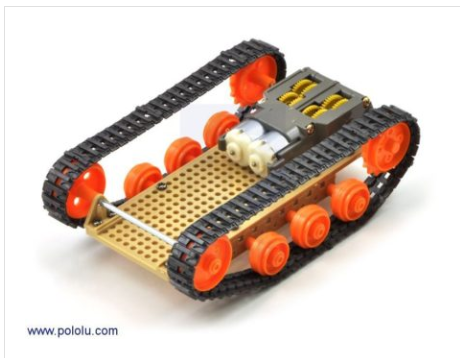
resources/chassis/plaetli.PNG
