temurtas/Capstone_Duayenler/resources/chassis/side-colored.png

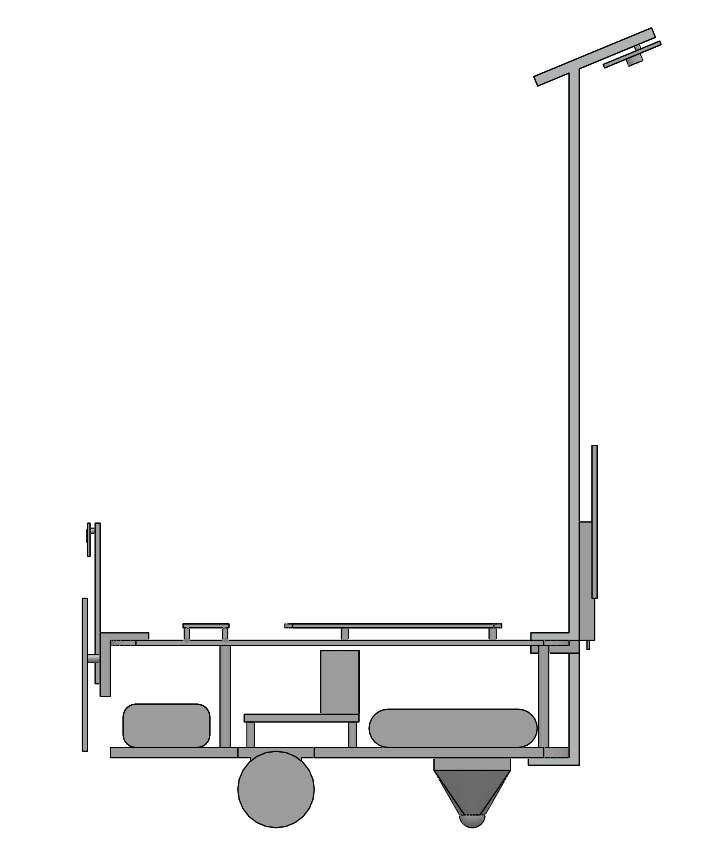
resources/chassis/side-colored.png
