temurtas/Capstone_Duayenler/resources/green-path/IMG_20181125_103835.jpg

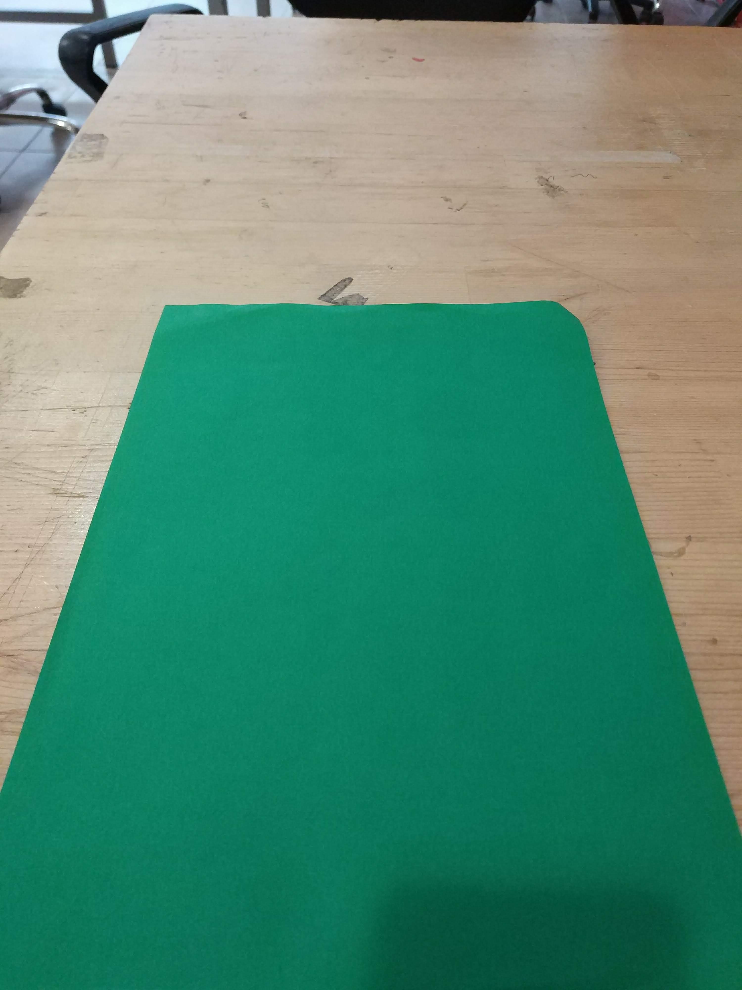
resources/green-path/IMG_20181125_103835.jpg
