temurtas/Capstone_Duayenler/resources/green-path/IMG_20181125_103839.jpg

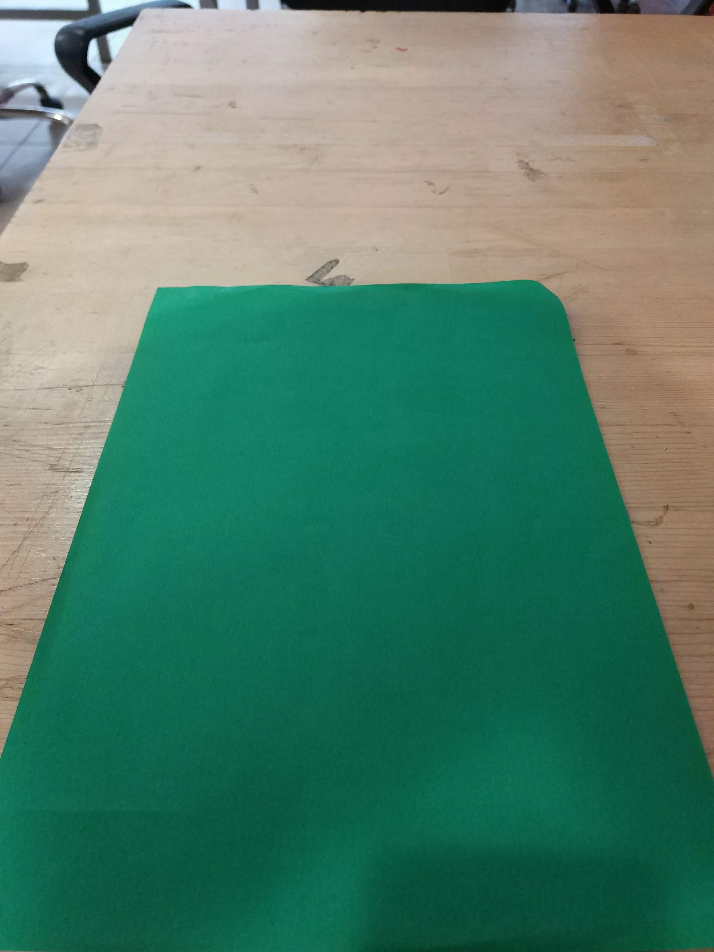
resources/green-path/IMG_20181125_103839.jpg
