temurtas/Capstone_Duayenler/resources/green-path/IMG_20181125_103841.jpg

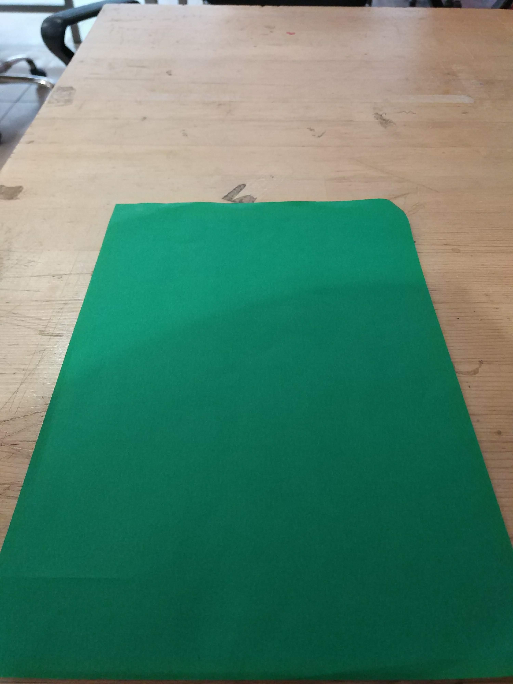
resources/green-path/IMG_20181125_103841.jpg
