temurtas/Capstone_Duayenler/resources/green-path/IMG_20181125_103918-canny-processed-1.jpg

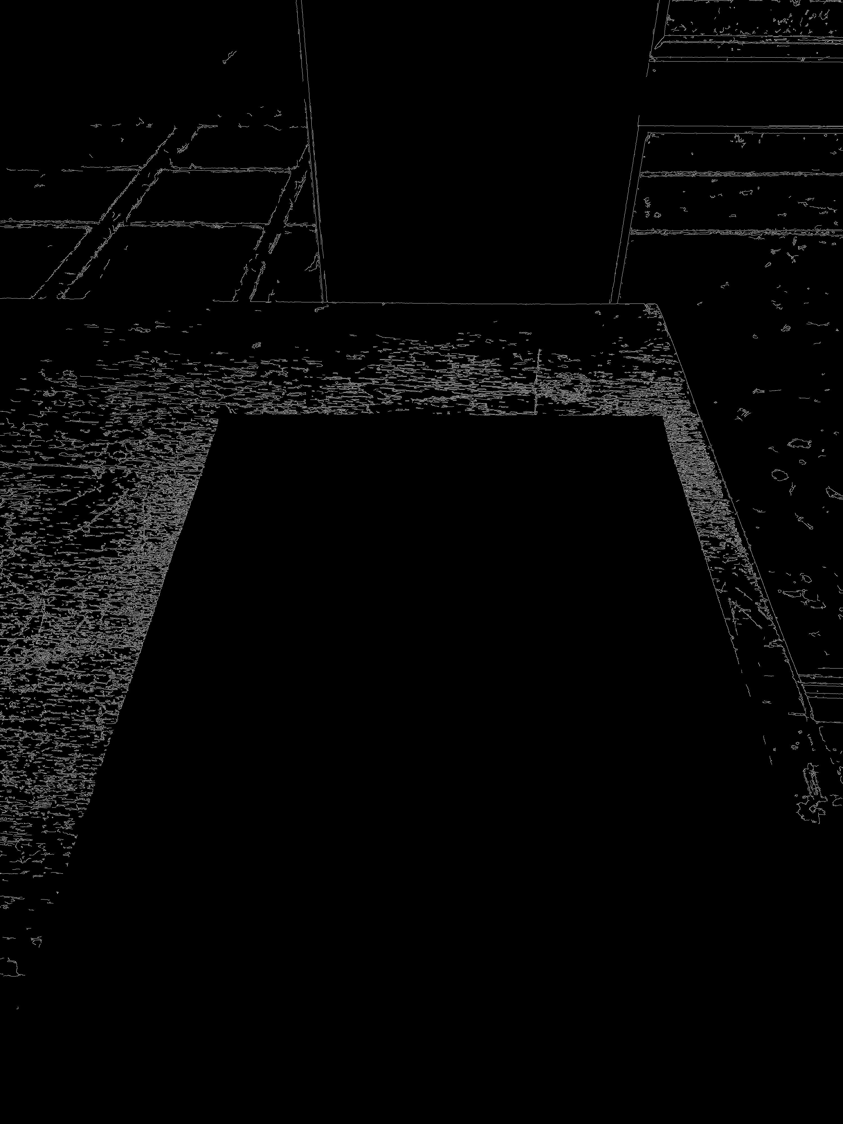
resources/green-path/IMG_20181125_103918-canny-processed-1.jpg
