temurtas/Capstone_Duayenler/resources/green-path/IMG_20181125_104017-canny-processed-1.jpg

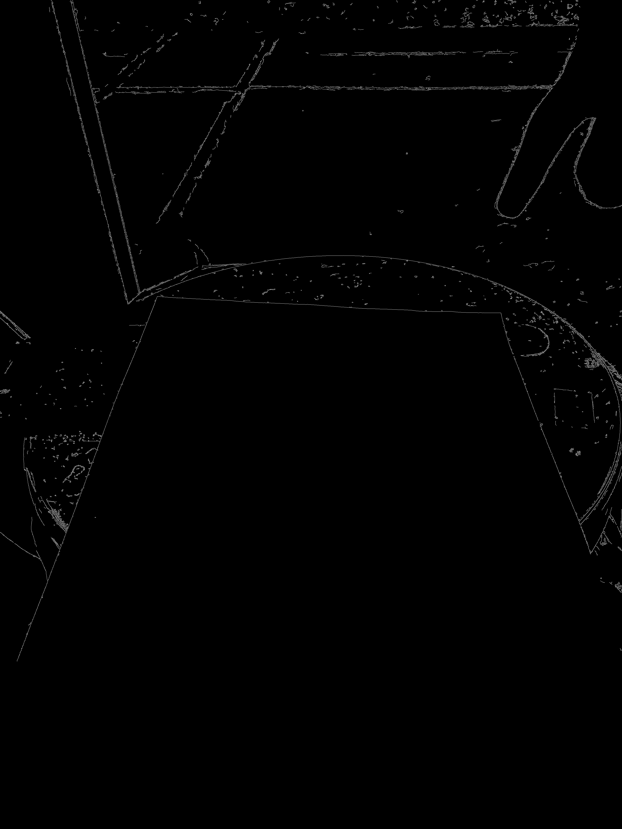
resources/green-path/IMG_20181125_104017-canny-processed-1.jpg
