temurtas/Capstone_Duayenler/resources/green-path/IMG_20181125_104338.jpg

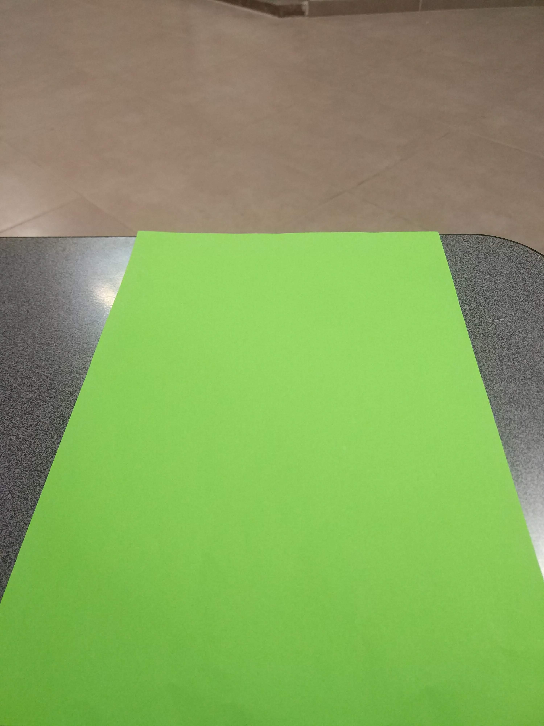
resources/green-path/IMG_20181125_104338.jpg
