temurtas/Capstone_Duayenler/resources/green-path/IMG_20181125_104444.jpg

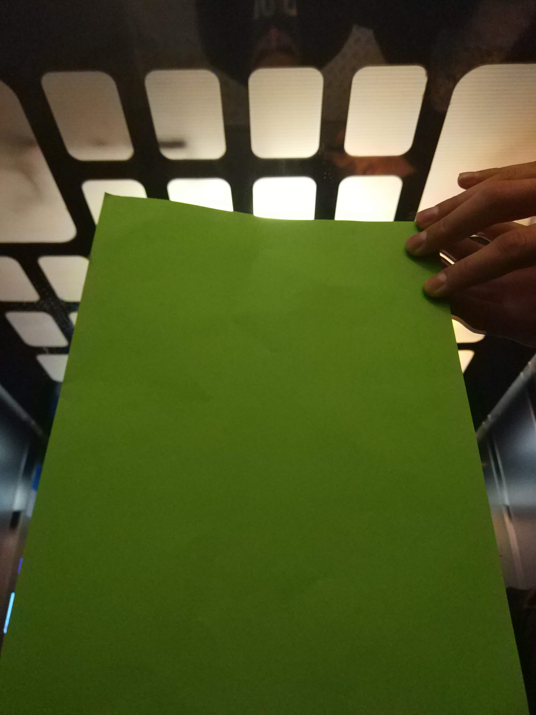
resources/green-path/IMG_20181125_104444.jpg
