temurtas/Capstone_Duayenler/resources/green-path/IMG_20181125_104558-canny-processed-2.jpg

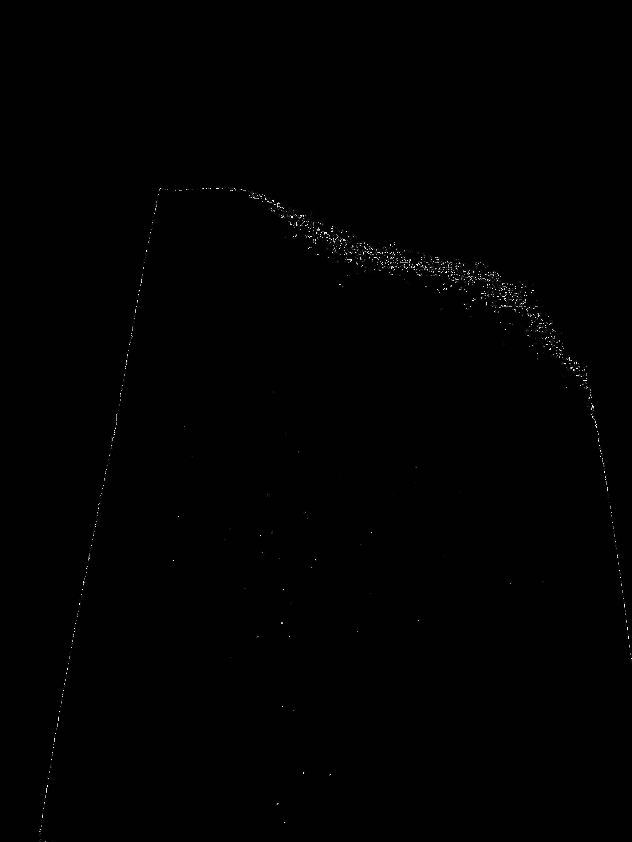
resources/green-path/IMG_20181125_104558-canny-processed-2.jpg
