temurtas/Capstone_Duayenler/resources/green-path/IMG_20181125_104558.jpg

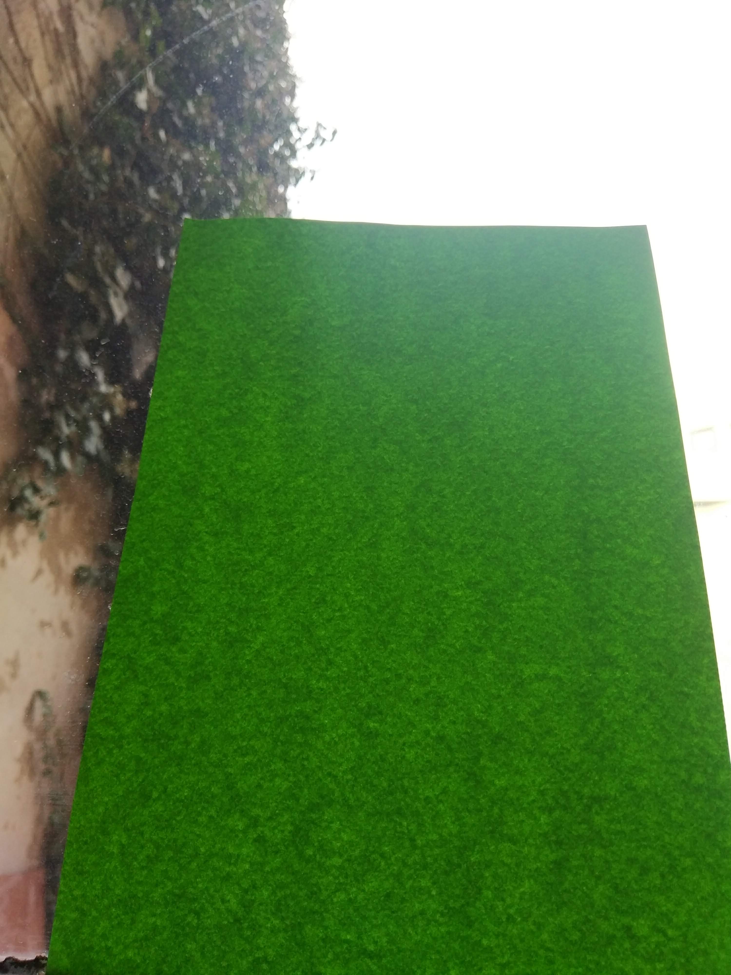
resources/green-path/IMG_20181125_104558.jpg
