temurtas/Capstone_Duayenler/resources/component_list.xlsx

Component Name | Code | Price | Datasheet | Web Link | Description
Sharp GP2Y0A41SK | - | 75,54 TL | klasörde | https://www.robotistan.com/sharp-gp2y0a41sk-4-30cm-sensor-infrared-proximity-sensor-short-range | Analog o/p, laser based distance sensor for 4-30 cm
Sharp GP2Y0D805Z0F | - | 42,41TL | klasörde | https://www.robotistan.com/sharp-gp2y0d805z0f-kizilotesi-sensor-5-cm | Digital o/p, laser based distance sensor for 0-5 cm
Raspberry Pi Kamera Modülü V2 | - | 235 TL | klasörde | https://www.robotistan.com/raspberry-pi-kamera-modulu-camera?query=kamera& | Official camera v2 for Raspberry (Quality Sensor)
Waveshare Raspberry Kamera - Ayarlanabilir Fokus (B) | - | 145,11 TL | - | https://www.robotistan.com/raspberry-kamera-ayarlanabilir-fokus | Just Camera for Raspberry Pi
Waveshare Raspberry Pi Kamera - Ayarlanabilir Fokus + Kızılötesi Led Modülü (F) | - | 186,21 TL | - | https://www.robotistan.com/raspberry-pi-kamera-ayarli-kizilotesi-led-modulu | Camera w/ light Sensors for Raspberry Pi
waveshare Laser sensor |  | 82.16TL | _ | https://www.robotistan.com/lazer-mesafe-sensoru | Digital o/p, laser based distance sensor for 0.8-1.5m
Reflective Optical Sensor with Transistor Output |  | .99TL | kalsörde | https://www.robotistan.com/tcrt5000-kizilotesi-sensor?query=k%C4%B1z%C4%B1l%C3%B6tesi%20sens%C3%B6r& | IR sensör for 0.2 to 15mm
IR sensor card (8) |  | 67TL | _ | https://www.robotistan.com/qtr-8rc-kizilotesi-sensor?query=k%C4%B1z%C4%B1l%C3%B6tesi%20sens%C3%B6r& | IR sensör for 3mm
TF mini LiDAR |  | 273.83TL | klasörde | https://www.direnc.net/tf-mini-lidar-tof-lazer-menzil-sensoru-dfrobot | Laser menzil sensörü for mapping
MZ80 kızılötesi sensör |  | 35.4TL | _ | https://www.robolinkmarket.com/e18-d80nk-3-80cm-ayarlanabilir-kizilotesi-sensor-mz80.html | 3-80cm distance measurement
RF reciever |  | 27.38 TL |  | https://goo.gl/PXGHXA | 433MHz RF receiver
RF modue |  | 113.54 TL |  | https://goo.gl/FMKJEs | RF module with high operating frequency
Camera |  | 59.90$ |  | https://www.amazon.com/Pixy2-Smart-Vision-Sensor-BeagleBone/dp/B07D1CLYD2 | Pixy2 Image Sensor for Arduino and Raspberry Pi
Colour sensor |  | 20.71 TL |  | https://www.robolinkmarket.com/tcs3200-renk-sensoru.html | TCS3200 Color Sensor
1000rpm motor |  | 121TL |  | https://www.robotistan.com/301-12v-1000rpm-karbon-fircali-mikro-metal-dc-motor-pl-3038?query=dc%20motor | micro motor mid current (0.8A)
1500rpm motor |  | 53TL |  | https://www.robotistan.com/12v-16mm-1500rpm-reduktorlu-dc-motor | micro motor high current (1.4A)
Ultrasonic distance sensor |  | 8 TL |  | https://www.robotistan.com/hc-sr04-ultrasonik-mesafe-sensoru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 | 40KHz sonic measurement 2cm to 4m 3mm precision
L293D motor driver |  | 36.64 TL |  | https://goo.gl/LdgS8J | 2 DC or 1 step motor 0.6A (1.2A peak) 4.5-36V
L293D motor driver |  | 22.30 TL |  | https://goo.gl/2AcC8U | double l293d IC with lower price than single one rest is the same
L298N motor driver |  | 19.05 TL |  | https://goo.gl/kSozm7 | 2 DC or 1 step motor 2A for each 6-15V
PCA9685 Servo driver |  | 21.75 TL |  | https://goo.gl/vX4HLz | 16 channel 12 bit servo (pwm) driver
Servo motor |  | 36.36 TL |  | https://goo.gl/VhdDSz | Torque 1.6kg 4.8-6V
Servo motor |  | 17.90 TL |  | https://goo.gl/Nac12B | Torque 1.3kg 4.8-7V
Stepper motor driver A4988 |  | 19.90 TL |  | https://goo.gl/T5PD32 | 8-35 V, 2A per coil
Some stepper motors |  | - |  | https://www.robotshop.com/en/stepper-motors.html Expensive
Stepper motor |  | 112.39 TL |  | https://goo.gl/7RR5m3 | 0.95A 4.2 ohm 1.6 kg-cm 2.5mH
Stepper motor |  | 10.92 TL |  | https://goo.gl/98u28P | Arduino hobby type
DC motor with encoder |  | 134.17 TL |  | https://goo.gl/fLA5p4
Palet lastiği |  | 1.4-2.2$ |  | https://goo.gl/acJPS3 | ucuz lastik palet
plalet lastiği-2 |  | 3.7$ |  | https://goo.gl/o8bqYG | ucuzdan pahalı lastik palet
plalet lastiği-3 |  | 6$ |  | https://goo.gl/vKvxu3 | ucuzdan pahalıdan ucuz lastik çift fiyat
Palet bakla x20 |  | 20tl |  | https://www.robotistan.com/palet-bakla-seti-20li | bakla bakla palet hemide yerli
teker (https://www.robotzade.com/Siyah,PR-1495.html) |  | 37 |  | https://www.robotzade.com/Siyah,PR-1495.html | tekerlek emergency
motor |  | 52 |  | https://www.robotzade.com/Karbon-6V-600Rpm-Dc-Motor,PR-1181.html | motor
 |  |  |  | motor
