temurtas/Capstone_Duayenler/resources/findings_about_projects.xlsx

Project Name | Link | Description
Mapper Robot | http://www.societyofrobots.com/robotforum/index.php?topic=5342.0 http://www.societyofrobots.com/robotforum/index.php?topic=3144.0 | An algorithm to discover a covered area (A*)
Mapper Robot | http://www.societyofrobots.com/robotforum/index.php?topic=2671.0 | Generic search term for mapper robots SLAM
Mapper Robot | http://www.societyofrobots.com/robotforum/index.php?topic=13649.0 | wavefront mapping | Note: We can use this file to further specify the projects.
 | http://www.societyofrobots.com/robotforum/index.php?topic=2684.0 | SLAM | Entries here than later can be used for the standard committee.
 | http://www.societyofrobots.com/robotforum/index.php?topic=1692.0 | 2D MAPPING
 | http://www.societyofrobots.com/robotforum/index.php?topic=14221.0 | SLAM implementation
 | http://www.societyofrobots.com/robotforum/index.php?topic=15436.0 | mapping algorithm
 | http://www.societyofrobots.com/robotforum/index.php?topic=3688.0 | A* algorithm
Mapping | http://www.societyofrobots.com/robotforum/index.php?topic=5183.0 | scanning regions
Mapping | http://www.societyofrobots.com/robotforum/index.php?topic=3144.0 | A* algorithm
Mapping | https://www.sciencedirect.com/science/article/pii/S1877050915038375 | general approach to sensor slam
Mapping | http://openslam.org/ | Slam area
multiple | https://www.raspberrypi.org/documentation/usage/camera/ | RPİ camera module explainer
multiple | https://projects.raspberrypi.org/en/projects/getting-started-with-picamera | Rpi and python to use onboard camera learning
Hokey | https://www.elprocus.com/rf-module-transmitter-receiver/ | RF transmitter-receiver document
For all Projects | https://www.servomagazine.com/magazine/article/tips_for_selecting_dc_motors_for_your_mobile_robot | A general concept to calculate required torque for the vehicle
mapping | http://lawrencerobotics.blogspot.com/2014/02/arduino-matlab-slam.html | Ultrasonic mapping
