temurtas/Capstone_Duayenler/resources/chassis/motor-holderSLDPRT.SLDPRT

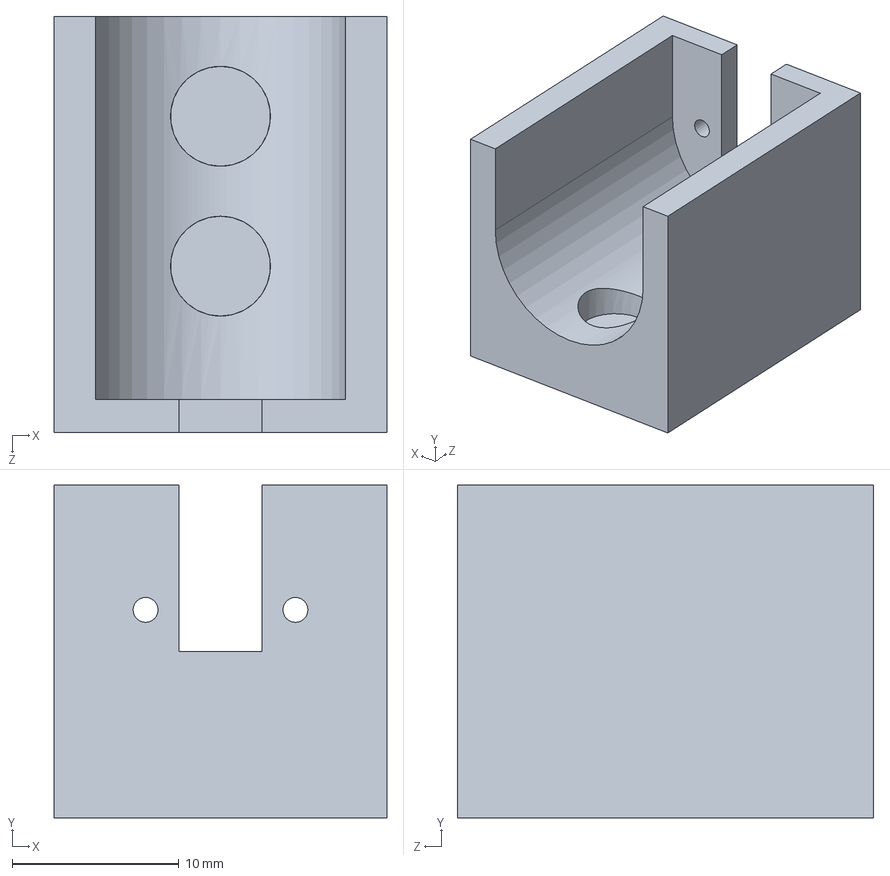
[picture p304: CAD file, 2019-03-03]
resources/chassis/motor-holderSLDPRT.SLDPRT
20.0 x 20.0 x 25.0 mm
