temurtas/Capstone_Duayenler/resources/chassis/base1.SLDPRT

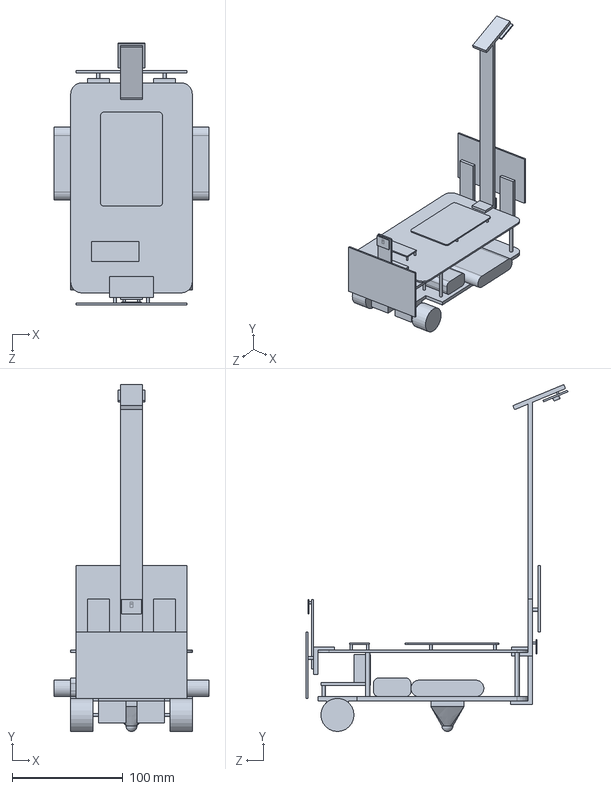
[picture p305: CAD file, 2019-03-03]
resources/chassis/base1.SLDPRT
140.0 x 313.9 x 237.1 mm
