temurtas/Capstone_Duayenler/(list of files, cad)

Other CAD files:
resources/chassis/chassis2.0.DWG
resources/chassis/chassis3.0.DWG
resources/chassis/chassis.SLDPRT
resources/chassis/chassis.DWG
