temurtas/Capstone_Duayenler/codes/Step_Responses/24_03_responses.png

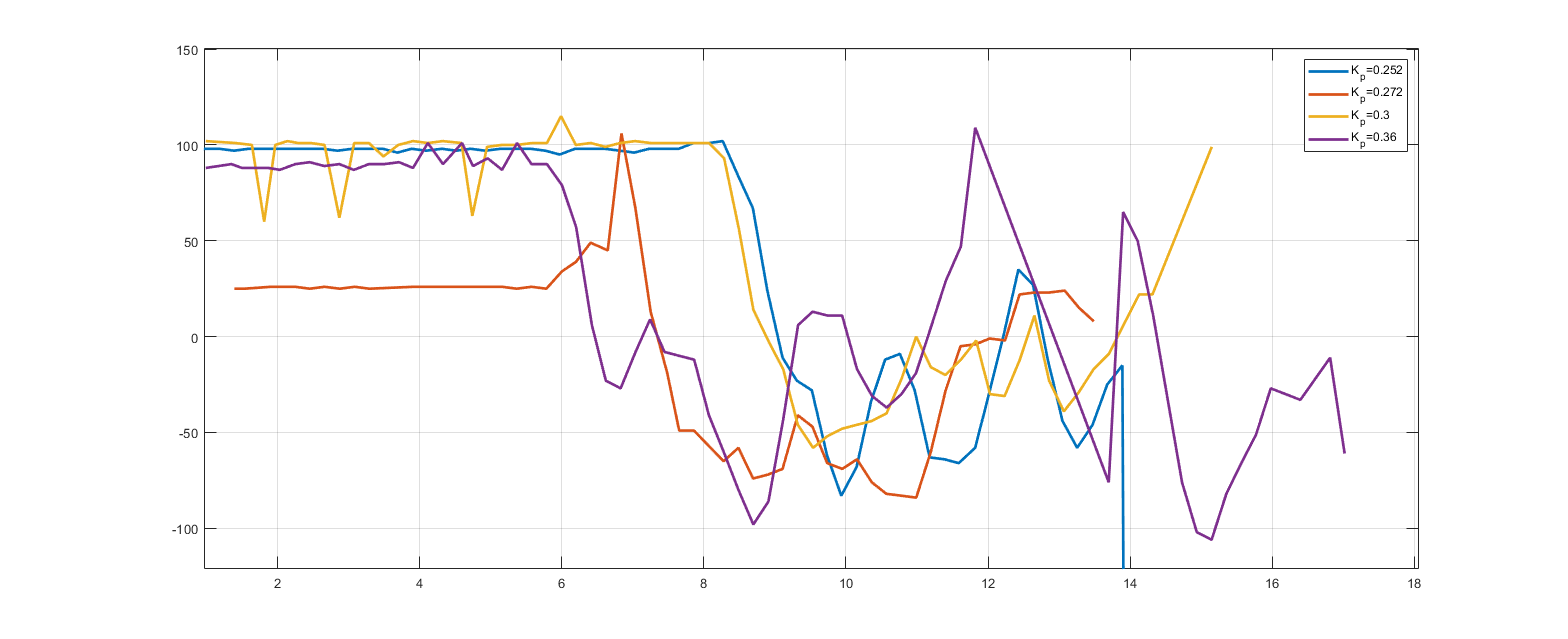
codes/Step_Responses/24_03_responses.png
