temurtas/Capstone_Duayenler/codes/Step_Responses/step1.png

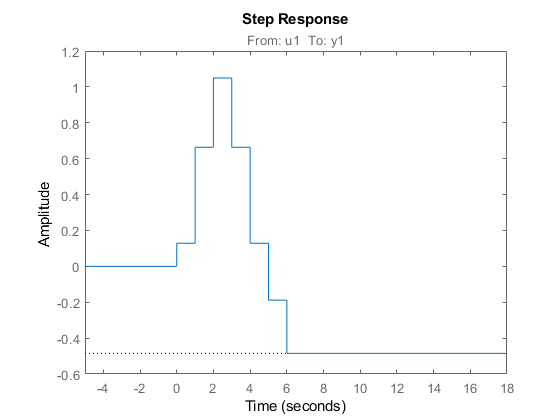
codes/Step_Responses/step1.png
