temurtas/Capstone_Duayenler/codes/with_c++_KobraGozu/testFilter.txt

-20.4095 0
-20.2079 -5.10239
-20.2079 -8.87877
-19.8031 -11.7111
-21.0112 -13.7341
-20.4095 -15.5533
-21.8058 -16.7674
-19.5999 -18.027
-19.5999 -18.4202
-19.5999 -18.7151
-21.8058 -18.9363
-19.5999 -19.6537
-20.2079 -19.6402
-20.8112 -19.7822
-20.0057 -20.0394
-19.5999 -20.031
-21.0112 -19.9232
-20.4095 -20.1952
-18.1631 -20.2488
-20.0057 -19.7274
-19.3961 -19.797
-20.8112 -19.6968
-38.9367 -19.9754
-21.8058 -24.7157
-6.84201 -23.9882
-6.84201 -19.7017
-7.96896 -16.4868
-5.25562 -14.3573
-7.74402 -12.0819
-7.96896 -10.9974
-6.84201 -10.2403
-6.84201 -9.39073
-6.84201 -8.75355
-6.84201 -8.27567
-9.08984 -7.91725
-8.41809 -8.2104
-7.06784 -8.26232
-7.06784 -7.9637
-8.64227 -7.73974
-9.75912 -7.96537
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
