temurtas/Capstone_Duayenler/codes/with_c++_KobraGozu/testTime.txt

4257.13 262.444
6687.82 104.383
9195.1 108.709
13700 106.574
15924.5 106.953
18911.6 111.008
21480.8 108.122
23345.6 105.494
25221.9 105.609
27234.4 105.839
29245.6 105.378
31327.9 105.404
33272.5 105.215
36954.4 107.271
39586.8 107.913
43547.2 114.507
46250.6 111.623
48254.3 103.639
50133.7 106.542
52844.7 103.719
54926.9 106.369
57494.3 109.796
61380.9 107.948
63671.8 107.205
66185.7 115.479
68738.9 115.8
71031.7 106.164
74223.6 111.582
76784.3 108.911
79844 105.121
82486.9 105.9
85130.2 107.408
87828.6 107.649
90606.5 107.952
93246.5 110.785
95813.2 112.255
98037.5 110.999
100114 112.64
102817 110.036
105529 108.317
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
