temurtas/Capstone_Duayenler/codes/28_04_2019/testTime.txt

3359.26 348.05
4045.12 51.7141
4667.32 52.6232
5504.17 57.3436
6408.66 51.9093
7311.32 53.4357
8286.42 53.1184
9179.44 53.4973
10227.6 51.2766
11548.9 52.2919
12508 51.0142
13982.2 50.5012
14799.6 52.1085
15851.9 53.7516
16614.5 53.614
17586.6 52.7924
18420.4 55.4891
19311.5 54.2752
20079.6 51.8563
20846.3 57.4353
21961.2 51.6686
23132.9 51.6837
23830.9 52.4162
24657.9 54.9678
25703.5 51.3812
26806.4 50.1087
27784.1 52.5691
28956.6 49.4887
30076.9 48.2854
30843.7 54.8769
31603.8 51.2922
32229.2 52.683
33748 51.7989
34718.4 49.1588
35980.7 42.9694
36668.3 52.1435
37426.1 51.3631
38055 50.0246
39091.4 52.5531
40340.4 55.9727
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
