temurtas/Capstone_Duayenler/codes/with_c++_handshakeMerged/test.txt

-79.5 0 -2.51889 0
-79.5 -74 -2.06134 -2
-78.5 -78 -3.20462 -2
-79 -78 -2.29016 -3
-76 -78 -8.41809 -2
-78 -76 -2.97614 -7
-77 -77 -2.29016 -3
-71.5 -77 0 -2
-60 -72 -2.97614 0
-53.5 -61 1.60353 -2
-36.5 -54 3.88943 0
7.5 -39 13.9298 3
5.5 0 13.497 12
4.5 4 13.28 13
3.5 4 13.7136 13
3 3 13.7136 13
3 3 12.4082 13
1 3 12.6267 12
-13.5 1 9.98164 12
-21.5 -11 8.19365 10
-31.5 -20 7.74403 8
-49 -29 1.14552 7
-64 -46 0.687371 2
-63.5 -61 0.458259 0
-58.5 -63 -0.458252 0
-58 -59 1.37455 0
-49.5 -58 3.20461 1
-49 -50 3.66127 2
-49 -49 3.88943 3
-48.5 -49 3.43299 3
-50 -48 4.11747 3
-49 -49 3.88943 4
-49 -49 3.88943 3
-48 -49 3.20461 3
-36.5 -48 5.48278 3
5 -38 11.5305 5
16 -1 14.1456 10
27.5 13 17.5399 13
28.5 25 17.5399 16
38.5 28 17.5399 17
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
