temurtas/Capstone_Duayenler/codes/with_c++_handshakeMerged/testFilter.txt

25.4575 0
26.9322 3.18219
24.5166 6.15094
27.4755 8.44666
25.6439 10.8253
24.706 12.6776
26.75 14.1811
26.75 15.7522
24.706 17.127
24.706 18.0743
24.8947 18.9033
25.2705 19.6522
24.5166 20.3545
26.3836 20.8748
24.8947 21.5634
25.0829 21.9798
23.9452 22.3677
24.5166 22.5649
25.6439 22.8088
25.2705 23.1632
25.8297 23.4266
28.8979 23.727
25.4575 24.3734
27.1139 24.5089
24.8947 24.8345
24.5166 24.8421
24.8947 24.8014
25.2705 24.813
25.6439 24.8702
26.75 24.9669
25.2705 25.1898
24.706 25.1999
24.1362 25.1382
27.1139 25.0129
25.8297 25.2755
28.5459 25.3448
26.75 25.745
25.8297 25.8706
28.8979 25.8655
27.295 26.2445
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
