temurtas/Capstone_Duayenler/codes/with_c++_handshakeMerged/testFilter2.txt

-14.3611 0
-14.576 -1.79513
-14.3611 -3.39274
-12.8448 -4.76378
-13.9298 -5.77391
-13.7136 -6.7934
-15.2185 -7.65842
-15.2185 -8.60343
-13.0626 -9.43031
-15.2185 -9.88434
-15.4318 -10.5511
-13.9298 -11.1612
-15.857 -11.5073
-13.497 -12.051
-14.3611 -12.2317
-14.3611 -12.4979
-14.7906 -12.7308
-14.3611 -12.9883
-14.7906 -13.1599
-14.3611 -13.3637
-14.1456 -13.4884
-14.3611 -13.5705
-14.576 -13.6694
-13.497 -13.7827
-14.1456 -13.747
-15.0048 -13.7968
-15.0048 -13.9478
-15.0048 -14.0799
-15.0048 -14.1955
-14.576 -14.2967
-13.9298 -14.3316
-14.1456 -14.2814
-14.3611 -14.2644
-14.1456 -14.2765
-13.497 -14.2601
-13.7136 -14.1647
-14.1456 -14.1083
-10.4258 -14.113
-12.8448 -13.6521
-14.1456 -13.5512
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
