temurtas/Capstone_Duayenler/codes/with_c++_handshakeMerged/testFilter3.txt

-11.3102 0
-11.3102 -1.41378
-11.3102 -2.65083
-12.1893 -3.73325
-11.3102 -4.79026
-11.5305 -5.60525
-11.0896 -6.3459
-11.3102 -6.93886
-11.3102 -7.48528
-11.3102 -7.9634
-11.3102 -8.38175
-10.8686 -8.74781
-11.5305 -9.01291
-10.6474 -9.32761
-10.8686 -9.49258
-12.4081 -9.66458
-11.7504 -10.0075
-11.5305 -10.2254
-11.7504 -10.3885
-11.5305 -10.5588
-10.2039 -10.6802
-8.41809 -10.6207
-11.97 -10.3454
-12.4081 -10.5484
-10.4258 -10.7809
-12.6267 -10.7365
-11.3102 -10.9728
-14.3611 -11.015
-12.4081 -11.4332
-10.2039 -11.5551
-8.19366 -11.3862
-10.2039 -10.9871
-8.86618 -10.8892
-11.5305 -10.6363
-10.4258 -10.7481
-10.8686 -10.7078
-8.86618 -10.7279
-12.6267 -10.4952
-13.9298 -10.7616
-10.6474 -11.1577
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
