temurtas/Capstone_Duayenler/codes/28_04_2019/test15-2.txt

6943.63 32

7145.36 31

7351.38 33

7561.05 33

7774.38 32

7977.56 33

8198.68 32

8409.25 33

8607.07 34

8811.82 33

9016.36 32

9231.88 33

9443.46 33

9647.38 33

9851.66 33

10062.2 33

10275.4 32

10486.1 33

10683.5 33

10893.5 33

11105.8 33

11318 32

11529.4 34

11740.3 34

11944.7 33

12139.9 33

12348.4 33

12559.1 32

12769.7 33

12967.2 33

13183.8 33

13389.4 33

13605.2 34

13813 33

14026.1 32

14231.6 32

14440.6 32

14646.4 33

14867.4 33

15070.8 33

15273.5 33

15483.4 32

15690.8 20

15904.8 19

16105.2 14

16318.3 -4

16516 1

16722.4 1

16935.6 1

17142 1

17350.4 1

17562.5 2

17766.4 3

17974 2

18183.7 3

18396.2 2

18605.6 3

18830.7 2

19019.8 3

19223.1 1

19431.6 7

19640.2 9

19858.2 15

20060.6 46

20267.8 76

20487.3 109

20682.8 61

20897.5 71

21099 93

21309.7 112

21520.2 124

21725.4 119

21927.4 96

22136.6 70

22342.3 119

22553.2 96

22766.6 67

22978.6 36

23191 15

23402.1 17

23600.9 42

23810.3 70

24011.7 93

24221.6 105

24427.1 66

24632.8 94

24842.9 83

25049 147

25258.4 122

25473.8 73

25681.4 16

25890 -26

26099.7 -30

26304.2 1

26513 63

26736.2 138

26932.4 127

27134.9 156

27339.9 162

27544.7 140

27756.9 103

27965.8 132

28175.5 86

28389 41

28595.2 7

28801 1

29013.7 28

29216.8 79

29425 132

29631.6 88

29838.9 94

30048.7 89

30255.8 85

30471 80

30677.4 86

30890.9 87

31105 92

31296.6 96

31513.9 97

31719.9 102

31923.2 109

32133.4 106

32339.1 105

32548.7 133

32767.7 150

32967.9 536

33180.5 317

33392.8 377

34208.1 -30

34850.1 75

35046.2 49

35269 125

35475.4 3

35731.9 63

35967 6

36302.1 -641

36599 97

36877.2 -696

37072.2 157

37279.8 64

37514.1 -141

37731.7 -150

37908.6 460

38136.6 374
