temurtas/Capstone_Duayenler/codes/28_04_2019/test15.txt

8657.93 199

8869.17 -16

9089.89 -351

9251.01 1

9440.18 1

9641.52 1

9848.36 1

10055 1

10280.7 -370

10483 1

10698 -336

10938.6 21

11189 -8

11402.3 -4

11588.5 11

11776.1 46

11964.8 31

12155.3 8

12349.3 67

12554.7 12

12764.6 12

12980.7 12

13181.8 11

13389.3 12

13594.7 12

13803.6 11

14016 11

14224.8 19

14441.8 21

14651.7 25

14853.1 24

15057.8 16

15269.3 16

15469.6 19

15674.5 24

15879.4 24

16094.6 24

16305.2 34

16530.3 32

16720.6 28

16934.8 27

17139.1 28

17353.7 27

17550.3 27

17775.3 28

17975.1 27

18181.6 27

18390 27

18601.3 28

18805.4 28

19014.1 28

19222.6 27

19431.8 27

19639 29

19851.4 44

20054.1 75

20262.9 79

20473.8 76

20686.1 57

20896.4 37

21104 20

21305.6 19

21520.1 27

21728 46

21927.6 58

22126.2 71

22355.3 62

22550.2 46

22765.6 28

22976.9 14

23174.4 -1

23385.2 5

23592.9 26

23800.3 52

24009.2 67

24216.8 73

24424.1 68

24632.5 60

24842.5 54

25057.8 30

25269.6 13

25474 -2

25684.3 -2

25894.6 19

26106.3 33

26302.2 47

26513.1 60

26718.1 72

26937.2 92

27136.2 104

27344.5 93

27550.2 66

27760.4 70

27966.9 66

28172.1 23

28380.1 -11

28588.5 -25

28804.8 -7

29014.5 37

29215.7 93

29422 127

29628 71

29836.1 132

30047.5 110

30255.1 69

30463.3 22

30671.9 -26

30881.8 -53

31098.7 -47

31295.5 -21

31504.9 17

31714.3 73

31919 62

32128 489

32338.4 255

32545.3 122

32747.5 301

33394.3 -201

33599.6 96

33798.4 79

34012.9 118

34216.9 1115

34419.9 252

34637.9 291

34840.2 257

35052.6 -90

35295.7 -100

35483.2 74

35690.5 46

35914.4 15

36113.4 25

36310.7 51

36518.3 30

36732.9 31

36923 31

37130 31

37342.2 31

37544 30

37750.2 31

37965.8 31

38167.3 31

38371.7 31

38585.6 32

38800.3 31

39006.4 31

39228 31

39453.3 31

39629.5 30
