temurtas/Capstone_Duayenler/codes/Step_Responses/test.txt

1016.1 A 49.000000

1427.23 A 51.000000

1702.43 A 50.000000

2000.15 A 49.000000

2258.08 A 48.000000

2478.57 A 50.000000

2693.2 A 48.000000

2906.08 A 55.000000

3119.02 A 65.000000

3327.62 A 87.000000

3486.45 A 99.000000

3623.44 A 100.000000

3764.2 A 100.000000

3968.96 A 79.000000

4175.2 A 44.000000

4383.83 A 17.000000

4592.41 A 18.000000

4851.16 A 21.000000

5010.27 A 5.000000

5217.16 B 50.000000

5425.35 B 42.000000

5633.18 B 43.000000

5841.64 B 42.000000

6052.46 B 47.000000

6258.63 B 59.000000

6466.32 B 63.000000

6677.09 B 57.000000

6883.27 B 47.000000

7089.83 B 0.000000

7293.79 A 53.000000

7503.37 A 81.000000

7712 A 105.000000

7924.66 A 115.000000

8129.48 A 113.000000

8335.68 A 111.000000

8543.53 A 107.000000

8751.82 A 91.000000

8971.59 A 22.000000

9210.55 B 12.000000

9375.85 B 3.000000

9583.93 B 11.000000

9792.22 B 1.000000

10000 A 20.000000

10211.5 A 38.000000

10417.4 A 23.000000

10627.2 A 5.000000

10838.4 A 23.000000

11040.9 A 36.000000

11252.4 A 4.000000

11493.6 A 12.000000

11673 A 37.000000

11881.5 A 2.000000

12110.5 A 21.000000

12342.4 A 35.000000

12505.9 B 7.000000

12714 B 3.000000

12922.4 A 26.000000

13130.6 A 5.000000

13340.6 B 14.000000

13546.6 A 16.000000

13755.9 A 21.000000

13962.9 B 9.000000

14171.5 B 11.000000

14381.7 B 13.000000

14588.3 B 12.000000

14796.3 B 6.000000

15012.3 B 11.000000

15213.6 B 13.000000
