temurtas/Capstone_Duayenler/codes/Step_Responses/test2.txt

1016.1  49.000000

1427.23  51.000000

1702.43  50.000000

2000.15  49.000000

2258.08  48.000000

2478.57  50.000000

2693.2  48.000000

2906.08  55.000000

3119.02  65.000000

3327.62  87.000000

3486.45  99.000000

3623.44  100.000000

3764.2  100.000000

3968.96  79.000000

4175.2  44.000000

4383.83  17.000000

4592.41  18.000000

4851.16  21.000000

5010.27  5.000000

5217.16 -50.000000

5425.35 -42.000000

5633.18 -43.000000

5841.64 -42.000000

6052.46 -47.000000

6258.63 -59.000000

6466.32 -63.000000

6677.09 -57.000000

6883.27 -47.000000

7089.83 -0.000000

7293.79  53.000000

7503.37  81.000000

7712  105.000000

7924.66  115.000000

8129.48  113.000000

8335.68  111.000000

8543.53  107.000000

8751.82  91.000000

8971.59  22.000000

9210.55 -12.000000

9375.85 -3.000000

9583.93 -11.000000

9792.22 -1.000000

10000  20.000000

10211.5  38.000000

10417.4  23.000000

10627.2  5.000000

10838.4  23.000000

11040.9  36.000000

11252.4  4.000000

11493.6  12.000000

11673  37.000000

11881.5  2.000000

12110.5  21.000000

12342.4  35.000000

12505.9 -7.000000

12714 -3.000000

12922.4  26.000000

13130.6  5.000000

13340.6 -14.000000

13546.6  16.000000

13755.9  21.000000

13962.9 -9.000000

14171.5 -11.000000

14381.7 -13.000000

14588.3 -12.000000

14796.3 -6.000000

15012.3 -11.000000

15213.6 -13.000000
