temurtas/Capstone_Duayenler/codes/Step_Responses/test3.txt

1019.47 -36

1534.19 -35

1831.78 -37

2193.79 -37

2455.86 -35

2687.03 -35

2917.56 -35

3145.26 -35

3368.86 -37

3544.91 -38

3684.85 -36

3819.73 -35

3977.41 -40

4178.43 -39

4387.88 -31

4597.88 -26

4813.9 -67

5068.57 -113

5233.71 -73

5425.14 -10

5635.13 35

5855.96 61

6055.02 70

6258.38 71

6466.61 35

6678.65 16

6890.74 -33

7090.31 10

7299.67 24

7507.92 6

7717.03 -16

7922.82 -45

8133.46 -9

8346.3 35

8544.06 5

8757.93 -33

8970.98 1

9182.14 -6

9389.43 9

9590.31 19

9796.82 -12

10006.6 -21

10220.8 -15

10430.5 7

10635.7 -23

10839.4 -24

11048.7 -26

11258.8 -29

11464.9 -22

11679.7 74

11880.6 103

12094.3 101

12307.7 103

12507.3 58

12716.2 -89

12929.3 -82

13143 -81

13342.9 -58

13544.3 103

13753.1 -33

13963.8 58

14174.1 38

14379.9 36

14585.2 64

14792.9 103

15003.9 51

15210.6 35

15421.1 3

15626.5 -33

15837.3 16

16044.4 12

16256.7 11

16462.8 12

16684.2 12

16876.7 11

17088.8 11

17303.3 12

17514.8 11

17716.8 12

17919.7 11

18131.9 11

18334.1 12

18550.8 11
