temurtas/Capstone_Duayenler/codes/Step_Responses/test4.txt

994.87 122

1278.06 122

1449.99 122

1643.53 122

1826.64 123

2031.77 122

2246.24 122

2450.03 109

2657.1 84

2870.89 122

3080.07 123

3288.05 122

3490.55 84

3698.95 123

3907.49 123

4153.25 123

4348.37 123

4591.69 123

4742.84 122

4949.66 123

5156.7 122

5367.06 123

5572.43 122

5792.81 122

5988.75 83

6200.43 83

6417.91 44

6629.77 624

6827.73 586

7045.99 -52

7249.2 -43

7456.17 -780

7674.58 -1907

7873.44 -211

8076.17 -93

8296.58 509

8491.84 35

8700.85 46

8909.52 40

9120.88 -123

9327.33 -100

9536.23 -67

9744.97 -97

9953.69 -78

10157.8 -29

10361.4 -33

10570.4 -130

10992.4 121

11201.7 81

11408.5 91

11626.8 102

11827.6 85

12031.1 71

12241.3 88

12453.1 104

12661.4 94

12862.8 92

13106.5 75

13302.6 97

13490.2 88

13713.5 183

13901.1 97

14110 94

14316.9 98

14525.4 93

14737.4 91

14956.7 96

15167 92

15356.9 91

15575.5 92

15793.7 92

15991.8 94

16202.3 92

16402.6 92

16608.8 92

16818.4 94

17030.5 93

17238 93

17449.2 94

17657.2 91

17870.5 93

18076 92

18283.4 93

18496.7 93

18696.9 93

18908.7 92

19118.2 92

19324.4 94

19534.1 91

19741.6 91

19955.1 91

20163.1 96

20375.6 93

20568.3 97

20782.4 94

20995.1 91

21207.1 93

21398.9 92

21615.6 98

21817.3 97

22030.8 98

22233 98

22448.1 98

22651.6 98

22857.9 98

23065.9 97

23273.3 98

23479.6 98

23689 98

23900.5 98

24116.2 98

24311.8 98

24522.8 97

24735.2 98

24946.3 98

25159.6 98

25367.2 96

25565.1 98

25770.5 97

25992.7 98

26193.6 97

26395.8 98

26601.6 97

26818 98

27022.6 98

27239.2 98

27448.2 97

27650.9 95

27865.8 98

28071.6 98

28283.4 98

28502.3 97

28700 96

28910.6 98

29117.3 98

29327 98

29534.5 101

29755.5 101

29946.1 102

30161.2 84

30370.3 67

30573.6 24

30788.1 -11

30989.7 -23

31200.2 -28

31414.6 -62

31614.6 -83

31830.3 -68

32032.6 -34

32231.4 -12

32440.1 -9

32648 -28

32858.4 -63

33067.1 -64

33268.5 -66

33498.9 -58

33700.4 -29

33907.4 2

34107.7 35

34313.8 27

34521.4 -12

34729 -44

34935.1 -58

35152 -46

35358.5 -25

35571.6 -15

35774.3 -1544

35976.7 -1505

40974 -1791

41185.7 -1701

41394.3 -1496

41600.9 -1503

41805.3 -1519

42021.8 -1514

42220.4 -1501

42430.2 -1482

42675.5 -1465

42852.5 -1455

43058.3 -1589

43274.2 -129

43479.7 -150

43683.4 -9

43890.2 -36

44097.5 -31

44306.8 -31

44560.8 -31

44737.3 -31

44936.7 -31

45143.1 -33

45352.6 -114

45562.5 -72

45770 -38

45979.8 3

46193.6 59

46396.3 89
