temurtas/Capstone_Duayenler/codes/Step_Responses/test5.txt

1389.32 25

1532.43 25

1904.66 26

2050.86 26

2243.75 26

2451.36 25

2659.02 26

2874.67 25

3084.1 26

3290.86 25

3909.82 26

4112.78 26

4327.47 26

4595.14 26

4754.86 26

4948.2 26

5156.56 26

5365.33 25

5573.23 26

5782.19 25

6000.22 34

6198.33 39

6404.97 49

6645.96 45

6839.41 106

7035.56 67

7250.25 13

7483.74 -19

7651.9 -49

7859.92 -49

8068.05 -57

8277.06 -65

8485.36 -58

8691.94 -74

8901.03 -72

9107.29 -69

9321.75 -41

9528.32 -47

9735.03 -66

9947.45 -69

10154.9 -64

10363.8 -76

10567.7 -82

10783.5 -83

10988.8 -84

11195.2 -60

11402.9 -28

11612.7 -5

11822.2 -4

12023.6 -1

12239.6 -2

12443.3 22

12649.8 23

12855.5 23

13078.3 24

13281.7 15

13488.5 8
