temurtas/Capstone_Duayenler/codes/Step_Responses/test6.txt

987.903 102

1404.77 101

1636.98 100

1809.49 60

1965.78 100

2137.34 102

2286.78 101

2465.78 101

2659.33 100

2868.22 62

3076.19 101

3283.79 101

3488.86 94

3696.05 100

3905.55 102

4113.63 101

4325.5 102

4587.87 101

4739.98 63

4946.78 99

5155.01 100

5364.97 100

5584.79 101

5790.56 101

5988.39 115

6196.7 100

6405.12 101

6613.67 99

6821.15 101

7031.87 102

7250.81 101

7450.14 101

7658.34 101

7861.73 101

8072.09 101

8284.8 93

8493.26 56

8696.27 14

8917.32 -3

9116.13 -17

9322.07 -46

9537.08 -58

9735.51 -52

9949.46 -48

10153.8 -46

10364.8 -44

10571.5 -40

10782.4 -22

10988.4 0

11195 -16

11400.7 -20

11617.3 -12

11832.5 -2

12028.2 -30

12233.2 -31

12447.7 -12

12653.7 11

12859.9 -23

13067.4 -39

13278.3 -29

13485.1 -17

13700.8 -9

14126 22

14314.5 22
