temurtas/Capstone_Duayenler/codes/Step_Responses/test62.txt

5584.79 101

5790.56 101

5988.39 101

6196.7 101

6405.12 101

6613.67 101

6821.15 101

7031.87 101

7250.81 101

7450.14 101

7658.34 101

7861.73 101

8072.09 101

8284.8 101

8493.26 101

8696.27 101

8917.32 101

9116.13 101

9322.07 101

9537.08 101

9735.51 101

9949.46 101

10153.8 101

10364.8 101

10571.5 101

10782.4 101

10988.4 101

11195 101

11400.7 101

11617.3 101

11832.5 101

12028.2 101

12233.2 101

12447.7 101

12653.7 101

12859.9 101

13067.4 101

13278.3 101

13485.1 101

13700.8 101

14126 101

14314.5 101
