temurtas/Capstone_Duayenler/codes/Step_Responses/test7.txt

987.029 88

1348.55 90

1497.56 88

1703.79 88

1866.06 88

2029.59 87

2247.61 90

2451.82 91

2655.04 89

2868.85 90

3071.81 87

3283.6 90

3499.34 90

3708.46 91

3905.07 88

4113.24 101

4326.94 90

4594.39 101

4749.09 89

4956.64 93

5158.36 87

5369.42 101

5573.4 90

5790.63 90

6001.52 79

6202.19 57

6422.89 6

6619.08 -23

6827.58 -27

7037.39 -8

7242.07 9

7445.49 -8

7651.96 -10

7862.74 -12

8070.21 -41

8277.02 -60

8486.87 -80

8695.81 -98

8908.54 -86

9117.47 -43

9325.4 6

9529.67 13

9738.27 11

9945.84 11

10155.4 -17

10367.3 -31

10572.1 -37

10780.6 -30

10986.6 -19

11196.8 5

11404.1 29

11616.9 47

11819.6 109

13699 -76

13901.9 65

14105.4 50

14324.9 11

14534.5 -34

14730.8 -76

14938.3 -102

15146.8 -106

15354.4 -82

15565.8 -66

15773.8 -51

15979.9 -27

16189.6 -30

16396.6 -33

16815.9 -11

17019.6 -61
