temurtas/Capstone_Duayenler/codes/with_c++_handshakeMerged/step/test.txt

3551.86 133

3983.68 134

4143.92 156

4444.57 131

4637.03 133

4810.52 154

4981.05 152

5162.87 153

5332.52 156

5511.04 129

5712.27 151

5901.28 154

6114.01 153

6332.79 158

6526.51 131

6758.75 155

6958.94 155

7163.12 154

7375.1 152

7564.9 156

7785.49 154

7983.66 172

8191.28 140

8397.2 144

8608.43 135

8820.69 162

9035.54 167

9240.16 163

9454.77 167

9663.85 151

9862.63 191

10060.6 284

10277.6 223

10486.8 224

10691 223

10905.6 219

11109.7 222

11318.8 222

11519 216

11733.5 217

11941.9 213

12151.4 201

12355.2 173

12572.6 137

12776.1 114

12990.2 112

13195.4 119

13405.7 141

13612.2 170

13808.3 194

14027.3 226

14232.3 243

14430.5 250

14650.4 235

14852.7 220

15072.8 142

15280.7 111

15485.4 100

15692.9 182

15895.1 -12

16098 48

16318.2 188

16516.3 391

16725.1 306

17346.5 201

17551.1 163

17764.8 316

17973.5 302

18183.1 446

18396.1 364

18604.3 240

18812.9 105

19029 3

19248.3 -79

19456.3 -102

19658.5 -54

19863.8 13

20067.2 111

20279.8 174

20480 237

20697.9 256

20894.3 252

21106.8 224

21303.1 181

21515.7 121

21728.2 75

21937.3 77

22142.9 94

22350.1 137

22558 188

22762.4 269

22972 36

23178.8 28

23398 353

23601.3 184

23827.2 232

24019.6 403

24234.1 262

24436.8 216

24640.6 404

24848.7 136

25056.6 296

25255.3 258

25468.2 218

25683.4 174

25885.3 142

26107.5 119

26309 115

26510.2 107

26718 101

26933.4 118

27146.3 151

27354.7 181

27554.2 195

27766.9 208

27975.2 206

28184.1 200

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

55474.6 27

55661 23

55887.3 25

56080.7 27

56283.5 25

56493 27

56699.3 26

56905.6 26

57117.8 25

57331.5 26

57554.1 26

57743.2 26

57948.7 26

58164.3 28

58365.6 25

58578.9 26

58789.1 25

58986.1 25

59196.2 27

59413.3 25

59630 27

59822.5 25

60084.6 25

60247.5 26

60447 26
