temurtas/Capstone_Duayenler/codes/with_c++_handshakeMerged/step/test11_01.txt

3692.29 269

4008.03 299

8468.06 110

8676.38 110

8885.68 110

9110.06 111

9306.98 112

9522.15 112

9725.8 111

9929.4 112

10143.5 112

10344.8 112

10556.8 111

10766.1 111

10973.6 111

11182.3 111

11383.4 112

11609.3 112

11808.8 112

12025.5 113

12226.5 110

12440.7 110

12643.4 113

12849 104

13059.2 90

13275.6 80

13477.2 69

13684.2 84

13901.5 105

14099.9 109

14303.6 112

14507.9 113

14723.4 126

14929.4 140

15144.7 130

15355.1 135

15551.9 132

15770.7 128

15976.7 126

16190.1 130

16393.6 135

16600.6 146

16804.4 146

17013.1 141

17225.5 130

17428.5 145

17635.5 132

17861.2 120

18053.6 113

18267 107

18470.9 100

18678.7 101

18887 112

19092.6 128

19306.3 139

19510.2 120

19718.9 135

19936.2 127

20138.3 116

20358.2 102

20565.3 89

20773.4 96

20970.1 111

21178 132

21387.1 142

21589.6 135

21800.1 129

22011.2 80

22233.2 86

22434.8 96

22647.3 118

22842.6 157

23047.3 281

23253.9 196

23463.3 -10

23670.8 -303

24081.2 -432

24320.5 111

24554.7 -32

24749.4 6

24932.9 -45

25347.6 16

25549.1 23

25755.9 -17

25969.7 136

26179.7 181
