temurtas/Capstone_Duayenler/codes/with_c++_handshakeMerged/step/test12_01.txt

3719.29 341

4060.34 328

8727.35 106

8946.73 107

9153.69 107

9360.49 108

9570.37 108

9776.59 107

9994.15 108

10194.3 107

10401.8 108

10620.2 108

10838.1 108

11030.3 108

11240.5 108

11455.1 108

11709.7 106

11893.8 108

12082.2 105

12282 107

12503.6 102

12702.5 102

12895.3 103

13114.2 104

13322 121

13534.1 116

13745.1 107

13948.1 90

14169.1 65

14379.9 51

14570.7 62

14788.6 88

14984.8 122

15200.5 142

15398.8 128

15607.6 146

15836.6 133

16026.1 122

16234.9 118

16444.6 101

16650.9 100

16863.8 100

17065.3 107

17273.5 117

17497.5 123

17692.7 127

17909.6 120

18111.9 99

18324.5 86

18537.3 76

18740.2 81

18952.7 87

19151 96

19355.2 112

19564 119

19783.1 135

19988.5 146

20185.1 152

20396.9 146

20605.9 150

20810.8 125

21026.1 106

21230.8 95

21435.5 83

21657.3 79

21870 77

22070.8 84

22276.6 105

22482.2 123

22694.6 90

22898.3 144

23107.8 181

23314.6 197

23524.8 159

23738.1 125

23944 93

24150 70

24977.7 111
