temurtas/Capstone_Duayenler/codes/with_c++_handshakeMerged/step/test14-1.txt

8600.19 19

8816.31 7

9020.9 14

9234.55 10

9437.41 11

9648.37 10

9855.9 10

10060.6 10

10272.2 10

10473.9 11

10681.8 11

10914.9 12

11107.9 12

11310.8 11

11524.9 11

11721.3 11

11940.5 10

12142.5 10

12357.3 11

12564.4 10

12773.9 11

12981.6 11

13189.9 12

13399.7 11

13601.9 11

13812.8 10

14026 11

14228.2 11

14432.4 11

14638.8 11

14852 12

15059.3 10

15274.7 11

15474.1 10

15690.9 11

15912.6 11

16097.9 10

16304.6 12

16517 15

16724.6 19

16941.7 34

17141.4 58

17343.3 75

17558.8 93

17765 112

17974.5 109

18179.3 93

18380.6 72

18592.5 56

18804.5 50

19012.9 47

19220.8 58

19431.6 70

19649.3 79

19846.9 85

20052.9 88

20273.6 85

20469.5 72

20687.8 53

20895.6 34

21100.4 47

21309.9 79

21508.5 130

21726.9 126

21927.6 95

22149.8 47

22354.1 0

22565.4 -33

22761.6 -35

22970 -18

23182.1 -1

23385.9 33

23602 78

23806.2 126

24035.2 85

24222.4 97

24426.1 108

24632.7 119

24843.7 117

25052 100

25258.4 77

25471 134

25676.3 127

25898.4 93

26101.9 46

26310.5 1

26522.9 -19

26725.6 -5

26942.8 0

27139.2 27

27346 68

27550.6 116

27760.6 90

27966.1 110

28175.7 122

28389.5 131

28590.2 127

28798.8 103

29009.2 139

29224.5 106

29434.7 66

29654.2 23

29849.4 -18

30054.2 4

30265.6 61

30472.5 142

30688.4 303

30883.7 263
