temurtas/Capstone_Duayenler/codes/with_c++_handshakeMerged/step/test14-2.txt

4031.9 195

4294.94 166

4543.45 166

7276.33 -32

7499.07 2

7705.49 -26

7909.85 -32

8118.12 -28

8336.15 0

8534.93 13

8747.97 -10

8963.49 -3

9163.61 -5

9378.01 -11

9578.6 -10

9788.43 -11

9995.58 -10

10201.7 -11

10417.2 -13

10612.6 -15

10844.6 -15

11037.9 -16

11241.1 -17

11463.3 -16

11663.7 -16

11876 -18

12085.5 -16

12285.4 -17

12494 -16

12704.7 -6

12918.6 -5

13123 -7

13326.3 16

13540.7 21

13742.9 24

13951.8 42

14159.6 60

14374.8 57

14589.9 53

14790.9 39

14995.2 8

15200.9 -96

15413.5 -61

15620.3 15

15836.5 9

16029.9 -14

16241.5 6

16444 -88

16662.7 -84

16865.7 -64

17069.4 -53

17290 -47

17485 -44

17695.6 -52

17905 -50

18111.4 -48

18317.7 -48

18520.8 -44

18733.9 -29

18953.3 -19

19162.1 -3

19359 -23

19570.4 -36

19783.5 -31

19990.8 -47

20198.2 -44

20400.2 -42

20603.5 -33

20824.6 -33

21026.6 -40

21245.6 -40

21457.2 -41

21658.7 -40

21865.1 -39

22087 -39

22293 -43

22498.3 -39

22690.4 -40

22910.1 -41

23123.9 -40

23319.8 -40

23524.8 -40

23748 -39

23959.7 -39

24180.1 -39

24370.5 -39

24579.3 -38

24785.3 -38

25008.9 -39

25203.6 -39

25414 -39

25608.2 -38

25835.1 -40

26026.5 -38

26246.2 -41

26458.6 -38

26652.6 -38

26875.3 -37

27073.2 -23

27284.5 -8

27485.7 8

27727.1 24

27903.9 43

28115.1 52

28325 43

28537.2 -12

28739.2 -45

28948.5 -42

29155 -24

29364.9 9

29577.7 51

29773.7 89

29977.9 93

30191.8 53

30401.1 12

30605.7 -13

30819.1 -19

31019.3 -9

31227.4 4

31436.9 22

31673.4 35

31866.6 47

32083.2 56

32277.7 63

32486.4 67

32693 63

32907.9 62

33113.8 63

33324.3 59

33528.3 49

33738.4 47

33948.5 45

34155 46

34369.9 56

34561.4 62

34772.5 67

34984.3 78

35206.3 79

35405.5 71

35614.2 64

35840.3 48

36034.2 39

36227.9 30

36433.8 32

36644.6 42

36850.3 59

37058.1 76

37268.8 84

37474.8 91

37683.7 83

37893.8 64

38101.6 29

38310.7 -3

38523.6 -29

38724.2 -481

38937.3 29

39135.8 201

39342.8 403

39550.4 430

39759.9 368

39967.6 203

40197.6 92

40387.7 -14

40596.5 -198

40803.3 -331

41009 -315

41217.3 -184

41439.8 -47

41659 82

41864.3 306

42055.6 214

42256.1 215

42465.8 188

42675.9 371

42917.5 49

43114.7 -219

43323.6 -7366

43526.6 717

43930.3 261

44151.1 33

44357.3 10

44565.8 184

44827.1 183

45069.6 132

45622.4 81

45821.9 157

46029.7 220

46249.7 217

46437.6 72

47076.3 145

47284.2 164

47673 140
