temurtas/Capstone_Duayenler/codes/with_c++_handshakeMerged/step/test_09_1.txt

3683.85 -33

4070.42 -83

7246.23 0

7435.36 107

7603.48 106

7796.7 106

7984.73 107

8182.34 106

8389.42 107

8597 106

8805.58 107

9018.51 106

9229.07 108

9431.72 107

9640.32 108

9847.6 107

10056.2 107

10269.3 107

10477.1 107

10687.8 108

10890.4 107

11100 108

11307.2 106

11523 107

11724 107

11934.4 106

12151.9 107

12361 106

12560.4 108

12772.5 107

12970.4 107

13179.7 106

13388.7 106

13605.2 107

13804.7 107

14011 107

14226.5 107

14441.5 108

14639.5 107

14846 108

15059.6 107

15261.1 107

15488.2 107

15681.9 107

15904.9 106

16094.6 107

16302.1 107

16524.2 107

16729.8 107

16939.4 107

17152.2 107

17347.6 106

17565.3 107

17761.3 105

17979.7 107

18193.4 107

18385.5 107

18597.9 106

18814.5 107

19013.7 107

19223.8 107

19433.8 107

19640.9 107

19849.2 110

20059.1 110

20260.6 109

20476.7 110

20686 108

20892.2 111

21105.9 110

21310.6 111

21524.7 110

21732.4 109

21943.7 110

22145 109

22352.4 110

22561.2 111

22777.4 111

22993.4 112

23174.7 122

23388.2 62

23597.5 123

23808.4 127

24011.3 127

24220.6 128

24435.2 136

24645.6 130

24856.2 127

25054.8 123

25261 114

25469.3 118

25678.7 127

25889 144

26090.8 79

26300.1 89

26505.6 107

26714 134

26925 163

27133.1 178

27355.5 163

27549.7 148

27760 142

27962.6 131

28185.1 125

28389 126

28601 117

28798.9 109

29008.2 105

29220.9 101

29429.4 105

29626.8 109

29844.4 118

30053.1 120

30255.6 119

30468.2 118

30674.4 118

30877.9 121

31088.4 121

31296.3 110

31506.6 113

31711.1 122

31919.4 123

32129.2 133

32335.4 136

32545.2 132

32752.8 127

32970.9 105

33186.4 89

33388.1 146

33589.1 147

33802.3 126

34009.2 99

34224 70

34429.1 55

34636.8 43

34843.6 87

35050.5 126

35257.3 148

35460.5 207

35678 336

35881.7 280

36098.3 165

36302.5 -394

37127.6 -912

37343.4 227

38786.3 69

38998.5 148

39209 148

39425.3 331

39639.9 994

39842.6 203

40078.3 80

40294.8 276

40512.6 3

40719.9 -132

40951.9 -132

41182.2 -92

41402.7 -61

41558.4 91

41741.8 -103

41937.2 123

42143.5 402

42340.9 43

42540.3 -120

42952.6 358

43195.2 342

43377.9 463

43591.1 510

43788 102

44004.8 39

44209.9 -7

44417.4 -205

44660.9 -213

44890.1 -14520

45152.4 -7

45441.1 -88

45728.7 249

45973 45

46192.7 -81

46396.7 112

46606 14

46822.4 23

47044.1 64

47261.3 2

47511.8 -373

47772.7 73

48010.8 -458

48222.8 -103

48461.7 -319

48669 -148

48894.1 264

49108.1 414

49391.6 33

49616.1 -179

49841.5 -410

50071.3 38

50345.6 44

50603.7 -64

50876.9 -27

51113.5 -366

51379.4 -443

51625.5 143

51823.8 -117

52051.3 -203

52416.5 -727

52599.7 153

52778.7 120

52973.3 138

53152.6 24

53351.1 -58

53536.8 -36

53732.2 2

53924.8 26

54135.5 18

54341.4 18
