temurtas/Capstone_Duayenler/codes/with_c++_handshakeMerged/step/test_09_2.txt

3646.24 -54

4104.74 55

7281.34 26

7489.72 26

7710.98 26

7910.74 25

8116.3 26

8327.66 26

8536.18 25

8748.34 26

8951.16 24

9154.6 26

9362.67 26

9574.34 25

9774.41 25

9987.4 26

10189.8 26

10405.4 26

10628.3 26

10829.6 26

11034 25

11251.2 26

11447.6 27

11657.3 27

11858.9 26

12062.6 27

12269 26

12486.6 27

12695.3 27

12904.1 21

13112.1 21

13320.9 20

13530.4 21

13744.6 26

13960.8 5

14162.3 -10

14364 6

14580.3 28

14782.7 50

14993.3 89

15199.1 128

15401.6 152

15619.4 153

15828.3 150

16022.8 145

16233.4 131

16441.9 117

16654.7 109

16867.8 112

17074.7 107

17273.6 93

17484 99

17694.5 108

17904.4 128

18106.8 148

18319.4 153

18535.2 151

18748.8 143

18947 139

19148 122

19361.7 114

19576.2 110

19774.1 105

19994.3 84

20192.6 78

20401.7 154

20614.7 155

20834.2 142

21042.9 109

21237.6 88

21446.8 67

21655.8 76

21862.5 97

22071.3 124

22292.6 76

22501.6 99

22686.4 121

22905.9 148

23117.3 163

23311.9 165

23522 147

23735.4 119

23935.6 82

24154.2 123

24359.8 95

24571.6 70

24779.3 65

24989.5 68

25201.7 60

25411.6 66

25612.5 90

25832.9 109

26025.6 123

26238.4 143

26435.9 428

26652.7 283

26848.9 209

27067.6 109

27700.1 76

27911.6 44

28107.9 0

28340.5 131

28589.2 -96

28810.4 -78

28997.3 -101

29207 -402

29417.4 -721

29628.6 -458

29834.6 -401

30038.9 -277

30251.1 -342

30462 -336

30697.5 -342

31045 400

31355.7 152

31684.9 -2440

32012.5 76698

32311.3 76528

32586.7 46

32818 -407

33003.2 205

33214 137

33436.2 124

33681 -181

33909.9 -270

34129.2 -60

34354.4 -146

34554.7 138

34731.3 -58

34942 -61

35168.7 15

35385.8 13

35585.6 -75

35805.2 -10

35998.8 121

36185.7 -177

36400.2 -104

36612.9 -24

36846.6 28

37083.3 -67

37266.9 -195

37479 -36

37693.5 -66

37905.2 -34

38125 -21

38382.6 -184

38601.2 -88

38812.8 -52

39026 71

39245 -344

39456.6 106

39675.1 51

39857.1 -104

40065.2 -79

40274.9 -129

40454.9 181

40662.9 157

40966.4 1138

41212.8 186

41435 -122

41699.1 -15

41945.7 -124

42188.2 -153

42445.5 -769

42766.9 -769

43053 -550

43309.4 -398

43559.9 -144

43790 -42

44015.9 0

44216.7 68

44417.1 340

44629.1 140

44835.5 158

45023.2 82

45220.6 48

45416.8 119

45766.8 49

46087.6 65

46338.3 -3

46591.1 -68

46847.8 -92

47091.8 120

47283.8 125

47488 -28

47689 138

47866.3 144

48035.3 152

48202.4 167

48383.6 170

48585.8 166

48816.9 161

49011.6 155

49207.7 147

49423.1 148

49618.7 147

49842.1 149

50035.1 147

50241.6 147

50470.6 145

50660.9 143

50883.2 134

51078.2 122

51285.8 138

51505.3 130

51716.9 134

51916.8 161

52118.9 160

52327 187

52535.1 172

52742.9 167

52985.1 109

53165.5 116

53369.6 172

53573.1 174

53781.9 125

53991.5 123

54200.6 112

54409.3 115

54614.8 118

54821.6 118

55033.6 118

55243.5 118

55449.7 118

55655.1 118

55876.4 118

56078.2 118

56278.5 119

56491.1 118

56699.7 118

56905.7 118

57139.4 118

57324.6 118

57537.4 118

57736.8 118

57948.3 119

58167.8 118

58376.9 119

58574.2 118

58783.4 118

58990.2 118

59198.3 118

59404.1 118

59615.9 118

59860.3 118

60033.7 118

60237.2 118

60444.2 118

60655.2 119

60872.6 118

61074.8 118

61282.4 118

61488.9 118

61707.6 118

61908.7 118

62135.2 118

62323.5 117

62538.9 118

62745 118

62962.2 119

63156 118

63369.2 118

63568 118

63775.7 118

63986.1 118

64194.5 118

64410.1 118

64612.1 119

64817.6 118

65025 118

65235.1 118

65443.6 118

65669.4 119

65898.4 118

66078.1 118

66274.9 118

66492.1 118

66697 118

66910.7 118

67129.6 118

67326.3 118

67530 118

67764.9 118

67956.3 118

68149.5 118

68358.7 118

68572.2 118

68809.7 118

68981.7 118

69197.3 118

69397.5 118

69607.7 118

69822.1 118

70017.8 118

70232.2 118

70439.6 118

70650.6 118

70862.6 118

71093.8 119

71294.2 118

71496.6 119

71696.3 117

71912.3 118

72103.9 118
