temurtas/Capstone_Duayenler/codes/with_c++_handshakeMerged/step/test_105_01.txt

3562.31 288

3844.92 288

16516.5 37

16721.3 39

16928.2 68

17148.4 39

17354.5 39

17566.7 37

17772.3 40

17977.7 39

18180.8 38

18392.8 76

18599.5 38

18802.8 38

19012.3 38

19222.5 37

19430.9 37

19635.7 37

19843.4 37

20060.3 85

20263.5 78

20477.8 39

20688 38

20893.9 38

21097.2 37

21305 61

21512.1 37

21721.4 39

21932.8 39

22140.6 37

22345.8 73

22559.9 37

22777.8 39

22984.3 73

23193.2 35

23405.7 32

23599.3 34

23811.7 30

24019.2 65

24223.8 50

24431.6 47

24637.4 112

24844.3 110

25055.4 130

25254.4 143

25462.9 144

25673.1 131

25885.2 140

26089.9 119

26298.5 106

26509.1 100

26718.8 102

26931.2 116

27160.3 130

27359.9 128

27551.8 146

27767.8 163

27965.3 173

28171.2 183

28381.4 178

28596.5 161

28799.2 141

29015 150

29220.3 119

29426.1 95

29641.4 77

29844.9 75

30054.9 77

30260.6 90

30466.2 99

30671.6 118

30882.5 125

31097.4 132

31292.5 127

31504.9 141

31711.4 151

31919.7 161

32127.1 146

32344 149

32583.3 121

32766.2 105

32961.7 82

33171.4 70

33389.1 76

33590.8 102

33794.9 136

34008.2 138

34216.9 155

34424.5 166

34628.5 161

34836.7 154

35054.7 172

35253.4 190

35458.7 205

35692.6 336

35879 226

36084.3 74

36286.7 175

37122.6 11

37364.5 126

37575.5 104

37774.8 -34

38001.8 24

38315.2 -44
