temurtas/Capstone_Duayenler/codes/with_c++_handshakeMerged/step/test_10_01.txt

3608.15 341

3995.72 -186

14716.3 26

14924.4 26

15136.9 26

15347.1 26

15550.6 26

15770.6 27

15981.7 26

16186.1 27

16390.1 27

16593.3 26

16800.1 26

17010 26

17227.8 26

17424.9 26

17637.8 26

17850.1 26

18059.9 26

18264.7 27

18467.9 26

18675.5 27

18882.6 26

19090 26

19307.5 26

19510.3 26

19730.1 26

19925.4 27

20136.9 27

20356.1 26

20544.7 26

20755.7 26

20970.5 27

21170.6 25

21381.4 26

21590.5 27

21799.4 26

22007.8 26

22217 26

22425.6 26

22634.2 24

22832.9 26

23056.5 26

23265.5 25

23488.8 26

23686.2 26

23906 27

24096.2 27

24309.3 27

24537.3 26

24738.4 25

24940.7 26

25140.1 25

25352.6 26

25554.5 26

25767.2 26

25982.7 26

26187.1 25

26393.3 26

26598.9 26

26811.4 26

27015 26

27221.6 26

27435.5 25

27649.3 26

27844.2 26

28051 25

28257.8 20

28460.9 24

28680.6 23

28889.4 19

29093.9 22

29300.7 27

29509 34

29731.2 60

29927.9 77

30135.5 112

30341.6 142

30550.5 158

30763 176

30964 152

31169.7 116

31386 110

31591.5 84

31805.4 56

32006.9 27

32219 13

32422.4 19

32634.7 50

32833.3 71

33054.9 97

33286.9 128

33477 123

33671.2 133

33879.4 134

34084.8 129

34291.4 127

34500.1 124

34708.5 111

34915.8 110

35127 94

35333.9 89

35542.6 79

35744.4 78

35960.7 94

36174.6 108

36378.6 122

36583.5 129

36794 135

37003 137

37209.3 144

37406.1 142

37622.1 130

37831.2 116

38058.9 108

38244.7 106

38464.1 117

38667.8 124

38882.2 128

39092.3 118

39294.1 106

39499.4 100

39707.9 100

39914.6 97

40135.4 101

40334.4 119

40542.9 126

40754.4 139

40959.8 129

41176.5 107

41388.2 97

41586.7 104

41795.8 131

42000.7 191

42209.4 292

42412.5 214

42620.8 74

42828.7 -409

43467.9 -90

44699.6 280

44977.9 432

45181.3 108

45375.7 62

45615.3 64

45951.4 -463
