temurtas/Capstone_Duayenler/codes/with_c++_handshakeMerged/step/test_11_02.txt

10212.6 28

10422.5 28

10636 29

10852.6 28

11053.1 28

11258.1 28

11463.6 29

11675.6 29

11880.4 28

12090 28

12300.7 28

12509.7 29

12716.9 28

12922.4 28

13135.8 28

13355.4 28

13551.6 28

13770.1 28

13969.5 29

14186.7 28

14374.6 28

14628.7 28

14815.9 28

15006.4 28

15216 28

15449.8 29

15642.3 28

15858 27

16045.2 28

16258.6 28

16471.6 28

16675.8 28

16883.6 28

17088.2 29

17298.8 29

17519.4 28

17722 29

17938.9 28

18142 28

18336.1 29

18544.3 28

18765.3 28

18966.1 28

19171.2 28

19376.8 28

19585.2 28

19808.8 28

20017.8 29

20216.8 28

20429.7 28

20633.1 28

20850.5 28

21045.4 29

21275.5 29

21462.5 28

21667.6 28

21882.2 28

22089.3 28

22293 27

22500.6 28

22754 28

22938.6 28

23127.7 28

23333.8 28

23541.3 28

23755.9 28

23969.9 28

24171.7 28

24387.9 28

24606.9 28

24795.7 28

24998.9 28

25211.5 28

25419.8 28

25623.4 28

25843 28

26035.3 29

26256.2 28

26464.9 29

26666.7 29

26872.7 28

27087.3 28

27307.5 29

27497.9 28

27712.2 28

27921.3 29

28127.6 28

28344.8 28

28548 27

28752.7 28

28964.5 28

29174.6 28

29387.6 28

29579.5 28

29788.5 28

29996.8 28

30206.1 29

30412.3 28

30639.7 28

30861.4 28

31055.8 28

31254.9 28

31465.1 28

31698.5 20

31875.8 2

32081.9 3

32290.9 17

32499.5 24

32705.8 42

32914.9 55

33123.1 79

33331.9 112

33540.7 105

33747.2 117

33956.5 120

34160.9 119

34367.4 122

34578.3 119

34797.1 112

35006.7 109

35209 118

35419 118

35626.3 124

35827.8 120

36034.5 102

36245.3 76

36454.8 51

36664.7 41

36868.4 39

37076.7 59

37284.9 78

37493.6 96

37701.2 110

37910.9 134

38122.2 146

38335.6 185

38531.4 169

38745.7 130

38963 111

39174.4 56

39387.4 16

39587.1 -15

39787.5 -18

39995.6 12

40199.3 60

40412.5 97

40636.1 111

40828.7 119

41039.2 128

41239.5 134

41453.3 134

41654.9 142

41864.8 123

42071 137

42279.7 128

42489.4 108

42696.9 94

42906.3 88

43108.5 95

43323.7 104

43531 109

43746.9 117

43960.9 133

44156.3 145

44367.4 125

44577 123

44789.3 135

45003.7 121

45196.5 107

45406.6 97

45614.5 90

45820.3 80

46033.7 85

46239.8 99

46446.3 118

46651 129

46861.3 127

47071 128

47286.9 134

47499.3 125

47705.4 125

47906.2 131

48115.8 121

48320.3 111

48528.5 101

48752.2 111

48956.8 112

49152 125

49362.7 163

49585.2 306

49776.3 223

49993.6 105
