temurtas/Capstone_Duayenler/codes/with_c++_handshakeMerged/step/test_13_01.txt

3565.7 302

3985.45 200

10272.6 105

10477.9 105

10693.3 105

10891.5 104

11112.5 105

11321.4 105

11521.1 105

11727.7 105

11931.3 105

12145.8 105

12359.6 104

12564.4 104

12772.1 105

12990.8 104

13199.9 104

13399.7 105

13601.4 104

13807.5 105

14019.5 104

14224.9 105

14435.8 105

14632.7 105

14848 104

15071.6 105

15283.4 105

15479.7 104

15701.6 104

15903.3 111

16101.2 110

16307.7 110

16521.1 110

16735.7 108

16944.1 80

17150.5 42

17357.8 26

17569.2 36

17775.1 57

17983.1 89

18198.6 114

18399.8 111

18615.6 113

18829.6 109

19023.1 98

19234.2 84

19440.9 80

19647.2 80

19866.3 87

20121.2 97

20328.9 108

20536.7 118

20702 123

20898.6 124

21098.2 111

21310.9 90

21508.1 55

21723.6 37

21928.9 30

22140.4 65

22361.3 105

22567.8 133

22774.2 137

22983.7 148

23174.9 144

23400.7 148

23600.1 120

23808.9 97

24006.3 74

24223 63

24432.7 63

24651.2 78

24848.2 102

25055.3 109

25260.5 114

25490.2 120

25681.2 131

25887.4 126

26092.5 112

26304.3 86

26512 55

26720.8 15

26928.8 36

27138.2 72

27343.3 136

27548.6 230

27758 308

27978.4 246

28178.4 104

28392.5 -710

28806.4 150

29073.2 187

29266.1 91
