temurtas/Capstone_Duayenler/codes/with_c++_handshakeMerged/step/test_13_02.txt

7983.07 -10

8200.51 -9

8413.77 -9

8612.74 -8

8827.01 -8

9020.66 -10

9245.03 -9

9445.89 -9

9649.38 -9

9863.53 -9

10065.8 -9

10281.7 -9

10494.4 -9

10695.8 -8

10899.4 -8

11115.6 -8

11320.6 -8

11538.4 -10

11732.5 -9

11946.6 -9

12152.9 -9

12360.4 -9

12558.9 -9

12771.7 -8

12983.2 -9

13194.4 -9

13406.6 -8

13609.5 -8

13816.2 -9

14022.7 -9

14234.6 -9

14444.5 -8

14650.3 -8

14853.5 -8

15064.7 -9

15273.7 -8

15486 -8

15688.1 -9

15893.9 -8

16114.8 -9

16326.1 -9

16554.6 -8

16733.5 -9

16939.1 -9

17155.2 -9

17366.4 -8

17574.3 -9

17780.3 -9

17987.4 -9

18197.5 -9

18401.9 -9

18606.5 -9

18807.4 -9

19020.6 -8

19256.1 -9

19446 -10

19646.2 -8

19856.5 -8

20062.3 -9

20273.8 -9

20484.8 -8

20697 -9

20895.9 -9

21108.5 -9

21306.4 -9

21520.4 -9

21729.7 -9

21937.8 -9

22140.3 -8

22353.7 -9

22564.5 -9

22762 -8

23002.4 -8

23182 -9

23394.1 -9

23597.5 -9

23816.5 -9

24037.8 -9

24238.3 -9

24445.2 -9

24653.5 -9

24862 -9

25069.2 -8

25277 -8

25479.4 -9

25685.7 -9

25900.6 -9

26101.1 -8

26307.4 -9

26514.5 -9

26724.9 -8

26936.6 -9

27140.8 -9

27361.9 -10

27559.6 -9

27768.4 -9

27970.8 -9

28177.4 -9

28400.7 -9

28605.8 -9

28813.4 -9

29022.1 -9

29228.2 -8

29436.9 -8

29646.3 -9

29856.3 -8

30061.9 -9

30264.8 -9

30472.5 -9

30677.5 -9

30893 -9

31099.2 -9

31329.3 -8

31528.9 -8

31731.9 -14

31933.1 -19

32141.2 -29

32344.7 -19

32568.9 0

32759.5 22

32968.2 47

33180.5 30

33392 24

33591.9 25

33795.2 24

34010.8 50

34222.6 104

34437.8 135

34634.8 362

34839.3 156

36916.1 -18

37136.2 -18

37347.9 -29

37541.3 -18

37750.5 -9

39416.6 18

39624.6 24

39832 69

40042.1 69

40255.8 77

40462.4 404

40671.9 164

40887.9 72

41089.9 13

41312.5 25

41526.6 9

41724.4 21

41928.1 16

42128.3 16

42341.2 17

42546.8 15

42754.5 14

42966.4 14

43178.5 14

43384.1 17

43594 17

43802.6 41

44013.1 45

44217.3 51

44425.4 60

44627.9 73

44838.5 70

45056.8 72

45268.7 63

45478.6 60

45677.1 56

45888.5 58

46114.7 70

46322 84

46518.9 98

46718.3 106

46932.6 99

47145.5 77

47357.1 49

47546.6 41

47754.7 54

47962 56

48169.4 64

48383.8 74

48589.8 84

48793.2 96

49001.6 105

49213.6 109

49423.3 88

49629 142

49841 117

50047.5 82

50261.6 37

50466.7 11

50676.4 4

50891.3 29

51087 66

51297.9 113

51501.7 132

51707.4 122

51926.7 139

52124.2 123

52336.8 105

52543.8 82

52755.1 64

52963.7 47

53171.2 54

53378.5 73

53588.8 105

53793.9 120

54006.9 121

54217.2 107

54421.8 94

54637.5 88

54842.5 86

55043.9 95

55251.1 99

55476 101

55677.9 100

55893.6 93

56094.2 98

56296 104

56504.2 108

56715.9 111

56923.5 102

57131.8 92

57336.1 75

57540.9 67

57749.7 55

57960.4 65

58170 87

58384.2 110

58585 131

58792 120

59000.3 116

59208.6 129

59414.2 118

59624 114

59839.3 125

60038.6 141

60261.5 144

60471 2967
