temurtas/Capstone_Duayenler/codes/with_c++_handshakeMerged/step/test_15_01.txt

3579.58 252

3982.64 206

7837.07 126

8041.3 125

8246.4 126

8461.15 127

8673.05 126

8886.99 126

9088.41 127

9294.75 124

9503.96 125

9711.55 125

9916.89 125

10127.7 126

10341.6 125

10538.6 127

10742 126

10959.9 125

11172.5 125

11381.9 125

11579.9 126

11807.1 125

12004.3 125

12222.9 126

12428.4 125

12633.8 126

12837.8 127

13053.1 124

13261.4 125

13473.4 126

13677.7 126

13884.9 127

14091.4 125

14303.4 127

14505.1 126

14712.1 125

14923.6 123

15130.9 121

15356.3 125

15565.2 103

15755.2 22

15965.8 -13

16173.1 80

16397.2 5

16608.3 23

16811.6 30

17042 28

17229.7 84

17449 58

17641.2 84

17841 29

18057.4 25

18258.7 40

18463 26

18670.9 89

18892.3 82

19095.3 64

19321 86

19504.5 75

19718.1 81

19928 82

20140.4 79

20350.2 65

20553.3 15

20760.2 60

20971.2 12

21170.7 8

21381.8 23

21593.9 25

21825.3 44

22038.1 7

22225.1 8

22418.2 13

22627.6 15

22835.2 15

23043.4 16

23252.5 14

23460.4 13

23659.3 13

23874.7 13

24083.1 13

24292.4 12

24506.6 15

24714.8 14

24916.8 11

25128.9 21

25343.4 64

25559.7 96

25780.6 98

25978.9 150

26171.1 149

26384 129

26602.7 122

26799.2 82

27001.4 43

27219.5 12

27414.4 6

27626 17

27838.3 55

28038.8 91

28256.9 114

28468.1 131

28661 134

28862.1 129

29073.3 110

29288.8 90

29505.8 61

29706 41

29912.2 41

30121.7 64

30326.3 98

30533.9 127

30740.7 121

30954.4 121

31171.2 100

31371.3 64

31586.3 33

31796.9 21

31990.8 34

32203.8 54

32411.6 79

32616.6 114

32823.3 114

33031.6 125

33240 131

33448.7 126

33654.8 126

33866.6 125

34071.8 127

34287.5 97

34503.2 56

34702.5 28

34913.1 23

35121.7 35

35334.1 67

35556.1 105

35738.5 104

35952.9 103

36155.4 91

36378.4 76

36585.5 76

36788.7 80

36993.8 100

37200.1 117

37418 138

37624.6 184

37824.9 286

38036.4 181

38246.2 -130

39338.6 102

39583.7 -120

39872.6 -313

40233.3 -295

40429 -294

40665.9 -336

40938.7 -22

41271.8 -40

41502.1 -96

41693.7 66

41892.5 151

42077.8 154

42978.7 149
