temurtas/Capstone_Duayenler/codes/with_c++_handshakeMerged/step/test_20_01.txt

7976.26 53

8195.23 53

8447.57 92

8615.88 53

8805.76 1

9016.63 1

9216.56 -133

9430.94 1

9652.42 1

9869.7 4

10070.5 51

10275.5 53

10483.9 76

10685.8 52

10889.5 53

11102.8 75

11308.3 92

11518.6 76

11717.1 51

11935.7 75

12148.4 52

12353.4 92

12559.5 53

12766.9 52

12991.9 134

13189.6 75

13395.1 92

13616.2 137

13815.1 54

14008.2 53

14224.2 123

14435.8 92

14645.5 75

14854.7 52

15063.6 113

15268.4 54

15480.6 92

15688.4 52

15892.9 52

16106.7 53

16305.1 52

16508.3 92

16728.4 91

16933 51

17138.5 53

17369.6 54

17551.7 75

17775.4 83

17976.2 91

18189.7 96

18408.9 96

18605 91

18814 94

19024.8 53

19226.6 77

19434.9 56

19646.6 89

19855.7 89

20068.3 88

20273 89

20465.3 54

20687 54

20890.9 99

21093.6 90

21304.1 40

21507.2 -11

21716.2 -33

21931.8 -24

22141.8 28

22355 82

22561.5 126

22772.2 126

22983.1 84

23191.9 11

23388 -62

23597.2 -75

23807.8 -41

24013.4 41

24218.2 127

24425.9 207

24638.3 232

24864.3 183

25058.9 87

25262 -54

25470.9 -153

25676.7 -196

25883.1 -128

26091.4 5

26305.6 176

26524.2 363

26730.6 459

26933.3 373

27135 169

27347 -55

27554.2 -293

27756.6 -285

27974.1 -429

28167.6 -230

28384.3 23

28585.7 307

29412.3 141

29624.2 404

29831.1 289

30062.4 -1215

30253.6 14

31088.9 121

31305.9 952
