temurtas/Capstone_Duayenler/codes/with_c++_handshakeMerged/step/test_birgarip.txt

18052.9 308

18247.6 293

19909.3 293

20114.6 248

20345.5 276

21159.4 273

21387.6 263

21626.9 263

22201.6 213

22405.4 219

22619.1 220

22828.2 169

23036.5 164

23246 152

23453.1 137

23661.6 85

23869.6 296

24099.8 383

24297.8 218

24505.9 -112

24732.7 -26

24955.4 -213

25167.5 -232

25355.5 -91

25598.3 201

25809.2 -365

25990.6 -28

26166.6 187

26384.5 188

26582.5 125

26789.8 66

26996.4 3

27202.2 16

27412.1 16

27626.9 18

27825.9 8

28042.9 11

28251.6 11

28457.2 12

28666.7 11

28879 11

29073.6 11

29282 11

29486.8 11

29701.8 11

29905.9 11

30115.4 11

30334.6 12

30549.3 11

30743.1 11

30954.1 11

31159.5 6

31369.4 -14

31571.2 -19

31785.6 -21

31998.1 -7

32206.6 11

32405.8 45

32615.1 49

32826.3 17

33030.4 11

33238.3 7

33447.9 -7

33658.1 0

33867.5 -1

34068.9 -4

34281.6 -14

34510.4 10

34703.9 9

34911.6 -17

35118.3 -41

35325.6 -60

35535.7 -55

35741 -55

35956.4 -57

36154.8 -57

36363.2 -56

36569.6 -56

36784 -56

36994.5 -56

37211.6 -56

37408.6 -55

37606.9 -56

37825.7 -56

38032.7 -56

38238.2 -60

38448.1 -60

38657.3 -53

38861.3 -51

39067.3 -14

39276.6 -7

39482.8 15

39692 -4

39904.7 4

40112.4 -3

40325.1 -11

40527 2

40744.1 10

40943.6 6

41152.8 9

41357.3 3

41570.9 6

41777 5

41989.7 6

42206.9 5

42413.3 5

42610.5 5

42822.3 4

43029.1 5

43226.3 4

43440.9 6

43642.4 5

43872 4

44065.3 5

44286.9 5

44489.3 5

44692.6 5

44902.1 4

45106.2 6

45318.9 5

45529.5 4

45728.5 7

45936.5 5

46146.6 5

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
39365.5 123

39573.1 114

39783.1 117

39998 112

40202.6 95

40408.9 74

40617.8 69

40830 75

41035 78

41252.9 95

41444.4 115

41657.2 126

41869.2 135

42080.4 133

42293.1 122

42503.5 102

42714.5 -839

42931.5 100

43117.9 -18

43952.9 -51

45616.5 73

45825.5 90

46077.2 -69

46344.8 509
