temurtas/Capstone_Duayenler/codes/Step_Responses/test (2).txt

23113.4 15

23381.9 -20

23597.3 -213

23807 -232

23999.8 -232

24207.4 -242

24381.6 -242

24586.6 -195

24800.9 -278

25063.4 -1

25237.7 15

25409 14

25615.6 14

25823.7 15

26033.6 14

26242.4 14

26457.7 15

26655.2 15

26858.3 15

27081.2 15

27287.9 14

27496 15

27720.2 15

27912.2 15

28115.7 14

28325.3 14

28540.6 14

28745.1 16

28941.9 15

29150.9 15

29362 14

29569.4 15

29776 14

29986.9 14

30197.1 14

30403.2 15

30613.2 15

30825 15

31024.8 15

31232.1 15

31445.5 14

31649.3 15

31864.3 14

32065.7 14

32281.2 15

32482.3 14

32693.6 13

32905.9 12

33114.7 7

33317 7

33550.9 5

33731.5 5

33938.8 -1

34154.3 -5

34352.4 -5

34567.1 -4

34783.3 -2

35007.4 -3

35190.7 -3

35398.7 -3

35612 -3

35821 -3

36018.7 -3

36223.7 -4

36433.8 -3

36642.8 -3

36854.5 -3

37058.4 -3

37265.4 -2

37475 -3

37685.1 -3

37894.3 -3

38103 -3

38312.4 -3

38534.3 -2

38742.4 -3

38948.6 -4

39169.1 -3

39363.2 -4

39562.6 -4

39776.6 -3

39986.4 -3

40179.4 -3

40399.5 -3

40595 -3

40814.4 -2

41013.9 -2

41222.7 2

41428.3 6

41634.5 13

41849.6 7

42055.2 5

42264 5

42473.5 6

42679.2 5

42889.4 5

43092.8 5

43305.7 5

43515.1 5

43745.2 5

43932.8 6

44136.6 8

44341.6 8

44551.5 8

44757.8 8

44966.3 4

45188.3 23

45382.7 53

45595.2 88

45802.9 26

46005.7 43

46213.3 58

46421.9 67

46627.4 97

46835.5 118

47044.6 141

47258.7 158

47467.6 176

47667.3 174

47877.6 155

48090.2 104

48297.1 47

48504.8 94

48714.5 58

48924.1 31

49133.3 6

49338.3 3

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
151006 -359

151209 -359

151420 -359

151619 -208

151835 -210

152041 -208

152260 -358

152468 -208

152662 -358

152867 -358

153081 -358

153306 -207

153492 -359

153709 -208

153927 -358

154121 -359

154324 -359

154537 -208

154760 -210

154953 -209

155160 -359

155376 -209

155596 -208
