temurtas/Capstone_Duayenler/codes/homography/result.png

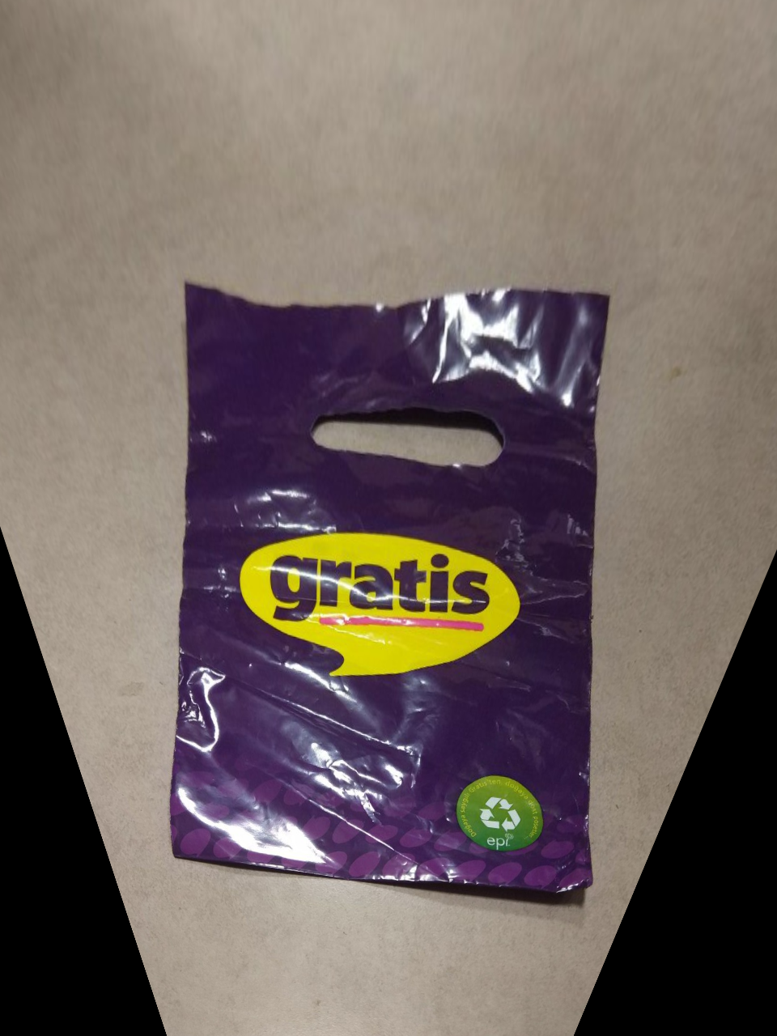
codes/homography/result.png
