temurtas/Capstone_Duayenler/reports/proposal_report/images/project_evaluation2.png

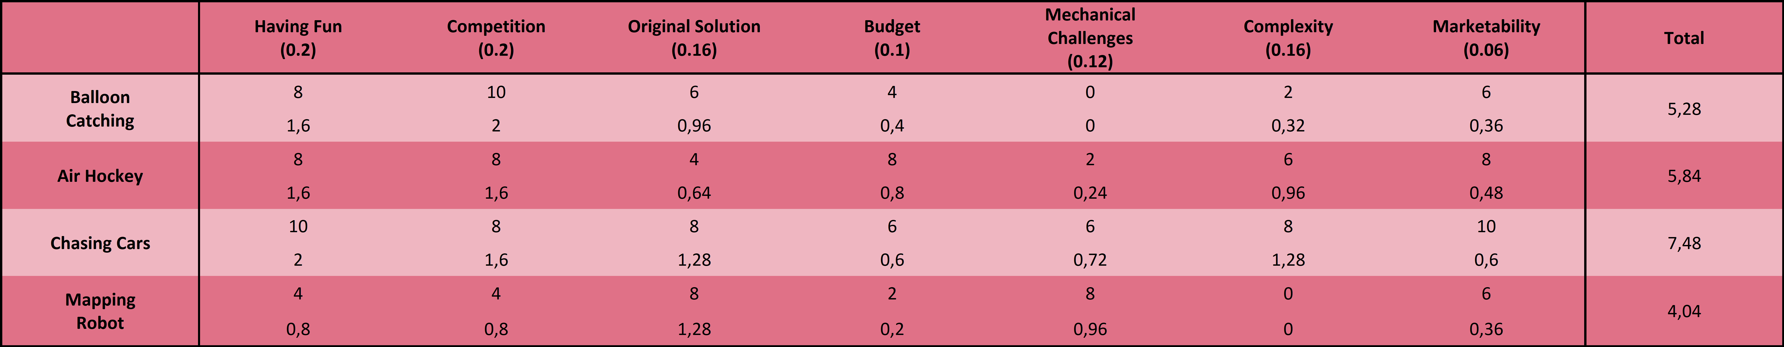
reports/proposal_report/images/project_evaluation2.png
