temurtas/Capstone_Duayenler/reports/proposal_report/images/project_evaluation3.png

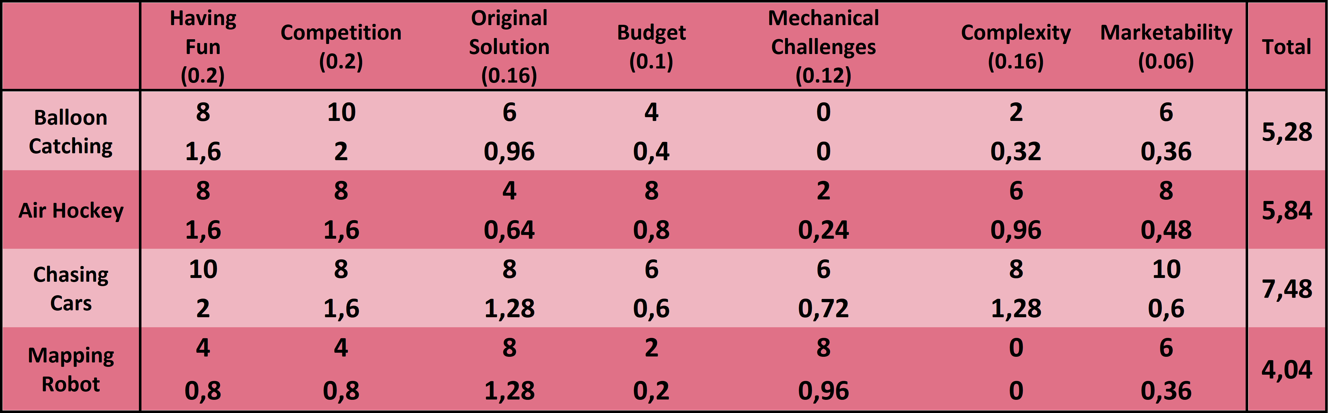
reports/proposal_report/images/project_evaluation3.png
