temurtas/Capstone_Duayenler/reports/proposal_report/images/project_evaluation.png

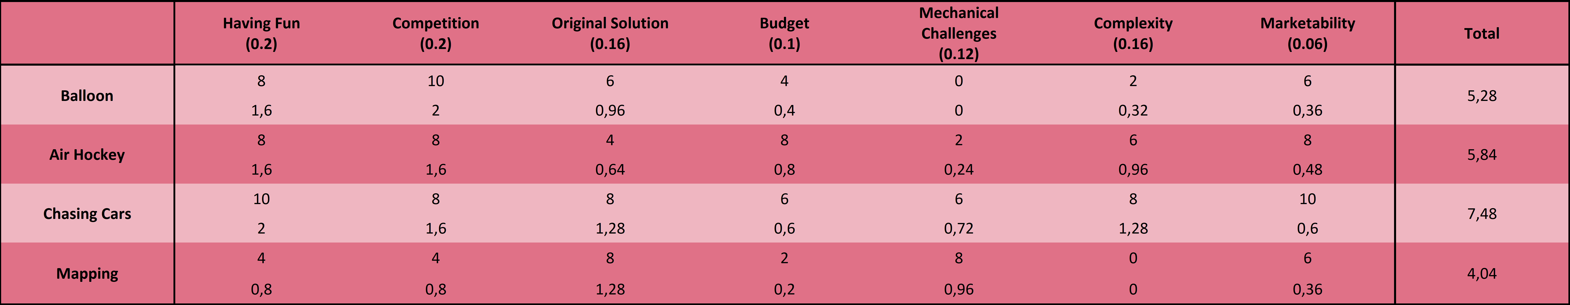
reports/proposal_report/images/project_evaluation.png
