temurtas/Capstone_Duayenler/reports/Std_HW/handshake-protocol2.pdf

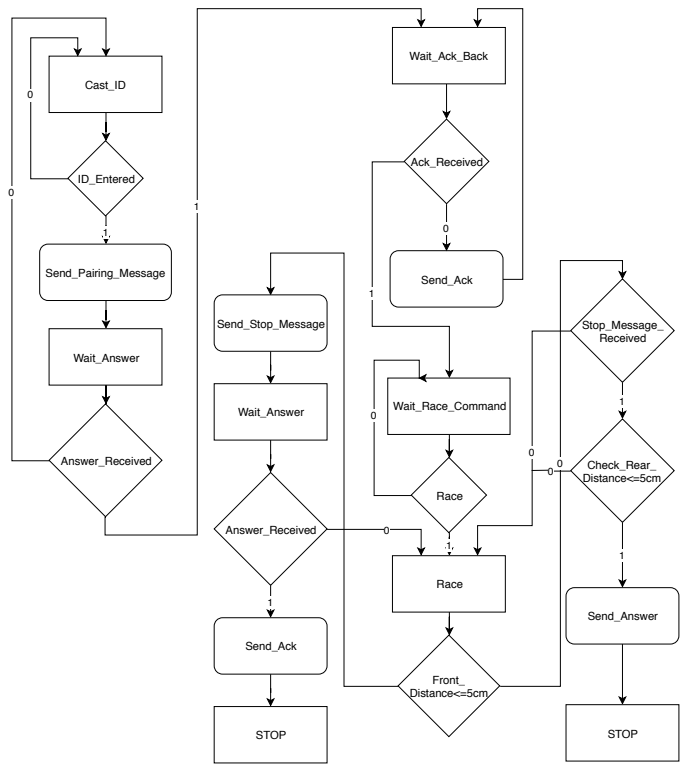
[picture p313: page 1]
Cast_ID; ID_Entered; Send_Pairing_Message; Wait_Answer; Answer_Received; Send_Ack; Wait_Race_Command; Race; Front_ Distance<=5cm; Send_Stop_Message; STOP; Stop_Message_ Received; Send_Answer; Check_Rear_ Distance<=5cm; Wait_Ack_Back; Ack_Received
