temurtas/Capstone_Duayenler/codes/wireless_communication/bluetooth/b-t-v-2/b-t-v-2.ino

 
#include <SoftwareSerial.h>
SoftwareSerial BTserial(2, 3); // RX | TX
// Connect the HC-05 TX to Arduino pin 2 RX. 
// Connect the HC-05 RX to Arduino pin 3 TX through a voltage divider.
// 
 
char c = ' ';
 
void setup() 
{
    Serial.begin(9600);
    Serial.println("Arduino is ready");
 
    // HC-05 default serial speed for commincation mode is 9600
    BTserial.begin(9600);  
    BTserial.write("AT+NAME=Enesinki");
    
}
 
void loop()
{
 
    // Keep reading from HC-05 and send to Arduino Serial Monitor
    if (BTserial.available())
    {  
        c = BTserial.read();
        Serial.write(c);
    }
 
    // Keep reading from Arduino Serial Monitor and send to HC-05
    if (Serial.available())
    {
        c =  Serial.read();
        BTserial.write(c);  
    }
 
}
