temurtas/Capstone_Duayenler/(commit log)

2018-10-18 bazı klasör ve read.me değişklikleri, time table added
    [Interesting-stuff.xlsx, Interesting_stuff.xlsx, component-lst.xlsx, component_list.xlsx, schedule.xlsx]
2018-10-20 findings about mapper robot
    [Requirements.xlsx, findings_about_projects.xlsx]
2018-10-20 distance sensors for excel
    [component_list.xlsx]
2018-10-20 camera options added
    [component_list.xlsx]
2018-10-20 adding datasheet and component
    [component_list.xlsx]
2018-10-20 linked in excel turned clickable
    [component_list.xlsx]
2018-10-20 datasheetler linklendi
    [component_list.xlsx]
2018-10-21 Vehicles solutions added, RF and onboard camera findings added
    [component_list.xlsx, findings_about_projects.xlsx]
2018-10-25 new image sensor added.
    [component_list.xlsx]
2018-10-26 motor guides for weekly report
    [findings_about_projects.xlsx]
2018-10-27 some sample codes added
2018-10-27 intresting stuff update
    [Interesting_stuff.xlsx]
2018-10-28 Color Sensor Added.
    [component_list.xlsx]
2018-10-28 Weekly progress updated.Color sensor info. added
2018-10-28 fixing missing parts
    [component_list.xlsx]
2018-10-28 adding componenet
    [component_list.xlsx]
2018-10-28 datasheet + componenet added
    [component_list.xlsx]
2018-10-29 weekly report update
    [component_list.xlsx]
2018-10-31 objective tree and evaluation added
    [objective_tree.xlsx]
2018-11-01 daily update
    [objective_tree.xlsx]
2018-11-02 gannt chart added
    [gannt_chart.xlsx]
2018-11-02 gannt update
    [gannt_chart.xlsx]
2018-11-04 update table
    [objective_tree.xlsx]
2018-11-04 system flow image
2018-11-04 update 3 for reqs section
    [objective_tree.xlsx]
2018-11-04 weekly update, prop. intro added
2018-11-04 motors unit
2018-11-08 gannt update2
    [gantt_chart.xlsx]
2018-11-08 req sect finil
    [objective_tree.xlsx]
2018-11-12 Camera and IR sensors expense added
2018-11-25 parça addition
    [component_list.xlsx]
2018-12-04 some arduino codes added
2018-12-12 homography and rpi-arduino serial com codes added
2018-12-12 clean the directories
    [gantt_chart.xlsx, objective_tree.xlsx, schedule.xlsx]
2018-12-26 conceptual update
    [gantt_chart.xlsx]
2018-12-26 chasis&pcb added
2018-12-27 sunum update
    [gantt_chart.xlsx]
2018-12-28 pıd code added
2019-03-03 chassis completed
    [base1.SLDPRT, chassis.DWG, chassis.SLDPRT, motor-holderSLDPRT.SLDPRT]
2019-03-05 sarpers part, gantt and some improvements added
    [gantt_chart.xlsx]
2019-03-21 controller minor update-pwm subtraction from slower motor
2019-04-20 handshake c code is corrected
    [with.c]
2019-04-20 LEDs are added
2019-04-21 LED code is corrected
    [with.cpp]
2019-04-21 Raspberry Codes were integrated
2019-04-28 Daily PID Tuning Activity and Final Report Data
2019-05-05 voltage supply text file
2019-05-08 discussion on PID controller subsystem
2019-05-09 sensor tests
2019-05-10 power and cost
2019-05-10 motor subsystem
2019-05-15 remaining materials
    [chassis2.0.DWG, chassis3.0.DWG]
